xuzhihao-248/roboticArm/doc/tasks.md

# Dummy 机械臂任务拆分

> 基于 `proposal.md` 需求文档拆分 | 更新日期：2026/05/23

---

## 使用说明

- 每个任务标记状态：⬜ 待开始 / 🔄 进行中 / ✅ 完成 / ❌ 阻塞
- 带 `[前置]` 的任务需等待前面任务完成

---

## 一期：复刻原版 Dummy（第 1-12 周）

### T1.1 前置准备

| ID | 任务 | 预估时间 | 状态 |
|----|---|---|---|
| T1.1.1 | 搭建 Git 仓库，配置协作环境 | 0.5 天 | ✅ |
| T1.1.2 | 补习第零阶段知识（STM32/C++/机器人学/电子） | 2 周 | ⬜ |
| T1.1.3 | 安装 STM32CubeIDE、CubeMX、ST-LINK Utility | 0.5 天 | ⬜ |
| T1.1.4 | [前置] 购买 ST-Link V2 调试器、USB-CAN 调试器 | 下单即完成 | ⬜ |

### T1.2 PCB 打样与焊接

| ID | 任务 | 预估时间 | 状态 |
|----|---|---|---|
| T1.2.1 | 上传 MotorDriver-42 Gerber 到嘉立创下单（6 块） | 0.5 天 | ⬜ |
| T1.2.2 | [前置] 导出 Controller/MotorDriver-20/HandModule/LEDRing 的 Gerber | 1 天 | ⬜ |
| T1.2.3 | [前置] 上述 4 块板子下单打样 | 0.5 天 | ⬜ |
| T1.2.4 | [前置] 导出全部板子的 BOM 物料清单 | 1 天 | ⬜ |
| T1.2.5 | [前置] 采购电子元器件（电阻/电容/芯片/接插件） | 下单等待 | ⬜ |
| T1.2.6 | 焊接练习板练手（0603 + SOP-8 + LQFP-48） | 3 天 | ⬜ |
| T1.2.7 | 焊接 6 块 MotorDriver-42 驱动板 | 4 天 | ⬜ |
| T1.2.8 | 焊接 Controller 核心板 | 2 天 | ⬜ |
| T1.2.9 | 焊接 MotorDriver-20 / HandModule / LED Ring | 2 天 | ⬜ |

### T1.3 机械与装配

| ID | 任务 | 预估时间 | 状态 |
|----|---|---|---|
| T1.3.1 | 打开 STEP 模型测量各关节减速器安装空间 | 1 天 | ⬜ |
| T1.3.2 | 先买 1 个 CSF-17-30 谐波减速器样品确认接口 | 下单等待 | ⬜ |
| T1.3.3 | [前置] 样品确认后买齐 6 个减速器（J1-J6 不同型号） | 下单等待 | ⬜ |
| T1.3.4 | 采购 42 步进电机 ×6 + 20 步进电机 ×1 | 下单等待 | ⬜ |
| T1.3.5 | 采购 24V 开关电源 | 下单等待 | ⬜ |
| T1.3.6 | CNC 加工厂报价比价 | 2 天 | ⬜ |
| T1.3.7 | [前置] 确认图纸 → 下单 CNC 加工 | 等待加工 | ⬜ |
| T1.3.8 | [前置] CNC 件回来后检查公差、试组装 | 2 天 | ⬜ |
| T1.3.9 | 总装：结构件 + 减速器 + 电机 + 走线 | 3 天 | ⬜ |

### T1.4 固件烧录与调试

| ID | 任务 | 预估时间 | 状态 |
|----|---|---|---|
| T1.4.1 | 烧录电机驱动固件到 6 块 MotorDriver-42 | 0.5 天 | ⬜ |
| T1.4.2 | 逐块上电校准编码器，确认按键功能正常 | 1 天 | ⬜ |
| T1.4.3 | 烧录核心固件到 Controller | 0.5 天 | ⬜ |
| T1.4.4 | 配置各电机 CAN ID（6 个不同 ID） | 0.5 天 | ⬜ |
| T1.4.5 | CAN 总线调试：终端电阻、波特率、广播同步 | 2 天 | ⬜ |
| T1.4.6 | 零点归位校准测试 | 1 天 | ⬜ |

### T1.5 联调与验收

| ID | 任务 | 预估时间 | 状态 |
|----|---|---|---|
| T1.5.1 | CLI 工具环境搭建（Python + pyserial + python-can） | 0.5 天 | ⬜ |
| T1.5.2 | CLI 连接机械臂，发送单关节指令 | 1 天 | ⬜ |
| T1.5.3 | MoveJ 多关节同步运动测试 | 1 天 | ⬜ |
| T1.5.4 | 正逆运动学验证（给角度→末端到位姿，给位姿→角度） | 1 天 | ⬜ |
| T1.5.5 | 三种指令模式测试（SEQ/INT/TRJ） | 1 天 | ⬜ |
| T1.5.6 | DummyStudio 连接与图形化控制 | 1 天 | ⬜ |
| T1.5.7 | 整机验收：F1.1-F1.7 全部验收标准通过 | 1 天 | ⬜ |

---

## 二期：核心原理掌握（第 13-18 周）

| ID | 任务 | 产出 | 状态 |
|----|---|---|---|
| T2.1 | 阅读 `Robot/kinematics.cpp`，DH 参数推导验证 | DH 参数验证笔记 | ⬜ |
| T2.2 | 用 Python 实现正运动学（与固件结果对比） | `selfModel/kinematics/forward.py` | ⬜ |
| T2.3 | 用 Python 实现逆运动学（Pieper 准则求 8 组解） | `selfModel/kinematics/inverse.py` | ⬜ |
| T2.4 | 阅读 `Robot/trajectory.cpp`，理解梯形加减速 | 轨迹规划笔记 | ⬜ |
| T2.5 | Python 实现梯形加减速插值，可视化验证 | `selfModel/trajectory/planner.py` | ⬜ |
| T2.6 | 阅读 `Ctrl/` 电机控制代码（FOC/PID/编码器） | 控制算法笔记 | ⬜ |
| T2.7 | 修改 PID 参数对比效果 | PID 调参记录 | ⬜ |
| T2.8 | 阅读 `UserApp/interface_can.cpp`，理解 CAN 协议 | 协议文档 | ⬜ |
| T2.9 | 在固件中新增一个自定义 CAN 指令并验证 | 自定义指令测试通过 | ⬜ |
| T2.10 | 阅读 FreeRTOS 任务架构，新增一个测试 Task | 测试 Task 运行正常 | ⬜ |

---

## 三期：视觉抓取系统（第 19-28 周）

| ID | 任务 | 产出 | 状态 |
|----|---|---|---|
| T3.1 | 采购 RGB-D 相机，设计打印相机支架 | 相机 + 支架安装到位 | ⬜ |
| T3.2 | Eye-to-hand 手眼标定 | 标定矩阵，误差 < 2mm | ⬜ |
| T3.3 | 采集 3 种目标物体的 RGB-D 数据 | 数据集 | ⬜ |
| T3.4 | YOLOv8 训练物体检测模型 | 检测准确率 > 90% | ⬜ |
| T3.5 | 点云分割 + 3D 位姿估计 | 位姿误差 < 5mm | ⬜ |
| T3.6 | 实现抓取规划（几何分析 + 碰撞检测） | `selfModel/grasp/planner.py` | ⬜ |
| T3.7 | 封装抓取控制 API（检测→计算→抓取） | `selfModel/grasp/controller.py` | ⬜ |
| T3.8 | 单物体抓取集成测试 | 成功率 > 80% | ⬜ |
| T3.9 | 多物体场景抓取 | 能按指令选择目标 | ⬜ |

---

## 四期：移动底盘 + SLAM（第 29-38 周）

| ID | 任务 | 产出 | 状态 |
|----|---|---|---|
| T4.1 | 采购工控机（Jetson Nano）、激光雷达、底盘 | 硬件到位 | ⬜ |
| T4.2 | 工控机部署 ROS 2 Humble + 依赖包 | ROS 2 环境运行 | ⬜ |
| T4.3 | 底盘电机驱动调试（差速控制） | 底盘可控 | ⬜ |
| T4.4 | 激光雷达 ROS 驱动 + 数据可视化 | 点云正常显示 | ⬜ |
| T4.5 | SLAM 建图（Cartographer） | 室内地图生成 | ⬜ |
| T4.6 | Nav2 导航栈配置与测试 | 自主导航成功 | ⬜ |
| T4.7 | 机械臂-底盘集成（物理安装 + 通信） | 工控机 ↔ STM32 通信正常 | ⬜ |
| T4.8 | 定点停靠 + 操作任务集成测试 | 移动到目标→抓取→返回 | ⬜ |

---

## 五期：VLA 自然语言操控（第 39-50 周）

| ID | 任务 | 产出 | 状态 |
|----|---|---|---|
| T5.1 | 封装机械臂 Python 控制 API（关节/位姿/夹爪） | `selfModel/api/robot_api.py` | ⬜ |
| T5.2 | 部署 Whisper 语音识别 | 语音→文字可用 | ⬜ |
| T5.3 | 部署本地 LLM（Qwen2.5-VL）或接入 API | LLM 可调用 | ⬜ |
| T5.4 | 设计任务 Prompt，让 LLM 输出 API 调用序列 | Prompt 模板 | ⬜ |
| T5.5 | 实现单步指令（"抓起红色方块"） | 单步执行成功 | ⬜ |
| T5.6 | 实现多步指令（"把桌上的红色方块放到蓝色盒子里"） | 多步执行成功 | ⬜ |
| T5.7 | 加入视觉反馈闭环（执行→拍照确认→重试/继续） | 闭环纠错正常 | ⬜ |
| T5.8 | 端到端集成测试 | 自然语言操控机械臂完整演示 | ⬜ |

---

## 状态总览

| 阶段 | 任务数 | 完成 | 进度 |
|---|---|---|---|
| 一期 | 27 | 1 | 4% |
| 二期 | 10 | 0 | 0% |
| 三期 | 9 | 0 | 0% |
| 四期 | 8 | 0 | 0% |
| 五期 | 8 | 0 | 0% |
| **合计** | **62** | **1** | **2%** |

---

## 当前阻塞项

（暂无）
