xuzhihao-248/roboticArm/doc/源项目解读/电路板解析.md

# Dummy Robot 电路板解析

> 硬件来源：`my/HardWarePCB/MotorDriver-42/`
> 固件来源：`raw/dummy/zhihui原版/Dummy-Robot-main/Firmware/`
> 工具：Altium Designer（.SchDoc / .PcbDoc）
> 更新：2026/06/07

---

## 一、总览

驱动板（MotorDriver-42）是一块**完整的步进电机闭环驱动器**，每块板独立控制一个电机，6 个电机通过 CAN 总线菊花链串联。

| 组件 | 型号 | 作用 |
|---|---|---|
| MCU | **STM32F103CBT6** | Cortex-M3，电机控制算法 + CAN 通信 |
| 电机驱动 | **TB67H450**（东芝） | 双 H 桥，驱动两相步进电机 |
| 编码器 | **MT6816**（MagnTek） | 14-bit 磁编码器，SPI 接口，位置反馈 |
| CAN 收发器 | **SN65HVD232DR** | CAN 2.0 差分信号收发 |
| 电源 | **ME3116** DC-DC + **LP2992** 3.3V LDO | 降压到 5V 后经 LDO 出 3.3V（供 MCU） |
| 电压基准 | **TL431IDBZT** | 精密电压基准 |
| 升压 | **TPS61040DBV** | 升压转换器 |
| 状态灯 | 2× **WS2812B** RGB LED | 可编程指示灯（通信/错误状态） |
| 晶振 | 12MHz HSE | 外部高速时钟 |

---

## 二、原理图详解

PDF 文件：`my/HardWarePCB/MotorDriver-42/Motor-42.pdf`（Altium Designer 导出，共 4 页）

### 2.1 MCU Sheet — 主控与通信

```
                    ┌─────────────────┐
    CAN_H/CAN_L ───┤  SN65HVD232DR   │
                    │  CAN 收发器      │
                    └────────┬────────┘
                             │ TX/RX
                    ┌────────┴────────┐
    SWDIO/SWCLK ───┤  STM32F103CBT6  │
                    │  主控 MCU        │
                    └──┬────┬────┬───┘
                       │    │    │
              J3(编码器) J2(接口) WS2812B×2
              SPI       GPIO    状态灯
```

**关键器件：**

| 器件 | 型号 | 引脚/接口 |
|---|---|---|
| U3 | **STM32F103CBT6** | SWDIO(PA13)、SWCLK(PA14)、CAN_TX(PA12)、CAN_RX(PA11) |
| U4 | **SN65HVD232DR** | CANH → J2.2、CANL → J2.1 |
| U6 | ME3116 | DC-DC 降压，VIN → 5V |
| U7 | LP2992-3.3 | 3.3V LDO，供 MCU |
| U4 | TL431IDBZT | 精密电压基准 |
| U11 | TPS61040DBV | 升压转换器 |
| U1 | 12MHz 晶振 | OSC_IN(PD0)、OSC_OUT(PD1) |
| LED1、LED2 | **WS2812B** | 数据线串联，可编程 RGB |
| SW1、SW2 | 按键 | 配置/复位 |
| J1 | 电源接口 | VIN(+) / GND(-) |
| J2 | CAN + 按钮 + GPIO | 见下方引脚表 |
| J3 | 编码器接口 | SPI 信号（CLK/IO1/IO2） |
| J4 | SWD 调试接口 | SWDIO / SWCLK / 3V3 / GND |
| J5 | 预留 GPIO | PA1 / PA2 |

**J2 接口引脚表：**

| 引脚 | 信号 | 说明 |
|---|---|---|
| J2.1 | CAN_L | CAN 总线低 |
| J2.2 | CAN_H | CAN 总线高 |
| J2.3 | BUT | 按钮输入 |
| J2.4 | STNBY | TB67H450 待机控制（低电平待机） |
| J2.5 | PA3 | GPIO |
| J2.6 | PB4 | GPIO |

### 2.2 Drive Sheet — 电机驱动

```
        STM32F103
            │
    ┌───────┴───────┐
    │   TB67H450    │
    │  双 H 桥驱动   │
    ├───┬───┬───┬───┤
   Ap  Am  Bp  Bm   │  ← 两相步进电机线圈
    └───┴───┴───┴───┘
        │
    J7 (电机连接器)
```

**关键器件：**

| 器件 | 型号 | 作用 |
|---|---|---|
| U1 | **TB67H450** | 东芝双 H 桥步进电机驱动，支持 PWM 电流控制 |
| C7/C9/C12/C14 | 滤波电容 | 电荷泵和电源滤波 |
| J7 | 电机接口 | Ap / Am / Bp / Bm（两相四线） |

**TB67H450 引脚连接：**

| 引脚 | 连接 | 说明 |
|---|---|---|
| Ap、Am | J7 | A 相线圈正/负 |
| Bp、Bm | J7 | B 相线圈正/负 |
| VCC | 5V | 逻辑电源 |
| VM | VIN | 电机电源 |
| STNBY | J2.4 (PB5) | 待机控制，低电平进入待机 |
| AIN1/AIN2 | STM32 GPIO | A 相桥臂控制 |
| BIN1/BIN2 | STM32 GPIO | B 相桥臂控制 |
| PWMA/PWMB | STM32 TIM | PWM 电流调节 |

### 2.3 编码器接口 — J3

| 引脚 | 信号 | 说明 |
|---|---|---|
| CLK | SPI_SCK | MT6816 时钟 |
| IO1 | SPI_MOSI | MT6816 数据输出 |
| IO2 | SPI_MISO | MT6816 数据输入 |
| 3V3 | 供电 | 3.3V |
| GND | 地 | — |

---

## 三、固件与硬件对应关系

固件路径：`raw/dummy/zhihui原版/Dummy-Robot-main/Firmware/Ctrl-Step-Driver-STM32F1-fw/`

### 3.1 MCU — STM32F103CBT6

| 验证项 | 固件文件 | 说明 |
|---|---|---|
| HAL 库 | `Core/Inc/stm32f1xx_hal_conf.h` :21 | `#ifndef __STM32F1xx_HAL_CONF_H` |
| 中断处理 | `Core/Src/stm32f1xx_it.c` | STM32F1 中断向量表 |
| HAL 驱动 | `Drivers/STM32F1xx_HAL_Driver/` | STM32F1 系列 HAL 库 |
| 启动文件 | `startup/` | STM32F103 启动汇编 |

### 3.2 电机驱动 — TB67H450

| 验证项 | 固件文件 | 行号 | 内容 |
|---|---|---|---|
| 驱动类定义 | `Ctrl/Driver/tb67h450_base.h` | :6 | `class TB67H450Base : public DriverBase` |
| FOC 电流控制 | `Ctrl/Driver/tb67h450_base.h` | :14 | `SetFocCurrentVector()` |
| 双线圈驱动 | `Ctrl/Driver/tb67h450_base.h` | :22 | `SetTwoCoilsCurrent()` — 对应 TB67H450 的 A/B 两相 |
| GPIO 初始化 | `Ctrl/Driver/tb67h450_base.h` | :27 | `InitGpio()` |
| PWM 初始化 | `Ctrl/Driver/tb67h450_base.h` | :29 | `InitPwm()` |

### 3.3 编码器 — MT6816

| 验证项 | 固件文件 | 说明 |
|---|---|---|
| 编码器驱动 | `Ctrl/Sensor/Encoder/mt6816_base.h` | MT6816 磁编码器 SPI 读取 |
| 编码器基类 | `Ctrl/Sensor/Encoder/encoder_base.h` | 编码器抽象接口 |
| 校准器 | `Ctrl/Sensor/Encoder/encoder_calibrator_base.h` | 编码器零位校准 |

### 3.4 CAN 通信 — TJA1051T/3

| 验证项 | 固件文件 | 说明 |
|---|---|---|
| CAN 初始化 | `Core/Inc/can.h` | CAN 外设配置 |
| CAN 收发 | `Core/Src/can.c` | CAN 报文收发实现 |

### 3.5 电机参数（固件默认值）

| 参数 | 值 | 来源 |
|---|-----|---|
| 步距角 | 1.8°（200 步/圈） | `Ctrl/Motor/motor.h` :45 |
| 细分数 | 256 | `Ctrl/Motor/motor.h` :46 |
| 每圈微步数 | 51200 | `motor.h` :47（200×256） |
| 额定电流 | 1000 mA | `motor.h` :17 |
| 校准电流 | 2000 mA | `motor.h` :16 |
| 额定转速 | 30 r/s | `motor.h` :19 |
| 控制频率 | 20 kHz | `motor.h` :192（`Tick20kHz()`） |
| 控制算法 | PID + DCE | `motor.h` :23~35 |

### 3.6 系统时钟配置（HSE_VALUE）

> **背景**：从 BOM 核实到硬件晶振为 12MHz，需验证固件时钟配置是否匹配。

**结论：硬件 12MHz = 固件 12MHz，完全匹配。**

配置生效逻辑：

```
工程编译时 include 顺序：
  1. Core/Inc/stm32f1xx_hal_conf.h :86  →  #define HSE_VALUE  12000000U  ← 先定义
  2. Core/Src/system_stm32f1xx.c  :77  →  #if !defined(HSE_VALUE)         ← 发现已定义，跳过默认值
                                          #define HSE_VALUE  8000000U     ← 此行不生效！
```

| 文件 | 行号 | 内容 | 生效? |
|---|---|---|---|
| `Core/Inc/stm32f1xx_hal_conf.h` | :86 | `#define HSE_VALUE  12000000U` | ✅ 实际生效 |
| `Core/Src/system_stm32f1xx.c` | :78 | `#define HSE_VALUE  8000000U` | ❌ 被 `#if !defined` 跳过 |

> 之前文档误写为 8MHz 是因为只查看了 `system_stm32f1xx.c` 的默认值，未注意到 `hal_conf.h` 中已用 `#if !defined` 宏保护做了覆盖。

**关联影响**：HSE_VALUE 直接影响 STM32 的 PLL 倍频计算、CAN 波特率分频、定时器时钟源。如果晶振频率和固件配置不一致，CAN 总线将无法通信。

---

## 四、CAN 总线拓扑

```
PC ←USB→ Controller（STM32F4 主控）
                │
            CAN 总线（菊花链）
                │
    ┌──┬──┬──┬──┬──┬──┐
   MD1 MD2 MD3 MD4 MD5 MD6   ← 每块 MotorDriver-42 板
   ID=1 ID=2 ID=3 ID=4 ID=5 ID=6
```

- 物理层：CAN 2.0，SN65HVD232DR 收发器
- 每块驱动板有唯一 CAN ID（1~6）
- Controller 转发 PC 指令 → 各驱动板本地闭环控制
- 也可跳过 Controller，PC 通过 USB-CAN 适配器直接发 CAN 指令

---

## 五、使用方式

### 5.1 打样 PCB

1. 将 `my/HardWarePCB/MotorDriver-42/Gerber/` 目录打包为 zip
2. 上传到嘉立创（jlc.com）→ 下单 PCB 打样
3. 5 片约 ¥5~20，5~7 天到货

### 5.2 焊接

1. 打开 `my/HardWarePCB/MotorDriver-42/Motor-42.pdf` 查看原理图
2. 按原理图中的器件型号采购 BOM
3. 焊接顺序建议：电源（AMS1117）→ MCU（STM32F103）→ CAN（TJA1051T）→ 驱动（TB67H450）→ 连接器

### 5.3 烧录固件

**方式一：直接烧 HEX（最快）**

`raw/dummy/.../Firmware/_Released HEX/Ctrl-Step-Driver-STM32F1-fw.hex`
用 ST-Link 连接 J4（SWD 接口），通过 STM32CubeProgrammer 烧录。

**方式二：自行编译**

用 CLion / STM32CubeIDE 打开 `Firmware/Ctrl-Step-Driver-STM32F1-fw/` 工程，编译后烧录。

### 5.4 上位机调试

- **CLI-Tool**：Python 命令行，通过 USB（Fibre 协议）与 Controller 通信
- **DummyStudio**：Unity 桌面应用，图形化控制界面

---

## 六、与本项目的关系

```
MoveIt2 规划 → USB-CAN → Controller 主控板 → CAN 总线 → 6× MotorDriver-42 → 6 个步进电机
```

- Controller 板接收上位机指令，通过 CAN 分发给各驱动板
- 每块驱动板运行 FOC 闭环控制，本地完成位置/速度/电流控制
- 跳过 Controller：PC 通过 USB-CAN 适配器直接发 CAN 指令给驱动板
