xuzhihao-248/roboticArm/doc/源项目解读/固件解析.md

# Dummy Robot 固件解析

> 来源：`raw/dummy/zhihui原版/Dummy-Robot-main/Firmware/`
> 更新：2026/06/07

---

## 一、总览

Firmware 目录下有**两个独立固件工程**，分别对应两块电路板：

| 固件 | 目标芯片 | 对应电路板 | 作用 |
|---|---|---|---|
| **Ctrl-Step-Driver-STM32F1-fw** | STM32F103CBT6 | MotorDriver-42 | 单电机闭环驱动（每块板一个） |
| **Core-STM32F4-fw** | STM32F405RGTx | Controller 主控板 | 6 轴运动协调 + USB/UART/CAN 通信 |

预编译 HEX：`_Released HEX/Ctrl-Step-Driver-STM32F1-fw.hex`（驱动板固件，可直接烧录）

---

## 二、Ctrl-Step-Driver-STM32F1-fw（驱动板固件）

路径：`Firmware/Ctrl-Step-Driver-STM32F1-fw/`

### 2.1 架构

```
UserApp/main.cpp（入口）
    ├── Motor（电机控制核心）
    │   ├── TB67H450（驱动芯片）
    │   ├── MT6816（编码器）
    │   ├── MotionPlanner（轨迹规划）
    │   └── Controller（PID/DCE 闭环）
    ├── CAN 协议（接收 Controller 指令）
    ├── Button × 2（按键交互）
    ├── LED（状态指示）
    └── EEPROM（参数持久化）
```

### 2.2 目录结构

```
Ctrl-Step-Driver-STM32F1-fw/
├── Core/                           ← STM32 HAL 库自动生成
│   ├── Inc/                        ← 头文件（can.h, spi.h, tim.h, gpio.h...）
│   └── Src/                        ← 源文件（can.c, spi.c, tim.c, gpio.c...）
├── Drivers/                        ← STM32 HAL 驱动库
├── Ctrl/                           ← 电机控制算法（核心代码）
│   ├── Driver/
│   │   ├── driver_base.h           ← 驱动芯片抽象基类
│   │   ├── tb67h450_base.h/.cpp    ← TB67H450 驱动实现
│   │   └── sin_map.h               ← FOC 正弦表
│   ├── Motor/
│   │   ├── motor.h/.cpp            ← 电机控制核心类
│   │   └── motion_planner.h/.cpp   ← 轨迹规划器
│   └── Signal/
│       ├── button_base.h/.cpp      ← 按键处理
│       └── led_base.h/.cpp         ← LED 控制
├── Port/                           ← 硬件适配层（STM32 平台相关）
│   ├── tb67h450_stm32.h/.cpp      ← TB67H450 的 STM32 GPIO/PWM 实现
│   ├── mt6816_stm32.h/.cpp         ← MT6816 的 SPI 实现
│   ├── encoder_calibrator_stm32.h/.cpp  ← 编码器校准
│   ├── button_stm32.h/.cpp         ← 按键 GPIO 实现
│   ├── led_stm32.h/.cpp            ← LED GPIO 实现
│   └── Platform/
│       ├── retarget.c              ← printf 重定向
│       └── Memory/                 ← EEPROM 模拟
├── UserApp/                        ← 用户应用层
│   ├── main.cpp                    ← 主入口
│   ├── configurations.h            ← 板级配置结构体
│   ├── common_inc.h                ← 公共头文件
│   └── protocols/
│       ├── interface_can.cpp       ← CAN 协议解析（核心）
│       └── interface_uart.cpp      ← UART 协议
├── startup/                        ← 启动文件
│   └── startup_stm32f103xb.s
├── STM32F103CBTx_FLASH.ld          ← 链接脚本
└── stlink.cfg                      ← ST-Link 调试配置
```

### 2.3 主入口（main.cpp）

启动流程：

```
Main()
  ├── 根据 STM32 序列号分配默认 CAN Node ID（1~6）
  ├── 从 EEPROM 读取配置（首次使用写入默认值）
  ├── 初始化电机：motor.AttachDriver(&tb67H450)
  │               motor.AttachEncoder(&mt6816)
  ├── 初始化按键和 LED
  ├── 启动定时器：
  │   ├── TIM1 → 100Hz（按键扫描 + LED 更新）
  │   └── TIM4 → 20kHz（电机闭环控制）
  └── 主循环：编码器校准 + EEPROM 写入
```

**CAN Node ID 分配（按序列号）：**

| 序列号 | Node ID | 接口 |
|---|---|---|
| 431466563640 | 1 | J1 |
| 384624576568 | 2 | J2 |
| 384290670648 | 3 | J3 |
| 431531051064 | 4 | J4 |
| 431466760248 | 5 | J5 |
| 431484848184 | 6 | J6 |

> **关键代码位置：** `UserApp/main.cpp` :22-47

### 2.4 电机控制核心（Motor 类）

文件：`Ctrl/Motor/motor.h` + `motor.cpp`

**默认参数：**

| 参数 | 值 | 代码位置 |
|---|-----|---|
| 每圈硬步数 | 200（1.8°步距角） | `motor.h` :45 |
| 细分数 | 256 | `motor.h` :46 |
| 每圈微步数 | 51200 | `motor.h` :47 |
| 额定电流 | 1000 mA | `motor.h` :17 |
| 校准电流 | 2000 mA | `motor.h` :16 |
| 额定转速 | 30 r/s | `motor.h` :19 |
| PID 参数 | Kp=5, Ki=30, Kd=0 | `motor.h` :23-25 |
| DCE 参数 | Kp=200, Kv=80, Ki=300, Kd=250 | `motor.h` :29-33 |

**控制模式：**

| 模式 | 枚举值 | 说明 |
|---|---|---|
| MODE_STOP | 0 | 停止 |
| MODE_COMMAND_POSITION | 1 | 位置指令 |
| MODE_COMMAND_VELOCITY | 2 | 速度指令 |
| MODE_COMMAND_CURRENT | 3 | 电流/力矩指令 |
| MODE_COMMAND_Trajectory | 4 | 轨迹规划（MoveIt 用） |
| MODE_PWM_POSITION | 5 | PWM 位置 |
| MODE_PWM_VELOCITY | 6 | PWM 速度 |
| MODE_PWM_CURRENT | 7 | PWM 电流 |
| MODE_STEP_DIR | 8 | 脉冲+方向（传统步进） |

> **关键代码位置：** `motor.h` :49-60

**控制频率：** 20kHz（TIM4 中断调用 `motor.Tick20kHz()`）

> **关键代码位置：** `UserApp/main.cpp` :139-147（`Tim4Callback20kHz()`）

### 2.5 TB67H450 驱动

文件：`Ctrl/Driver/tb67h450_base.h` + `Port/tb67h450_stm32.cpp`

| 方法 | 作用 |
|---|---|
| `Init()` | 初始化 GPIO 和 PWM |
| `SetFocCurrentVector(direction, current_mA)` | FOC 电流矢量控制 |
| `SetTwoCoilsCurrent(A, B)` | 设置 A/B 两相电流 |
| `Sleep()` | 进入待机模式 |
| `Brake()` | 刹车 |

### 2.6 MT6816 编码器

文件：`Ctrl/Sensor/Encoder/mt6816_base.h` + `Port/mt6816_stm32.cpp`

- 14-bit 磁编码器（16384 分辨率）
- SPI 接口读取角度
- 支持零位校准（`EncoderCalibrator`）

### 2.7 板级配置（EEPROM 持久化）

文件：`UserApp/configurations.h`

```c
typedef struct Config_t {
    configStatus_t configStatus;     // 配置状态
    uint32_t canNodeId;              // CAN 节点 ID（1~6）
    int32_t encoderHomeOffset;       // 编码器零位偏移
    uint32_t defaultMode;            // 默认控制模式
    int32_t currentLimit;            // 电流限制（mA）
    int32_t velocityLimit;           // 速度限制（微步/秒）
    int32_t velocityAcc;             // 加速度（微步/秒²）
    int32_t calibrationCurrent;      // 校准电流（mA）
    int32_t dce_kp, dce_kv, dce_ki, dce_kd;  // DCE 控制参数
    bool enableMotorOnBoot;          // 上电自动使能
    bool enableStallProtect;         // 堵转保护
} BoardConfig_t;
```

> **关键代码位置：** `UserApp/configurations.h` :19-35

---

## 三、Core-STM32F4-fw（主控板固件）

路径：`Firmware/Core-STM32F4-fw/`

### 3.1 架构

```
UserApp/main.cpp（入口，FreeRTOS 多线程）
    ├── DummyRobot（机器人实例）
    │   ├── CtrlStepMotor × 6（6 个关节电机代理）
    │   ├── DummyHand（末端手爪）
    │   ├── DOF6Kinematic（6 自由度运动学求解器）
    │   └── CommandHandler（命令队列解析）
    ├── Communication（USB + UART + CAN）
    ├── MPU6050（IMU 姿态传感器）
    ├── SSD1306 OLED（显示屏）
    └── PWM（LED/蜂鸣器）
```

### 3.2 目录结构

```
Core-STM32F4-fw/
├── Core/                           ← STM32 HAL 自动生成
├── Drivers/                        ← STM32F4 HAL 驱动库
├── Middlewares/                     ← FreeRTOS
├── Bsp/                            ← 板级支持包
│   ├── communication/
│   │   ├── communication.cpp/hpp   ← 通信初始化
│   │   ├── interface_usb.cpp/hpp   ← USB CDC/VCP
│   │   ├── interface_uart.cpp/hpp  ← UART
│   │   ├── interface_can.cpp/hpp   ← CAN
│   │   └── ascii_processor.cpp/hpp ← ASCII 协议处理
│   ├── gpio/
│   │   ├── analog.cpp/hpp          ← ADC
│   │   ├── encoder.cpp/hpp         ← 编码器接口
│   │   └── pwm.cpp/hpp             ← PWM 输出
│   ├── imu/
│   │   ├── MPU6050.cpp/hpp         ← MPU6050 驱动
│   │   └── i2c_dev.cpp/hpp         ← I2C 设备
│   ├── memory/
│   │   └── emulated_eeprom.cpp/h   ← Flash 模拟 EEPROM
│   └── utils/
│       ├── timer.cpp/hpp           ← 定时器封装
│       └── time_utils.c/h          ← 时间工具
├── Robot/                          ← 机器人逻辑（核心）
│   ├── instances/
│   │   ├── dummy_robot.h/cpp       ← DummyRobot 类（6 轴控制）
│   │   └── dummy_robot.h           ← 6 关节参数定义
│   ├── actuators/
│   │   ├── ctrl_step/
│   │   │   ├── ctrl_step.hpp/cpp   ← CtrlStepMotor 类（CAN 代理）
│   │   └── mintasca/               ← 备用执行器（未使用）
│   └── algorithms/
│       └── kinematic/
│           └── 6dof_kinematic.h/cpp ← 6 自由度正/逆运动学
├── UserApp/                        ← 用户应用层
│   ├── main.cpp                    ← FreeRTOS 线程定义
│   ├── common_inc.h
│   └── protocols/
│       ├── can_protocol.cpp        ← CAN 消息回调
│       ├── ascii_protocol.cpp      ← ASCII 命令协议
│       └── cmd_protocol.cpp        ← 命令协议
├── USB_DEVICE/                     ← USB 设备驱动
├── REF-STM32F4-fw.ioc              ← STM32CubeMX 工程文件
├── STM32F405RGTx_FLASH.ld          ← 链接脚本
└── stlink.cfg
```

### 3.3 FreeRTOS 线程

文件：`UserApp/main.cpp`

| 线程 | 优先级 | 频率 | 作用 |
|---|---|---|---|
| **ControlLoopFixUpdate** | Realtime | 200Hz（Timer7） | 发送控制指令 + 更新关节状态 |
| **ControlLoopUpdate** | Normal | 阻塞等待 | 解析命令队列 |
| **OledTask** | Normal | 持续运行 | 更新 OLED 显示（IMU、关节角度、位姿） |

**控制循环流程（200Hz）：**

```
Timer7 中断 → 唤醒 ControlLoopFixUpdate 线程
    ├── 如果已使能：
    │   ├── SEQUENTIAL / INTERRUPTABLE / TRAJECTORY 模式：
    │   │   ├── MoveJoints(targetJoints) → 通过 CAN 发送目标角度给各驱动板
    │   │   └── UpdateJointPose6D() → 正运动学计算当前位姿
    │   └── MOTOR_TUNING 模式：
    │       └── tuningHelper.Tick() → 调试用正弦波运动
    └── 如果未使能：
        ├── UpdateJointAngles() → 读取各关节当前角度
        └── UpdateJointPose6D() → 正运动学
```

> **关键代码位置：** `UserApp/main.cpp` :17-48

### 3.4 DummyRobot 类

文件：`Robot/instances/dummy_robot.h` + `dummy_robot.cpp`

**默认姿态和参数：**

| 参数 | 值 | 代码位置 |
|---|-----|---|
| 上电姿态 REST_POSE | {0, -73, 180, 0, 0, 0} | `dummy_robot.h` :107 |
| 默认关节速度 | 30 °/s | `dummy_robot.h` :108 |
| 默认加速度基值 | {150, 100, 200, 200, 200, 200} | `dummy_robot.h` :109 |
| 默认命令模式 | COMMAND_TARGET_POINT_INTERRUPTABLE | `dummy_robot.h` :112 |

**命令模式：**

| 模式 | 说明 |
|---|---|
| COMMAND_TARGET_POINT_SEQUENTIAL | 顺序到达目标点（等一个到了再下一个） |
| COMMAND_TARGET_POINT_INTERRUPTABLE | 可打断的目标点（新指令覆盖旧的） |
| COMMAND_CONTINUES_TRAJECTORY | 连续轨迹模式 |
| COMMAND_MOTOR_TUNING | 电机调试模式 |

**6 关节 DCE 参数：**

| 关节 | current_limit | acceleration | dce_kp | dce_kv | dce_ki | dce_kd |
|---|---|---|---|---|---|---|
| Joint1 | 2A | 30 | 1000 | 80 | 200 | 250 |
| Joint2 | 2A | 30 | 1000 | 80 | 200 | 200 |
| Joint3 | 2A | 30 | 1500 | 80 | 200 | 250 |
| Joint4 | 2A | 30 | 1000 | 80 | 200 | 250 |
| Joint5 | 2A | 30 | 1000 | 80 | 200 | 250 |
| Joint6 | 2A | 30 | 1000 | 80 | 200 | 250 |

> **关键代码位置：** `Robot/instances/dummy_robot.h` :10-18

**Fibre 协议暴露的接口（PC 可调用）：**

| 接口 | 类型 | 说明 |
|---|---|---|
| `calibrate_home_offset` | function | 校准零位 |
| `homing` | function | 回零 |
| `resting` | function | 回休息姿态 |
| `move_j(j1~j6)` | function | 关节空间运动 |
| `move_l(x,y,z,a,b,c)` | function | 笛卡尔空间运动 |
| `set_joint_speed(speed)` | function | 设置关节速度 |
| `set_joint_acc(acc)` | function | 设置加速度 |
| `set_command_mode(mode)` | function | 设置命令模式 |
| `set_enable(enable)` | function | 使能/失能 |
| `reboot` | function | 重启 |
| `joint_1` ~ `joint_6` | object | 各关节子对象 |
| `joint_all` | object | 全部关节（广播） |
| `hand` | object | 末端手爪 |
| `tuning` | object | 调试工具 |

> **关键代码位置：** `Robot/instances/dummy_robot.h` :145-167

### 3.5 CtrlStepMotor（CAN 代理类）

文件：`Robot/actuators/ctrl_step/ctrl_step.hpp` + `ctrl_step.cpp`

这是主控板上**代表一个驱动板的代理对象**，通过 CAN 发送指令给对应的 MotorDriver。

| 方法 | CAN 命令 | 说明 |
|---|---|---|
| `SetEnable(true)` | 0x01 | 使能电机 |
| `DoCalibration()` | 0x02 | 触发编码器校准 |
| `SetCurrentSetPoint(val)` | 0x03 | 设置电流目标 |
| `SetVelocitySetPoint(val)` | 0x04 | 设置速度目标 |
| `SetPositionSetPoint(val)` | 0x05 | 设置位置目标 |
| `SetPositionWithVelocityLimit(pos, vel)` | 0x07 | 位置+速度限制 |
| `SetNodeID(id)` | 0x11 | 设置 CAN ID（写入 EEPROM） |
| `SetCurrentLimit(val)` | 0x12 | 设置电流限制 |
| `SetVelocityLimit(val)` | 0x13 | 设置速度限制 |
| `SetAcceleration(val)` | 0x14 | 设置加速度 |
| `ApplyPositionAsHome()` | 0x15 | 当前位置设为零位 |
| `SetEnableOnBoot(val)` | 0x16 | 上电自动使能 |
| `SetDceKp/Kv/Ki/Kd(val)` | 0x17-0x1A | 设置 DCE 参数 |
| `SetEnableStallProtect(val)` | 0x1B | 堵转保护 |
| `Reboot()` | 0x7F | 重启驱动板 |
| `EraseConfigs()` | 0x7E | 擦除配置 |

> **关键代码位置：** `Robot/actuators/ctrl_step/ctrl_step.hpp` :31-51

### 3.6 6 自由度运动学

文件：`Robot/algorithms/kinematic/6dof_kinematic.h` + `6dof_kinematic.cpp`

- 正运动学：关节角度 → 末端位姿（XYZ + ABC 欧拉角）
- 逆运动学：末端位姿 → 关节角度
- 使用 DH 参数法

---

## 四、CAN 协议详解

### 4.1 帧格式

CAN ID 编码：`StdId = (NodeID << 7) | Command`

| 字段 | 位 | 说明 |
|---|-----|---|
| NodeID | [10:7] | 驱动板 ID（1~6），0 表示广播 |
| Command | [6:0] | 命令码（0x00~0x7F） |

### 4.2 命令表

**控制命令（0x00~0x0F）— 不写入 EEPROM：**

| 命令 | 数据 | 说明 |
|---|---|---|
| 0x01 | uint32: 1=enable, 0=disable | 使能/失能电机 |
| 0x02 | — | 触发编码器校准 |
| 0x03 | float: current(A) | 设置电流目标 |
| 0x04 | float: velocity(r/s) | 设置速度目标 |
| 0x05 | float: position(r) + uint8: needAck | 设置位置目标 |
| 0x06 | float: position(r) + float: time(s) | 位置+时间 |
| 0x07 | float: position(r) + float: vel_limit(r/s) | 位置+速度限制 |

**配置命令（0x10~0x1F）— 写入 EEPROM：**

| 命令 | 数据 | 说明 |
|---|---|---|
| 0x11 | uint32: nodeID | 设置 CAN ID |
| 0x12 | float: current(A) | 设置电流限制 |
| 0x13 | float: velocity(r/s) | 设置速度限制 |
| 0x14 | float: acceleration(r/s²) | 设置加速度 |
| 0x15 | — | 当前位置设为零位 |
| 0x16 | uint32: 1=enable | 上电自动使能 |
| 0x17 | int32: kp | DCE Kp |
| 0x18 | int32: kv | DCE Kv |
| 0x19 | int32: ki | DCE Ki |
| 0x1A | int32: kd | DCE Kd |
| 0x1B | uint32: 1=enable | 堵转保护 |

**查询命令（0x20~0x2F）— 驱动板返回数据：**

| 命令 | 返回数据 | 说明 |
|---|---|---|
| 0x21 | float: current(A) + uint8: state | 读取电流 |
| 0x22 | float: velocity(r/s) + uint8: state | 读取速度 |
| 0x23 | float: position(r) + uint8: state | 读取位置 |
| 0x24 | int32: offset | 读取零位偏移 |

**系统命令：**

| 命令 | 说明 |
|---|---|
| 0x7E | 擦除 EEPROM 配置 |
| 0x7F | 重启驱动板 |

> **关键代码位置：** `UserApp/protocols/interface_can.cpp` :20-238

### 4.3 CAN 回调（主控板侧）

主控板收到驱动板的 0x23 应答后：

```cpp
// can_protocol.cpp :28-29
case 0x23:
    dummy.motorJ[id]->UpdateAngleCallback(*(float*)(data), data[4]);
    break;
```

更新对应关节的角度，并触发 `UpdateJointAnglesCallback()` 刷新所有关节状态。

> **关键代码位置：** `UserApp/protocols/can_protocol.cpp` :17-42

---

## 五、完整通信链路

```
PC（CLI-Tool / DummyStudio）
    │ USB（Fibre 协议，Endpoint RPC）
    ↓
Controller（STM32F4，FreeRTOS）
    │ DummyRobot::MoveJoints() → CtrlStepMotor::SetPositionSetPoint()
    ↓
CAN 总线（StdId = NodeID<<7 | 0x05）
    ↓
MotorDriver × 6（STM32F1）
    │ OnCanCmd(0x05) → motor.controller->SetPositionSetPoint()
    ↓
TB67H450 → 步进电机
    ↑
MT6816 编码器反馈 → motor.Tick20kHz() 闭环控制
```

---

## 六、烧录与调试

### 6.1 驱动板烧录

**方式一：直接烧 HEX**

```bash
# 使用 ST-Link + STM32CubeProgrammer
STM32_Programmer_CLI -c port=SWD -w "_Released HEX/Ctrl-Step-Driver-STM32F1-fw.hex" -v -rst
```

**方式二：编译后烧录**

用 CLion / STM32CubeIDE 打开 `Ctrl-Step-Driver-STM32F1-fw/` 工程，编译后通过 ST-Link 烧录。

### 6.2 主控板烧录

用 CLion / STM32CubeIDE 打开 `Core-STM32F4-fw/` 工程（STM32CubeMX 工程文件：`REF-STM32F4-fw.ioc`）。

### 6.3 调试接口

| 接口 | 配置文件 |
|---|---|
| SWD | `stlink.cfg`（两个工程都有） |
| UART | 驱动板：`interface_uart.cpp`；主控板：`interface_uart.hpp` |
| USB | 主控板：`interface_usb.cpp`（CDC/VCP） |

---

## 七、关键源码索引

### 驱动板（Ctrl-Step-Driver-STM32F1-fw）

| 功能 | 文件 | 关键行号 |
|---|---|---|
| 主入口 + 初始化 | `UserApp/main.cpp` | :20-125 |
| 定时器回调（100Hz/20kHz） | `UserApp/main.cpp` | :129-147 |
| 板级配置结构体 | `UserApp/configurations.h` | :19-35 |
| CAN 协议解析 | `UserApp/protocols/interface_can.cpp` | :20-238 |
| 电机控制核心 | `Ctrl/Motor/motor.h` | :1-204 |
| 控制模式枚举 | `Ctrl/Motor/motor.h` | :49-60 |
| 电机参数默认值 | `Ctrl/Motor/motor.h` | :15-35 |
| TB67H450 驱动 | `Ctrl/Driver/tb67h450_base.h` | :1-37 |
| MT6816 编码器 | `Port/mt6816_stm32.cpp` | 全文 |
| 编码器校准 | `Port/encoder_calibrator_stm32.cpp` | 全文 |
| 轨迹规划器 | `Ctrl/Motor/motion_planner.h` | 全文 |

### 主控板（Core-STM32F4-fw）

| 功能 | 文件 | 关键行号 |
|---|---|---|
| FreeRTOS 线程定义 | `UserApp/main.cpp` | :17-117 |
| 控制循环（200Hz） | `UserApp/main.cpp` | :17-48 |
| OLED 显示任务 | `UserApp/main.cpp` | :61-117 |
| DummyRobot 类定义 | `Robot/instances/dummy_robot.h` | :56-205 |
| 6 关节参数表 | `Robot/instances/dummy_robot.h` | :10-18 |
| 上电默认姿态 | `Robot/instances/dummy_robot.h` | :107 |
| Fibre 协议接口 | `Robot/instances/dummy_robot.h` | :145-167 |
| CtrlStepMotor CAN 代理 | `Robot/actuators/ctrl_step/ctrl_step.hpp` | :7-95 |
| CAN 命令映射 | `Robot/actuators/ctrl_step/ctrl_step.hpp` | :59-85 |
| 6DOF 运动学 | `Robot/algorithms/kinematic/6dof_kinematic.h` | 全文 |
| CAN 回调 | `UserApp/protocols/can_protocol.cpp` | :17-42 |
