xuzhihao-248/roboticArm/my/selfHardWarePCB/MotorDriver/采购元件/images/0fd495e29b8a87a78a302904a6a648ad.jpg

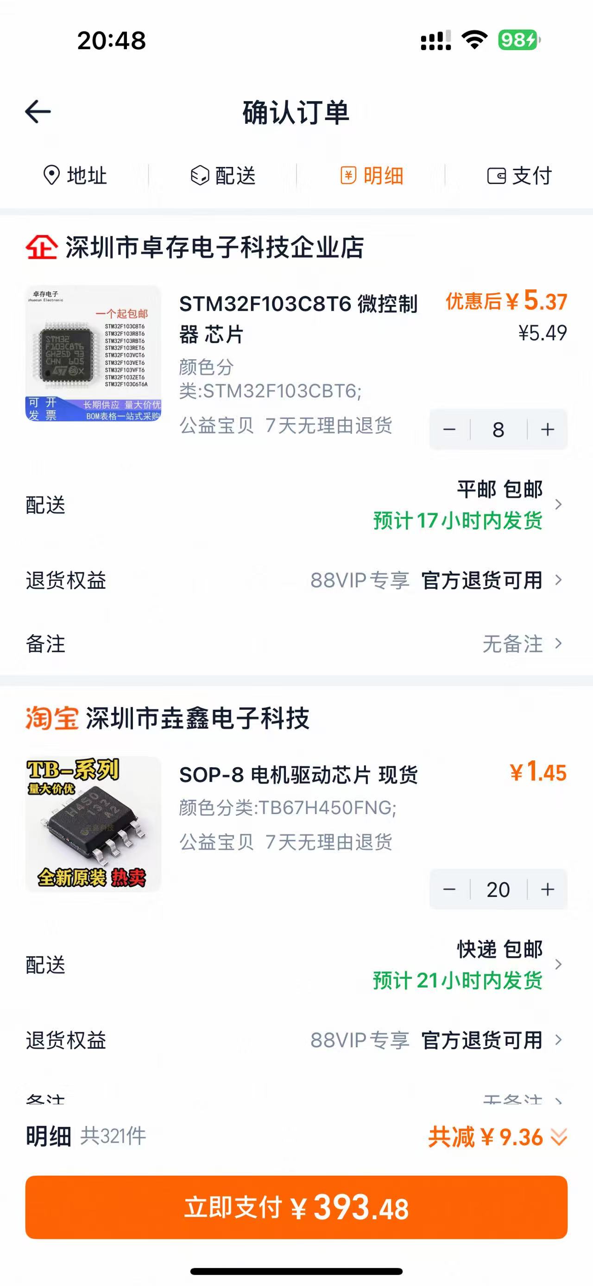
my/selfHardWarePCB/MotorDriver/采购元件/images/0fd495e29b8a87a78a302904a6a648ad.jpg
