xuzhihao-248/roboticArm/my/selfHardWarePCB/MotorDriver/采购元件/images/3cd6cb58a045ba54f0d6ba3ffff416e2.jpg

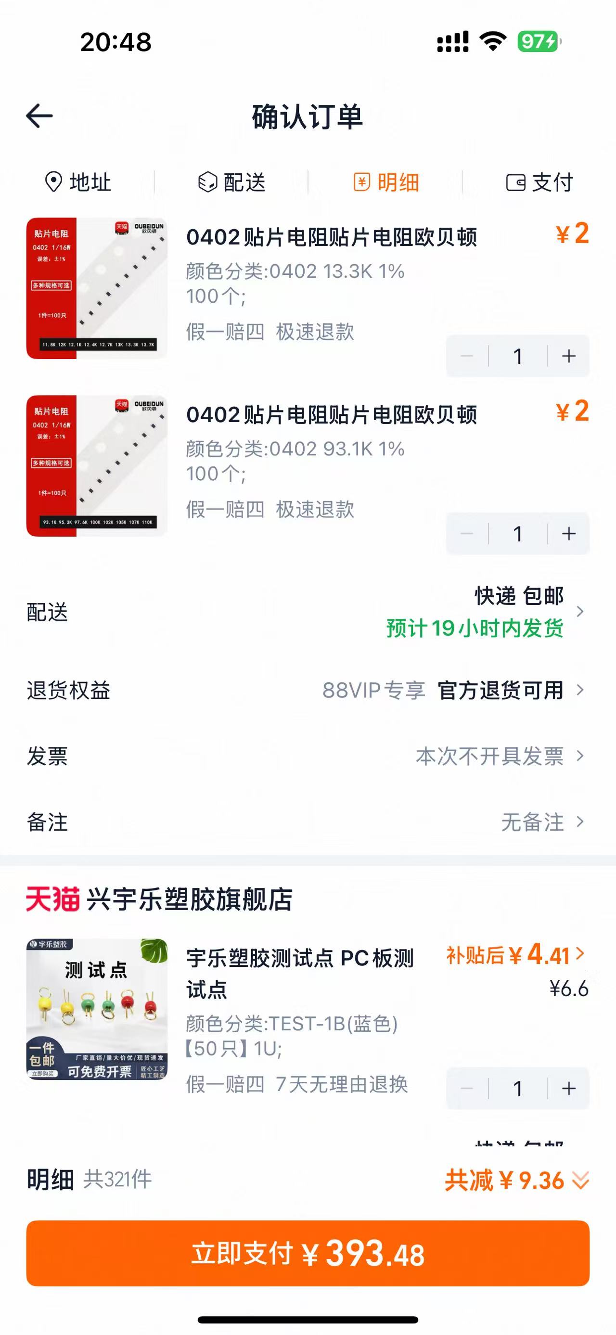
my/selfHardWarePCB/MotorDriver/采购元件/images/3cd6cb58a045ba54f0d6ba3ffff416e2.jpg
