xuzhihao-248/roboticArm/my/selfHardWarePCB/MotorDriver/采购元件/images/3f561f9d1827a30dc987ec84d15918e8.jpg

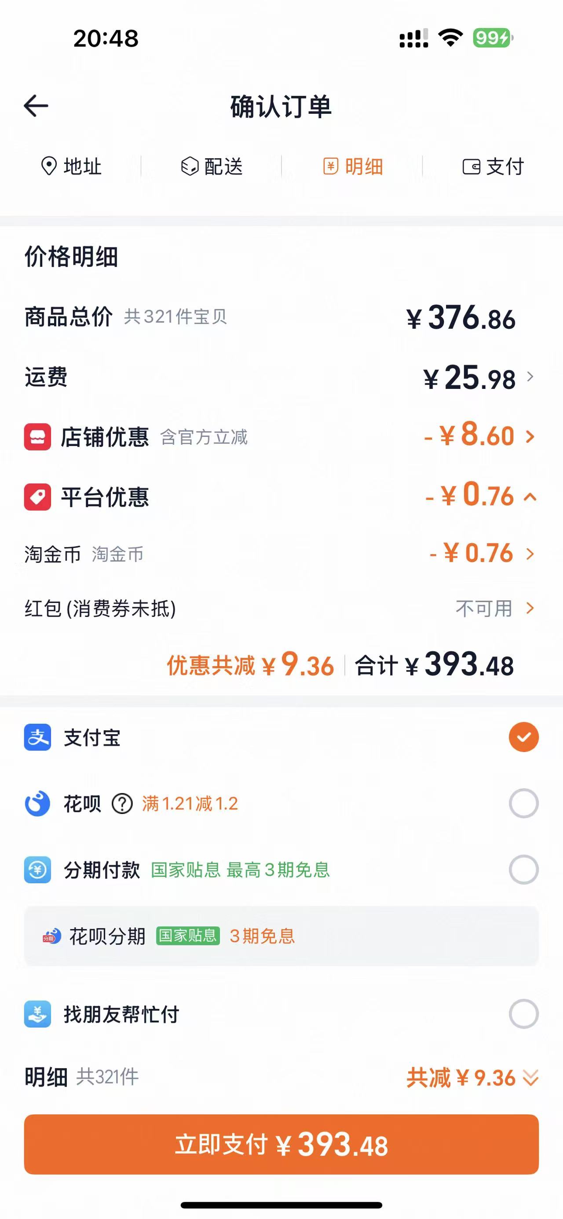
my/selfHardWarePCB/MotorDriver/采购元件/images/3f561f9d1827a30dc987ec84d15918e8.jpg
