xuzhihao-248/roboticArm/my/selfHardWarePCB/MotorDriver/采购元件/images/8d1a8ad41a7f0e51d25546f4def8d4b3.jpg

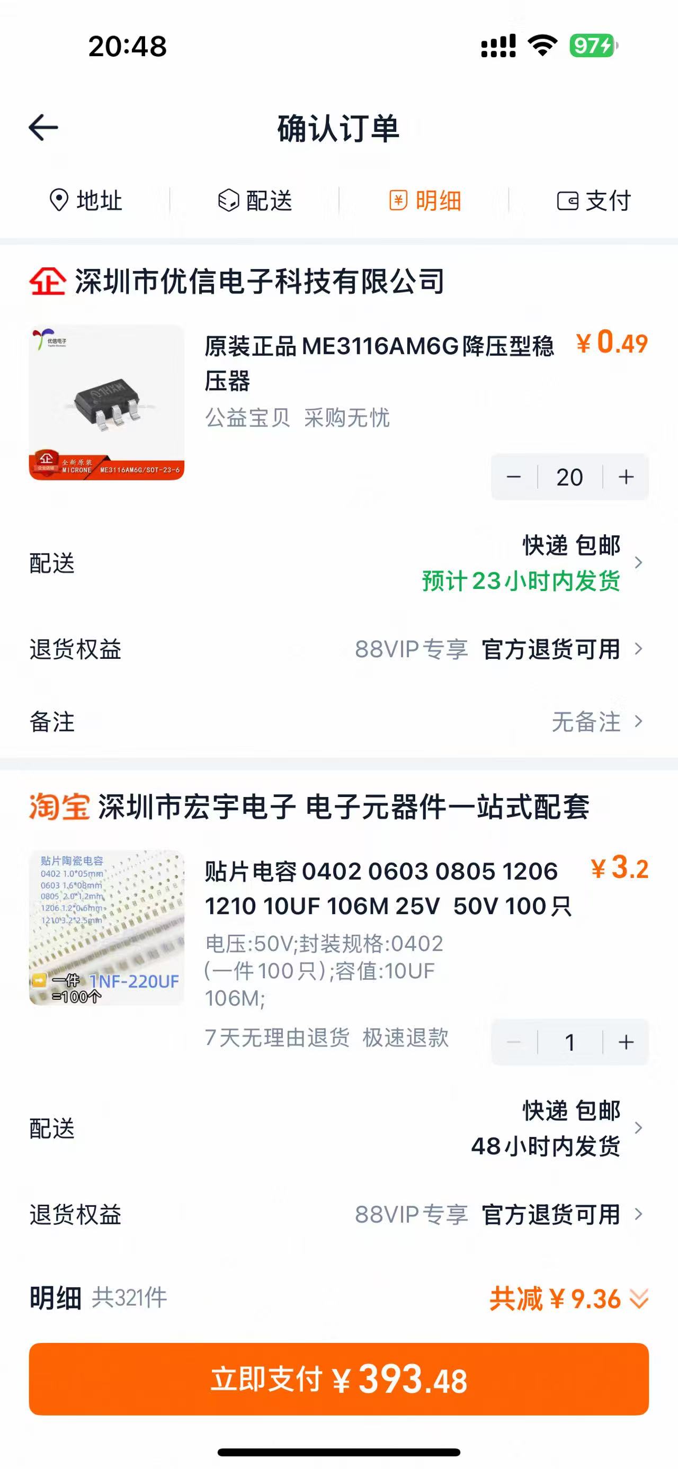
my/selfHardWarePCB/MotorDriver/采购元件/images/8d1a8ad41a7f0e51d25546f4def8d4b3.jpg
