xuzhihao-248/roboticArm/my/selfHardWarePCB/MotorDriver/采购元件/images/8d256c7feccad0e4e5ee9a4ac506525d.jpg

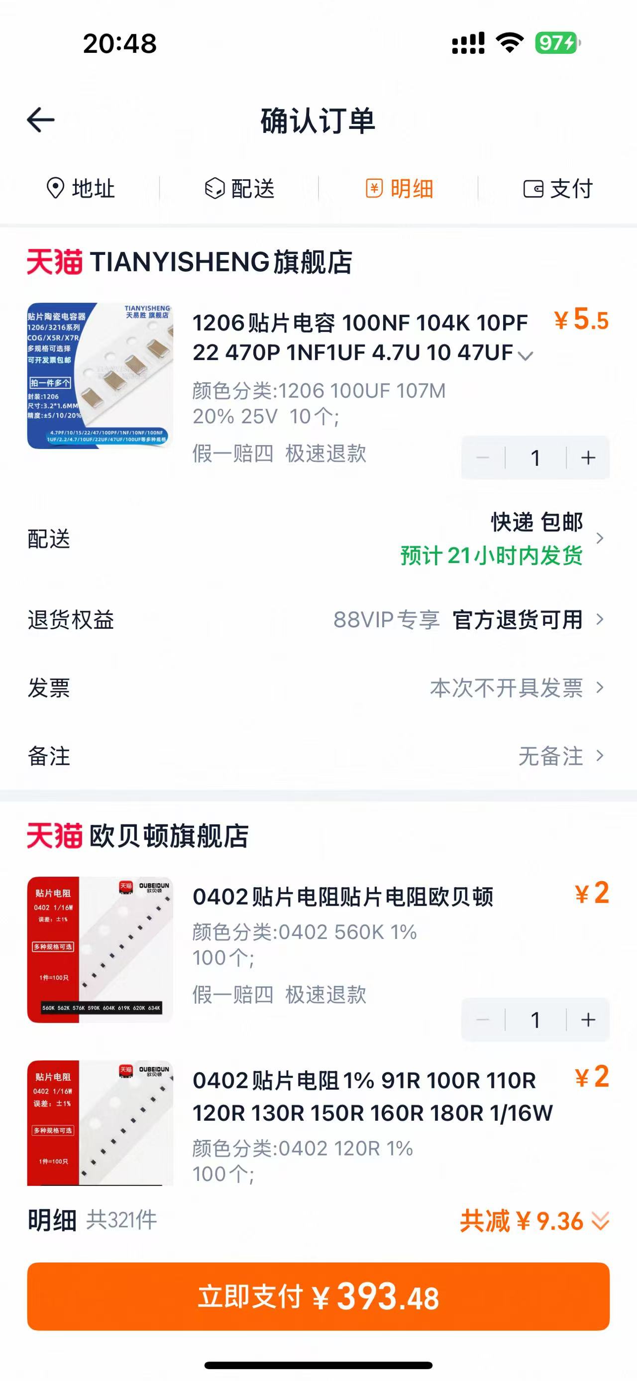
my/selfHardWarePCB/MotorDriver/采购元件/images/8d256c7feccad0e4e5ee9a4ac506525d.jpg
