xuzhihao-248/roboticArm/my/selfHardWarePCB/MotorDriver/采购元件/images/76db92886a9db46bebc26d4bf4b436ef.jpg

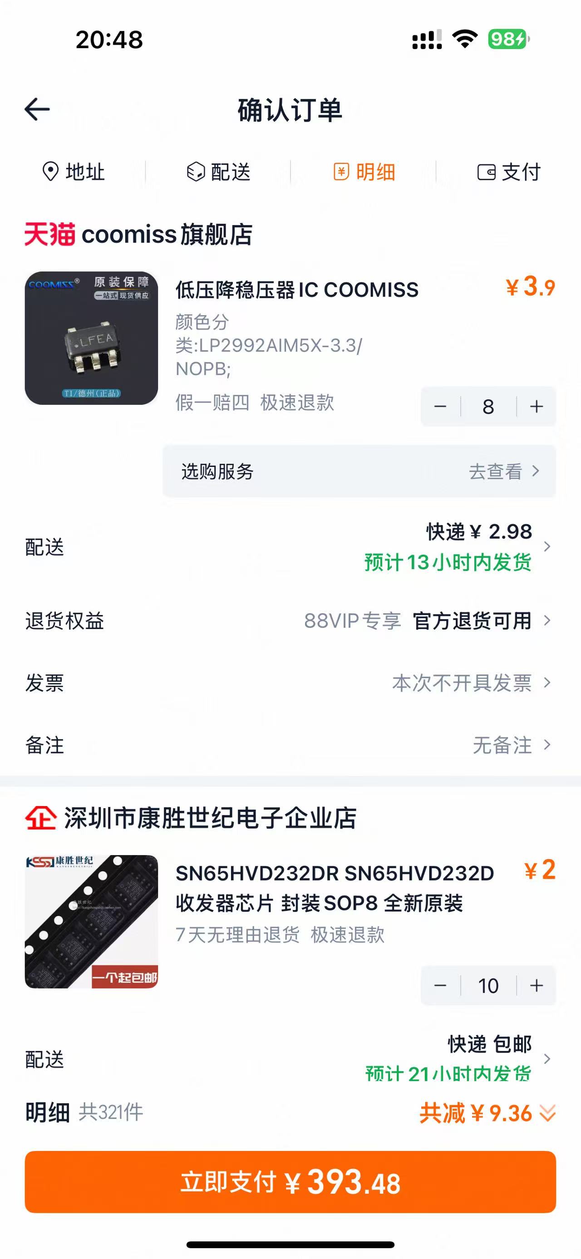
my/selfHardWarePCB/MotorDriver/采购元件/images/76db92886a9db46bebc26d4bf4b436ef.jpg
