xuzhihao-248/roboticArm/my/selfHardWarePCB/MotorDriver/采购元件/images/76ef465ced9d4cca61288412abcc4a80.jpg

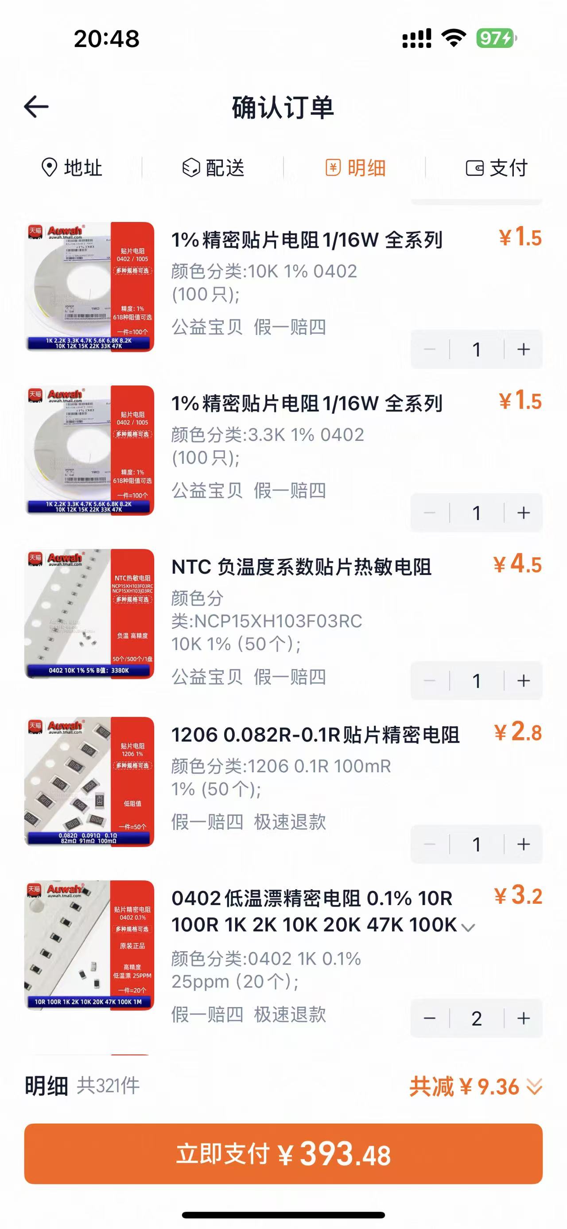
my/selfHardWarePCB/MotorDriver/采购元件/images/76ef465ced9d4cca61288412abcc4a80.jpg
