xuzhihao-248/roboticArm/my/selfHardWarePCB/MotorDriver/采购元件/images/079c01a206154898c4f46fef02a399c6.jpg

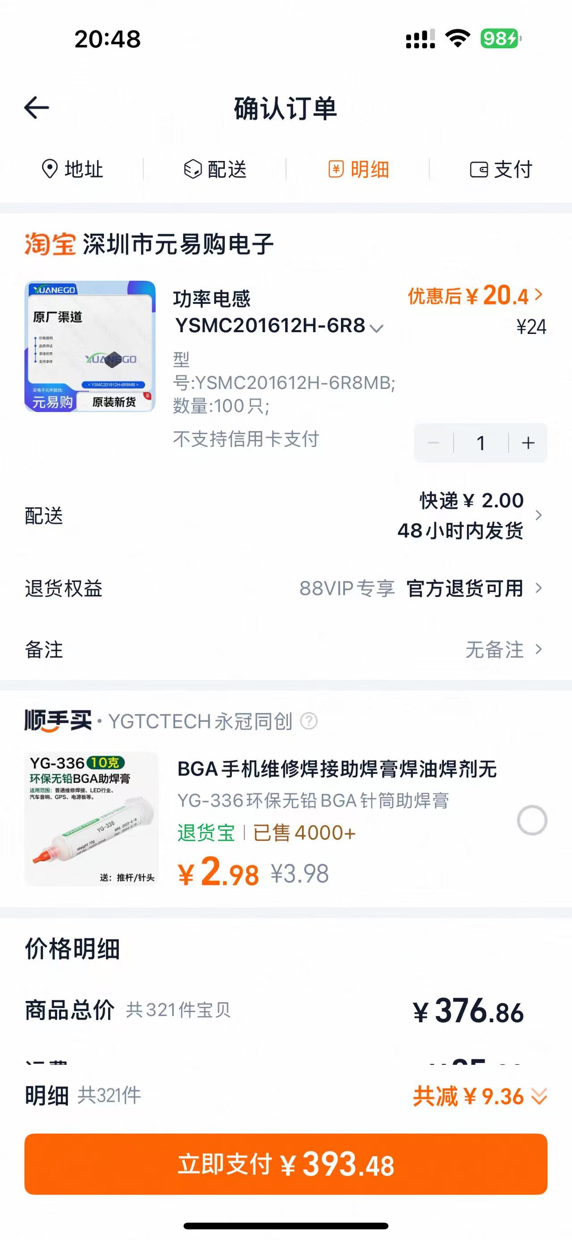
my/selfHardWarePCB/MotorDriver/采购元件/images/079c01a206154898c4f46fef02a399c6.jpg
