xuzhihao-248/roboticArm/my/selfHardWarePCB/MotorDriver/采购元件/images/0525aa453f44bfbe8b7c6caa3eb06f99.jpg

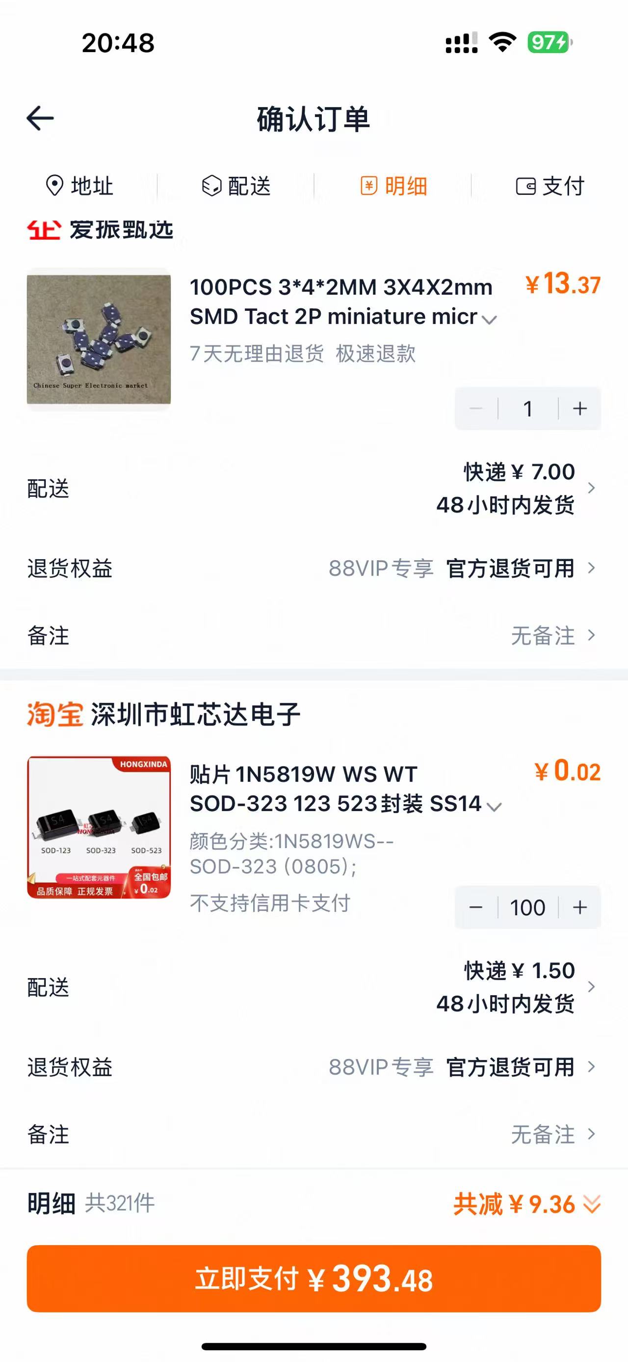
my/selfHardWarePCB/MotorDriver/采购元件/images/0525aa453f44bfbe8b7c6caa3eb06f99.jpg
