xuzhihao-248/roboticArm/my/selfHardWarePCB/MotorDriver/采购元件/images/6165c3b3a5b9543795f7ad9d304c2aec.jpg

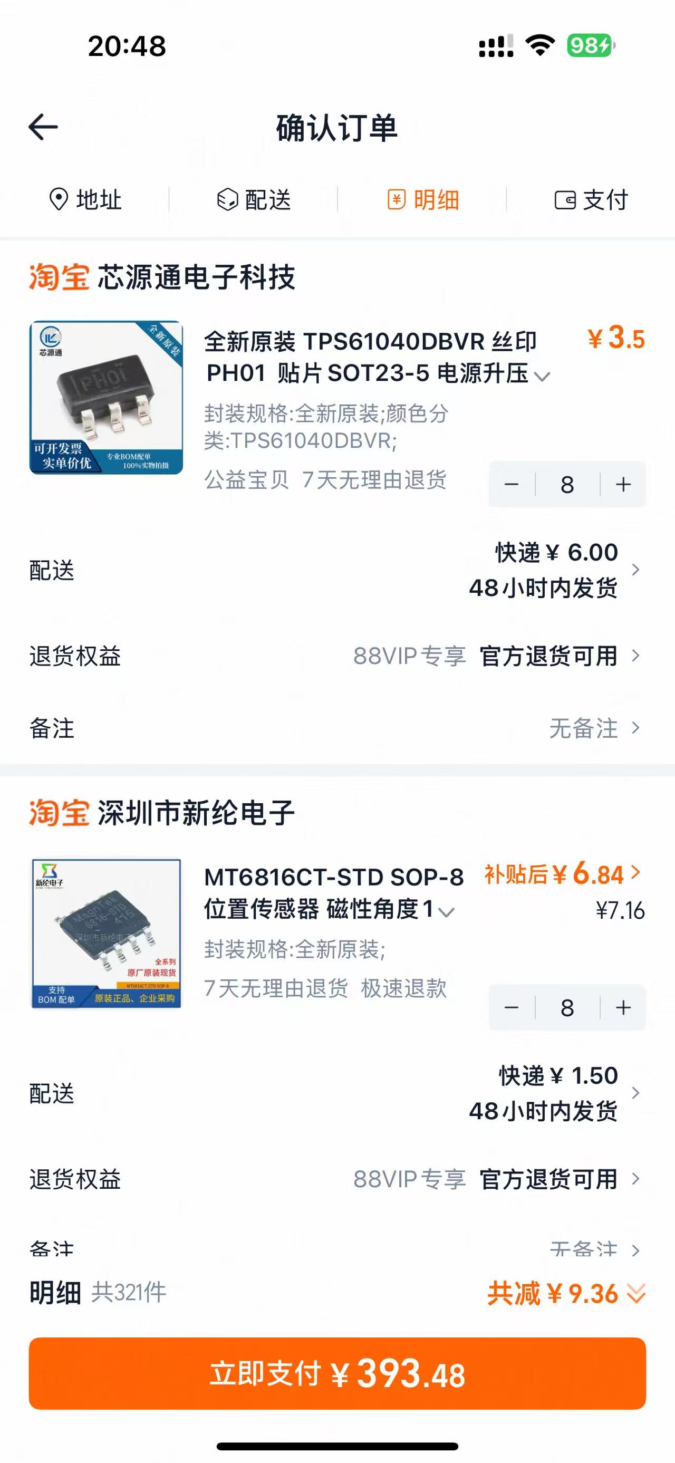
my/selfHardWarePCB/MotorDriver/采购元件/images/6165c3b3a5b9543795f7ad9d304c2aec.jpg
