xuzhihao-248/roboticArm/my/selfHardWarePCB/MotorDriver/采购元件/images/32301fbb971dfae52f536d8e7fb1a62a.jpg

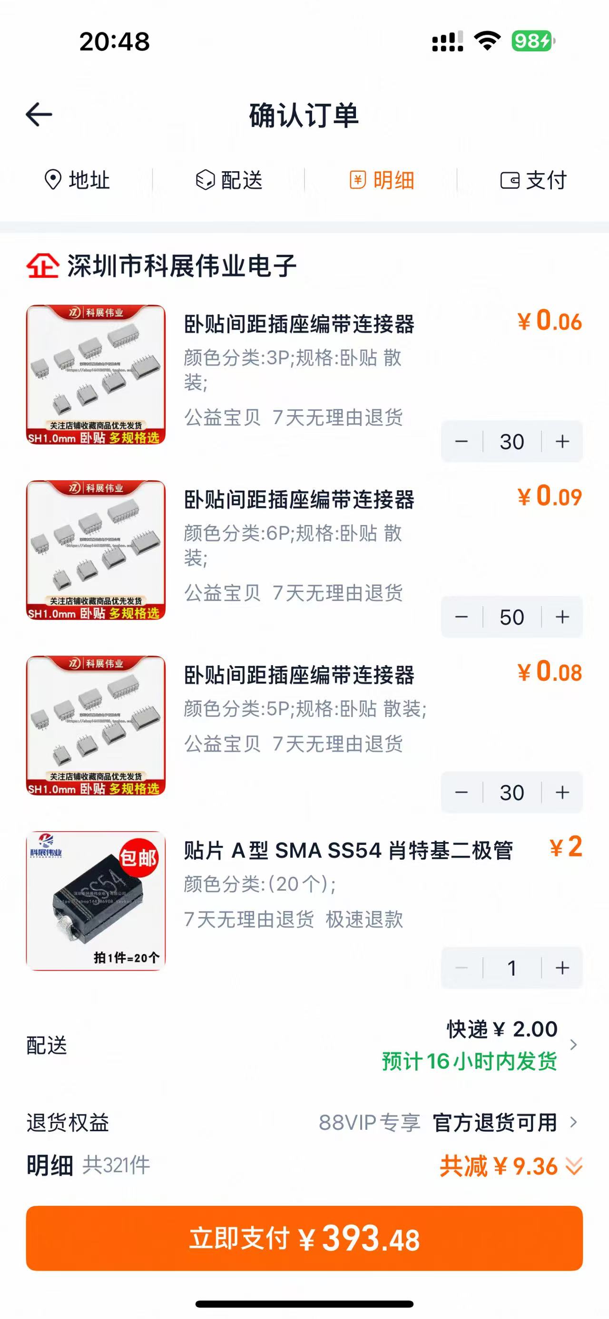
my/selfHardWarePCB/MotorDriver/采购元件/images/32301fbb971dfae52f536d8e7fb1a62a.jpg
