xuzhihao-248/roboticArm/my/selfHardWarePCB/MotorDriver/采购元件/images/95261cab66c497943f676b45d6b40c18.jpg

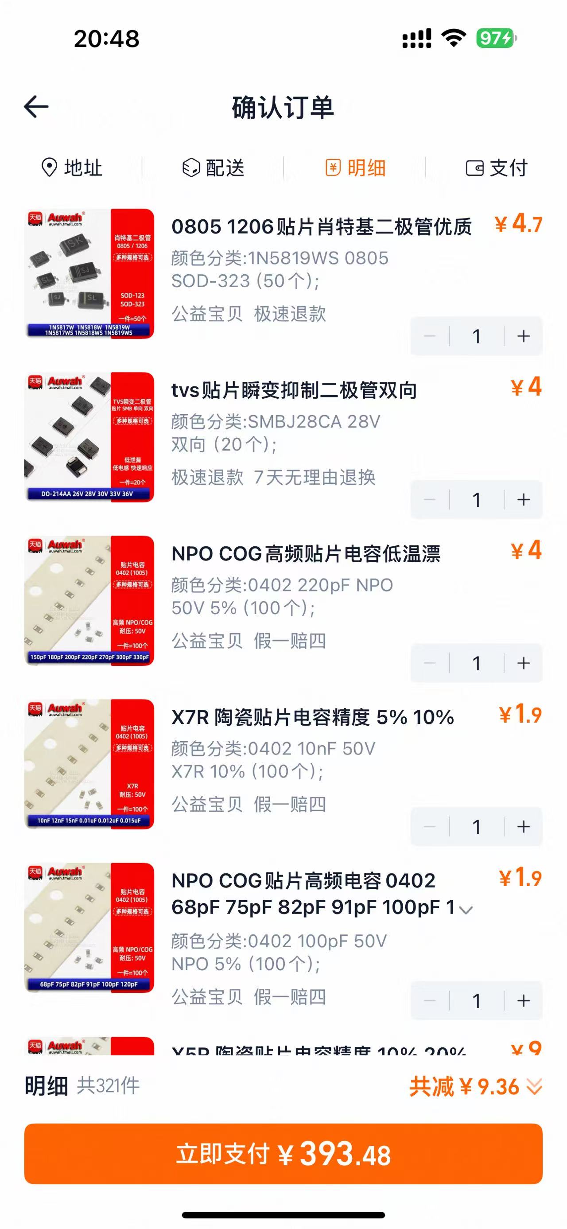
my/selfHardWarePCB/MotorDriver/采购元件/images/95261cab66c497943f676b45d6b40c18.jpg
