xuzhihao-248/roboticArm/my/selfHardWarePCB/MotorDriver/采购元件/images/a9a2914a308e9b5bd56dd6a8db968bea.jpg

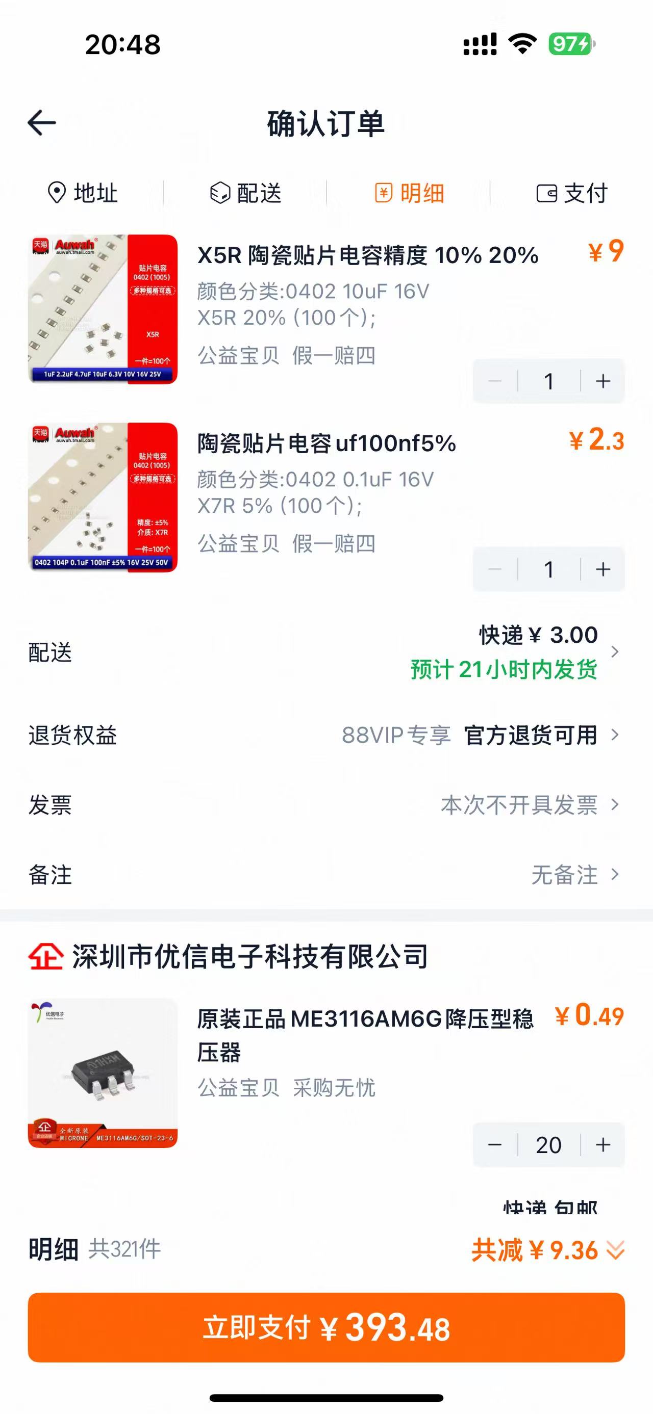
my/selfHardWarePCB/MotorDriver/采购元件/images/a9a2914a308e9b5bd56dd6a8db968bea.jpg
