xuzhihao-248/roboticArm/my/selfHardWarePCB/MotorDriver/采购元件/images/e1e6c97cdc68fb7388acdd1d7295e088.jpg

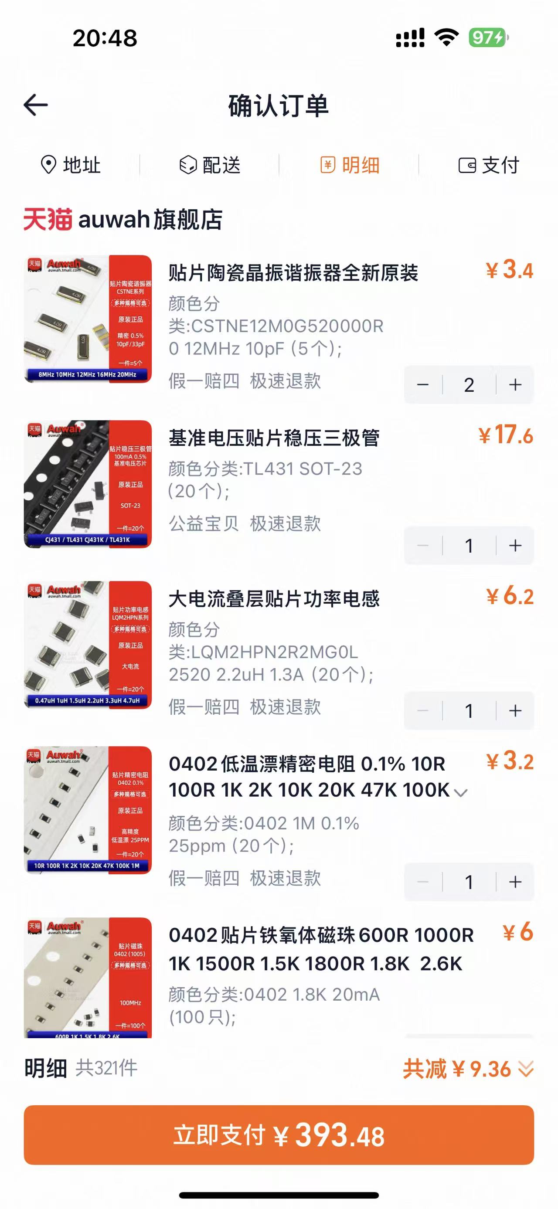
my/selfHardWarePCB/MotorDriver/采购元件/images/e1e6c97cdc68fb7388acdd1d7295e088.jpg
