xuzhihao-248/roboticArm/raw/USB转CAN/固件和源码（参考）/2-固件和源码/candleLight/官方固件及烧写/candleLight_fw.png

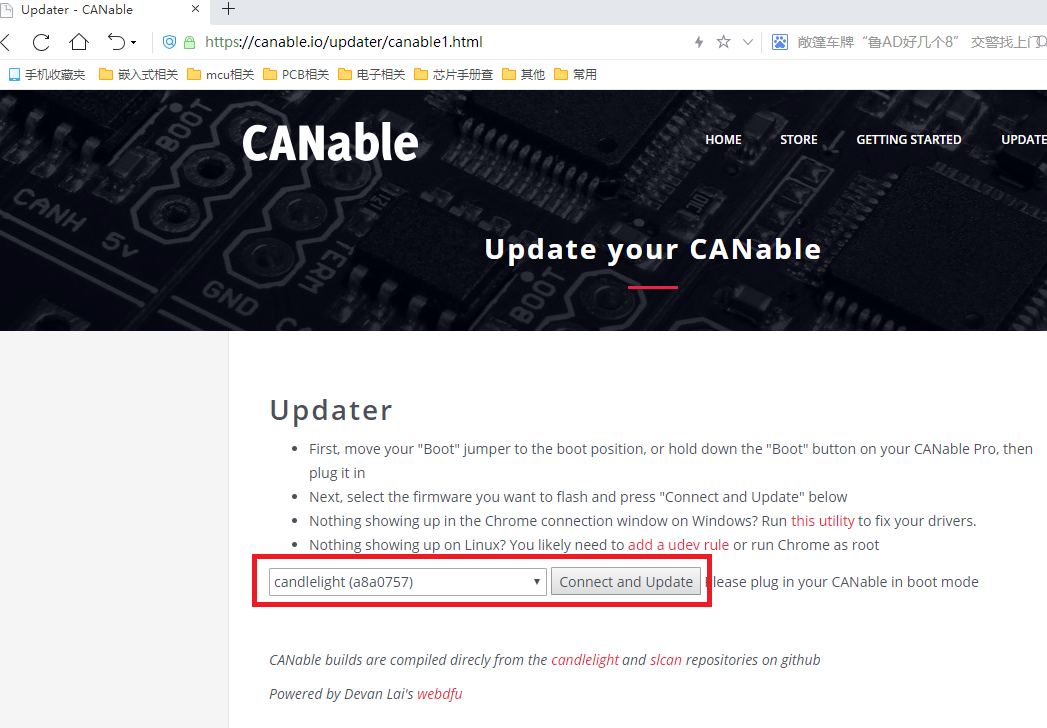
raw/USB转CAN/固件和源码（参考）/2-固件和源码/candleLight/官方固件及烧写/candleLight_fw.png
