xuzhihao-248/roboticArm/raw/dummy/AI项目解读/03-物料采购清单.md

# 物料采购清单 & 打样流程

> 一站式购物指南，按项目阶段分批采购，避免一次性买错买多

---

## 第一阶段采购：PCB 打样（先做这个，周期约1-2周）

### 需要打样的板子清单

| 序号 | 板子名称 | 文件位置 | 数量 | 推荐板厚 | 推荐颜色 | 说明 |
|---|---|---|---|---|---|---|
| 1 | MotorDriver-42 | `1.Hardware/MotorDriver-42/Gerber/` | 6块 | 1.6mm | 绿色 | **已有Gerber，直接上传下单** |
| 2 | MotorDriver-20 | `1.Hardware/MotorDriver-20/` | 1块 | 1.6mm | 绿色 | 需要自己导出Gerber |
| 3 | Controller | `1.Hardware/Controller/` | 1块 | 1.6mm | 绿色 | 核心主板，建议做SMT |
| 4 | HandModule | `1.Hardware/HandModule/` | 1块 | 1.2mm | 绿色 | 夹爪板 |
| 5 | LED Ring | `1.Hardware/LedRing/` | 1块 | 1.0mm | 绿色 | LED灯环 |
| 6 | Dangle | `1.Hardware/Dangle/` | 1块 | 1.6mm | 绿色 | 无线定位控制器（可选） |

### MotorDriver-42 Gerber 文件确认（已验证，可直接下单）

Gerber 文件位于 `1.Hardware/MotorDriver-42/Gerber/`，包含完整的 29 个文件：

| 文件层 | 文件名 | 说明 |
|---|---|---|
| 顶层铜 | Motor-42.GTL | Top Layer |
| 内层1 | Motor-42.G1 | Inner Layer 1 |
| 内层2 | Motor-42.G2 | Inner Layer 2 |
| 底层铜 | Motor-42.GBL | Bottom Layer |
| 顶层阻焊 | Motor-42.GTS | Top Solder Mask |
| 底层阻焊 | Motor-42.GBS | Bottom Solder Mask |
| 顶层丝印 | Motor-42.GTO | Top Silkscreen |
| 底层丝印 | Motor-42.GBO | Bottom Silkscreen |
| 顶层锡膏 | Motor-42.GTP | Top Paste（钢网用） |
| 底层锡膏 | Motor-42.GBP | Bottom Paste（钢网用） |
| 板框/禁止布线 | Motor-42.GKO | Keep-Out / Board Outline |
| 钻孔文件 | Motor-42.TXT | Drill Tool List |
| 钻孔报告 | Motor-42.DRR | Drill Report |
| 孔径图 | Motor-42.GD1 / .GG1 | Drill Drawing / Guide |
| 机械层 | Motor-42.GM1/10/12/13/14/15 | Mechanical Layers |
| 其他 | .APR_LIB / .apr / .EXTREP / .REP / .RUL / .LDP | 辅助文件 |

**⚙️ 打样参数确认：**

| 参数 | 推荐选择 | 说明 |
|---|---|---|
| 板层 | **4层板** | 已确认（顶层+内层1+内层2+底层） |
| 板厚 | **1.6mm** | 标准厚度 |
| 阻焊颜色 | **绿色** | 最便宜，交期最快 |
| 字符颜色 | **白色** | 绿底白字最清晰 |
| 表面处理 | **有铅喷锡 HASL** | 最便宜好焊，无铅选"无铅喷锡" |
| 铜厚 | **1oz（35μm）** | 默认 |
| 数量 | **6片** | 做5送1或直接做6片，多备一块容错 |

### JLC 嘉立创下单步骤

```
步骤1：注册 jlc.com 账号

步骤2：上传 MotorDriver-42 的 Gerber
  → 将 Gerber/ 目录下所有文件压缩成一个 .zip
  → 在嘉立创选"PCB在线下单"
  → 上传 zip，系统会自动识别为 4层板，尺寸约等待解析
  → 按上表确认参数
  → 数量选6
  → 提交订单并付款（预计 4层板 6片约 50-80元）

步骤3（其他板子需要导出 Gerber）：
  → 其他板子（Controller / MotorDriver-20 / HandModule / LED Ring / Dangle）
    需要从 .PcbDoc 导出 Gerber
  → 导出方法见下方"附录A：从 .SchDoc 导出 BOM"的同类操作
  → 如果没有 Altium Designer，去淘宝搜"Altium Designer PcbDoc转Gerber"约20-30元/文件
```

### 是否做 SMT 贴片？

- **Controller 核心板** → 建议做 SMT（只有1块，容错成本高，BGA/QFN元件多）
- **MotorDriver-42 ×6** → 做裸板自己焊（练习焊接+省钱，LQFP-48 熟练后不难）
- **其他板子** → 做裸板自己焊
- SMT 需要额外提供 **BOM 文件** 和 **CPL（坐标）文件**，导出方法见下方

---

## 附录A：从 .SchDoc / .PcbDoc 导出 BOM 和 Gerber（图文步骤）

> 你需要安装 Altium Designer（以下简称AD）。如果电脑没装、也不想装，可以跳过本节直接去淘宝找人代导出。

### A.1 安装 Altium Designer（如需自行导出）

AD 是收费软件，但可以下载试用版完成导出。搜索 "Altium Designer 下载" 即可。
版本建议：AD20 或更新。文件是本项目用 AD 创建的，新版本都能打开。

### A.2 导出 BOM（物料清单）—— 从原理图 .SchDoc

```
1. 打开 AD，File → Open → 选择 .SchDoc 文件（如 MotorDriver-42 的 Main.SchDoc）
   注意：如果原理图是多页的（MotorDriver-42 有5个 .SchDoc：
       Drive.SchDoc / Interface.SchDoc / MCU.SchDoc / Port.SchDoc / Power.SchDoc）
       需要在 AD 的项目面板中把所有 SchDoc 加入同一个工程后再导出 BOM

2. Reports → Bill of Materials

3. 在弹出的 BOM 窗口中：
   - 可以看到所有元件的列表（Designator / Comment / Footprint / Quantity 等列）
   - 检查"Comment"列是否显示了元件型号（这是你要买的东西）
   - 如果 Comment 是空的或显示不完整，说明原理图缺少元件信息，需要手动补充

4. 导出：
   - 点击左下角 "Export..."
   - 文件格式选 "CSV (*.csv)"
   - 保存到本地

5. CSV 文件可以用 Excel 打开，整理成购物清单：
   - 关键列：Designator（位号）、Comment（型号/值）、Footprint（封装）、Quantity（数量）
   - 相同 Comment 的合并计算总数量
   - 加上 10% 备损量 = 最终购买数量
```

### A.3 导出 CPL（贴片坐标文件）—— 从 PCB .PcbDoc

```
CPL（Component Placement List）告诉贴片机每个元件在板上的位置和角度。

1. 打开 AD，打开 .PcbDoc 文件

2. File → Assembly Outputs → Generates pick and place files

3. 在弹出的窗口中：
   - 格式选 "CSV"
   - 单位选 "Metric"（mm）
   - 点 OK

4. AD 会生成一个 .csv 文件，包含：
   - Designator（位号）
   - Mid X / Mid Y（元件中心坐标）
   - Layer（Top / Bottom）
   - Rotation（旋转角度）

5. 这个 CSV 文件和 BOM 一起上传给嘉立创做 SMT 贴片
```

### A.4 导出 Gerber（制造文件）—— 从 PCB .PcbDoc

```
对于没有现成 Gerber 的板子（Controller / MotorDriver-20 / HandModule 等）：

1. 打开 .PcbDoc 文件

2. File → Fabrication Outputs → Gerber Files
   - General 标签页：单位选 Millimeters，格式选 4:4
   - Layers 标签页：勾选所有使用的层（Plot Layers 全选）
   - 勾选 "Include unconnected mid-layer pads"
   - 点 OK

3. File → Fabrication Outputs → NC Drill Files
   - 单位选 Millimeters，格式选 4:4
   - 点 OK

4. 把生成的 Gerber Output 文件夹内所有文件打包成 zip
   → 这就是可以上传嘉立创的文件
```

### A.5 没有 Altium Designer 的替代方案

| 方案 | 操作 | 费用 | 时效 |
|---|---|---|---|
| 淘宝找人导出 | 搜索"Altium Designer 导出 Gerber BOM" | 20-30元/个文件 | 1-2天 |
| 闲鱼找学生/工程师 | 很多在校生有 AD，价格更低 | 10-20元/个文件 | 当天 |
| 安装 AD 试用版 | 官网下载30天试用，足够导出所有文件 | 免费 | 几小时 |

> 你需要导出的板子共5个：Controller、MotorDriver-20、HandModule、LED Ring、Dangle
> 如果淘宝代劳，全部费用约 100-150 元

---

## 第二阶段采购：电子元器件（PCB打样期间下单）

### 2.1 MotorDriver-42 主要元件（×6块）

| 元件 | 封装/型号 | 每块用量 | 总用量（含备损） | 淘宝关键词 |
|---|---|---|---|---|
| STM32F103CBT6 | LQFP-48 | 1 | 7个（备1） | "STM32F103CBT6 全新原装" |
| 电机驱动芯片 | 查看原理图确认 | 1 | 7个（备1） | 查原理图后搜索 |
| CAN收发器 | SOP-8（如TJA1050/SN65HVD230） | 1 | 7个 | "TJA1050 CAN收发器" |
| 3.3V LDO稳压器 | SOT-223（如AMS1117-3.3） | 1 | 7个 | "AMS1117-3.3 SOT-223" |
| 磁编码器芯片 | 查看原理图确认 | 1 | 7个 | 查原理图后搜索 |
| 贴片电阻 0603 | 各种阻值 | ~30 | 各200个 | "0603电阻包" |
| 贴片电容 0603/0805 | 各种容值 | ~20 | 各150个 | "0603电容包" |
| 贴片LED | 0603 | 2 | 20个 | "0603贴片LED指示灯" |
| 按键 | 侧按/顶按 SMD | 2 | 15个 | "贴片轻触开关 3×6" |
| 电解电容 | 查看原理图确认 | 2-3 | 18个 | 查看容值和耐压 |
| 排针/排母 | 2.54mm间距 | 若干 | 适量 | "2.54排针排母" |
| 接线端子 | 2p/4p 3.5mm间距 | 3-4 | 30个 | "3.5间距接线端子" |

### 2.2 Controller 核心板主要元件（×1块）

| 元件 | 封装/型号 | 用量 | 淘宝关键词 |
|---|---|---|---|
| STM32F405RGT6 | LQFP-64 | 1 | "STM32F405RGT6" |
| MPU6050/ICM-20948（IMU） | QFN | 1 | "MPU6050 模块" |
| OLED显示屏 | 0.96寸 SSD1306 I2C | 1 | "0.96寸OLED SSD1306" |
| CAN收发器 | SOP-8 | 2 | "TJA1050" |
| EEPROM | SOP-8（如AT24C02） | 1 | "AT24C02 SOP-8" |
| 蜂鸣器 | SMD 无源蜂鸣器 | 1 | "贴片无源蜂鸣器" |
| USB口 | Micro-USB 或 Type-C 母座 | 1 | 查看PCB确认 |
| 其他电阻电容 | 0603 各阻值/容值 | 各约40-50 | 买整包即可 |

> **重要提示：** 以上元件列表是根据项目常见配置推测的。你需要打开各板子的原理图（.SchDoc 文件）逐一确认 BOM。如果看不懂原理图，请找人帮忙导出 BOM 清单。

### 2.3 线材和接插件

| 物品 | 规格 | 用途 | 数量建议 |
|---|---|---|---|
| CAN总线线缆 | 双绞屏蔽线 或 4芯线（2电源+2CAN） | 关节间串联 | 20米 |
| 电源线 | 18AWG/16AWG 硅胶线 | 主电源输入 | 5米 |
| JST 连接器 | XH2.54 或 PH2.0 系列 | 板间连接 | 20套 |
| 电源母座 | DC 5.5×2.1mm 母座 | 主电源接口 | 2个 |
| 热缩管 | 各种直径 | 接线绝缘 | 1套 |

---

## 第三阶段采购：机械与总装

### 3.1 减速器

| 关节 | 推荐型号 | 数量 | 预估单价 | 备注 |
|---|---|---|---|---|
| J1 底座回转 | CSF-17-30 | 1 | 300-400元 | 扭矩需求最大 |
| J2 肩部 | CSF-17-30 | 1 | 300-400元 | 扭矩需求次大 |
| J3 肘部 | CSF-14-30 或 CSF-17-30 | 1 | 250-350元 | 看安装空间 |
| J4 腕部 | CSF-14-30 | 1 | 250-350元 | 扭矩需求较小 |
| J5 腕部 | CSF-11-30 或 CSF-14-30 | 1 | 200-300元 | 最小型号可能就够 |
| J6 腕部末端 | CSF-11-30 | 1 | 200-300元 | 最小型号 |

> **先买1个样品确认尺寸匹配，确认没问题再买齐6个！**

### 3.2 电机

| 规格 | 用途 | 数量 | 参考价格 | 说明 |
|---|---|---|---|---|
| 42步进电机（0.9°/步或1.8°/步） | J1-J6 主力电机 | 6 | 50-80元/个 | 需要双轴端（一端接编码器磁铁） |
| 20步进电机 | 夹爪驱动 | 1 | 30-50元/个 | 小规格电机 |

**选购关键词：** "42步进电机 0.9度 双轴" 或 "NEMA17 步进电机"

### 3.3 其他

| 物品 | 规格 | 数量 | 参考价格 | 用途 |
|---|---|---|---|---|
| 24V开关电源 | 24V 10A-15A | 1 | 100-150元 | 主供电 |
| ST-Link V2 | 调试下载器 | 1 | 20-35元 | 烧录固件 |
| USB-CAN调试器 | CANable 或 周立功 | 1 | 50-80元 | CAN总线调试 |
| 杜邦线 | 公母头 各规格 | 若干 | 10元 | 临时接线调试 |
| 万用表 | 优利德UT33C+ | 1 | 50-80元 | 必备工具 |
| 螺丝/螺母 | M2/M3 不锈钢内六角 | 若干 | 50元 | 机械组装 |

---

## 总预算核对

| 类别 | 项目 | 预估费用 |
|---|---|---|
| PCB 打样 | 全部板子（约14片裸板） | 150-250元 |
| PCB SMT | 仅Controller板贴片 | 80-150元 |
| 电子元器件 | 全部板子的焊接用料 | 400-700元 |
| 减速器 ×6 | 国产谐波 CSF-14/17-30 | 1500-2100元 |
| 步进电机 ×6 | 42步进 双轴 | 300-500元 |
| 电源+工具+线材 | 24V电源/ST-Link/CAN调试器等 | 350-500元 |
| CNC加工 | 铝CNC+电镀（不在本预算） | 需另外询价 |
| **合计（不含CNC）** | | **2780-4200元** ✅ 5000以内 |

---

## 采购避坑建议

1. **分阶段买，不要一次性下单全部。** 先做PCB打样→确认板子没问题→再买元件→焊好一块驱动板测试通过→再焊全部
2. **STM32芯片谨防假货/翻新货。** 在靠谱的店铺购买，价格过于便宜的要警惕。正品 STM32F103CBT6 约 15-25 元/片
3. **减速器先买1个样品。** 确认机械接口匹配后再买齐，国产谐波有些批次公差较大
4. **电阻电容多买一些。** 0603元件便宜但容易弄丢，多备10-20%不会错
5. **CNC加工前务必确认图纸。** 把STEP模型发给加工商后，让他们出加工图纸给你确认，确保公差标注清楚
