xuzhihao-248/roboticArm/my/selfHardWarePCB/MotorDriver/采购元件/核对‌清单.pdf

序 号 | Reference Qty Value DN Exclude from Board Footprint Datas Exclude 采购 数量 单价 总价 列1 列2 状态 P from BOM heet
1 | 9,C15,C17,C18,C21,C25, 120 C1,C2,C4,C5,C6,C7,C8,C 0.1uF CAP_040 100 0.023 2.3 0402 0.1uF 16V X7R 5% auwah旗舰 2 店
2 | C3,C10,C19,C22,C24,C2 8,C30 56 10uF CAP_040 100 0.05 5 040 100uF 16V X5R 220% auwah旗舰 2 店
3 | C11,C12,C13,C14 32 100uF 1206-CAP 40 0.55 22 12206 100uF 107M 20% 25V TIANYISHEN G旗舰店
4 | C16 8 100pF CAP_040 100 0.019 1.9 0402 100pF 50V NPO 5% auwah旗舰 2 店
5 | C20 8 10uF/50V CAP_040 100 0.032 3.2 10uF 106M 0402 50V 深圳市宏宇 2 电子
6 | C23 8 10nF CAP_040 100 0.019 1.9 0402 10nF 50V X7R 10% auwah旗舰 2 店
7 | C33 8 220pF CAP_040 100 0.04 4 0402 220pF NPO 50V auwah旗舰 2 店
8 | D1 8 SS54 214AC DO-20 0.1 2 深圳市科展 伟业电子
9 | D2 8 SMBJ28CA CA_MFG SMBJ-20 0.2 4 SMBJ28CA 28V 双向 auwah旗舰 店
10 | D3,D4 16 二极管-5819W SOD-323 50 0.08 4 1N5819WS 0805 SOD-323 auwah旗舰 店
11 | D6 8 5B5819WS 二极管-SOD-323 100 0.02 2 1N5819WS-SOD-323(0805) 深圳市虹芯 达电子
12 | J1 8 跳线 0402-0R 16 0 0
13 | K1,K2 16 TACT 2P CT_3x4x2 ButtonTA 100 0.134 13.4 100PCS 3*4*2MM 3X4X2mm SMD Tact 2P miniature micro switch / 爱振甄选
14 | L1 8 6.8uH 201612 IND-10 0.204 2.04 YSMC201612H-6R8M8 深圳市元易 购买电子
15 | L2 8 2.2uH 2520-L 20 0.4 8 LQM2HPN2R2MG0L 2520 2.2uH 1.3A auwah旗舰 店
16 | P1 8 SH1.0-5P SH1.0-5P 30 0.06 1.8 卧贴 深圳市科展 伟业电子
17 | P2,P3,P4 24 SH1.0-6P SH1.0-6P 30 0.07 2.1 卧贴 深圳市科展 伟业电子
18 | P5 8 SH1.0-3P SH1.0-3P 30 0.04 1.2 卧贴 深圳市科展 伟业电子
19 | R1,R2,R6,R7,R17 40 1K RES_0402 40 0.16 6.4 0402 1K 0.1% 25ppm auwah旗舰 店
20 | R3,R8 16 0.1R 1206-RES 50 0.056 2.8 1206 0.1R 100mR 1% auwah旗舰 店
21 | R4 8 NCP15XH1 03F03RC RES_0402 50 0.09 4.5 NCP15XH103F03RC 10K 1% auwah旗舰 店
22 | R5 8 3.3K RES_0402 100 0.015 1.5 3.3K 1% 0402 auwah旗舰 店
23 | R9,R10,R13,R16 32 10K RES_0402 100 0.015 1.5 10K 1% 0402 (100只) auwah旗舰 店
24 | R11,R12 16 120R RES_0402 100 0.02 2 0402 120R 1% 100个 欧贝顿旗舰 店
25 | R14 8 1.8K RES_0402 100 0.06 6 0402 1.8K 20mA auwah旗舰 店
26 | R15 8 1M RES_0402 20 0.16 3.2 0402 1M 0.1% 25ppm auwah旗舰 店
27 | R23 8 560K RES_0402 16 0.25 4 0402贴片电阻1% 560K 562K 576K 590K 欧贝顿旗舰 604K 619K 620K 634K 1/16W 店
28 | R26 8 93.1K RES_0402 100 0.02 2 0402 93.1K 1% 欧贝顿旗舰 店
29 | R27 8 13.3K RES_0402 100 0.02 2 0402 13.3K 1% 欧贝顿旗舰 店
30 | T1,T2 16 测试点 TEST_PT 50 0.088 4.4 测试点 PC板测试点 镀金陶瓷测试环 电 兴宇乐塑胶 路板测试针厚金3U TEST-1R TEST-1B 蓝 旗舰店
31 | U1,U2 16 TB67H450F SO-8-PAD 20 1.45 29 TB67H450FNG 深圳市圭鑫 NG 电子科技
32 | U3 8 STM32F10 3CBT6 LQFP-48 8 4.45 35.6 STM32F103CBT6 深圳市卓存 电子科技企
33 | U4 8 TL431IDBZ SOT23-3 20 0.88 17.6 TL431 SOT-23？？ auwah旗舰 T 店
34 | U5 8 SN65HVD2 32D SO-8 10 2 20 SN65HVD232DR SN65HVD232D 收发器 深圳市康胜 芯片 封装SOP8 全新原装 世纪电子企
35 | U6 8 ME3116 SOT23-6 20 0.49 9.8 ME3116AM6G SOT-23-6输入40V 带载 深圳市优信 可达1A的DC-DC降压型稳压器 电子科技有
36 | U7 8 LP2992 3V3 SOT23-5 8 3.9 31.2 原装 LP2992AIM5X-3.3/NOPB 贴片SOT-coomiss旗 23-5 低压降稳压器250mA 16V 舰店
37 | U8 8 MT6816 SO-8 8 3.76 30.1 MT6816CT-STD SOP-8位置传感器 磁性 深圳市新纶 角度14位高精角度编码器芯片 电子
38 | U11 8 TPS61040D BV SOT23-5 8 3.5 28 全新原装 TPS61040DBVR 丝印PH01 贴 片SOT23-5 电源升压芯片IC
39 | Y1 8 12MHz 晶振-3P 10 0.68 6.8 CSTNE12M0G520000R0 12MHz 10pF auwah旗舰 店
40 | SH1.0-2P 20 0.02 0.4
41 Motor-42 | 电路板 10 5.5 55 嘉立创
42 Motor-20 | 电路板 5 5.5 27.5 嘉立创
合计 | 412.09
