xuzhihao-248/roboticArm/my/Hardware/42_step_motor/Motor-42(bom).xlsx

Line # | Name | Description | Designator | Quantity | Manufacturer 1 | Manufacturer Part Number 1 | Manufacturer Lifecycle 1 | Supplier 1 | Supplier Part Number 1 | Supplier Unit Price 1 | Supplier Subtotal 1
 | 0.1uF | Capacitor | C1, C2, C4, C5, C6, C7, C8, C9, C15, C17, C18, C21, C25, C26 | 14
 | 10uF | Capacitor | C3, C10, C19, C22, C24 | 5
 | 100uF | Capacitor | C11, C12, C13, C14 | 4
 | 100pF | Capacitor | C16 | 1
 | 10uF/50V | Capacitor | C20 | 1
 | 10nF | Capacitor | C23 | 1
 | SS54 | Diode | D1 | 1
 | SMBJ28CA |  | D2 | 1
 | 二极管-5819W | 40V | D3, D4 | 2
 | 跳线 | Resistor | J1 | 1
 | TACT 2P | Button | K1, K2 | 2
 | 6.8uH |  | L1 | 1
 | SH1.0-5P |  | P1 | 1
 | SH1.0-6P |  | P2, P3, P4 | 3
 | SH1.0-3P | Header | P5 | 1
 | 1K | Resistor | R1, R2, R6, R7, R17 | 5
 | 0.1R | Resistor | R3, R8 | 2
 | NCP15XH103F03RC | THERMISTOR 10K OHM NTC 0402 SMD | R4 | 1
 | 3.3K | Resistor | R5 | 1
 | 10K | Resistor | R9, R10, R13, R16 | 4
 | 120R | Resistor | R11, R12 | 2
 | 1.8K | Resistor | R14 | 1
 | 1M | Resistor | R15 | 1
 | 测试点 |  | T1, T2 | 2
 | TB67H450FNG | PWM Chopper Type DC Brushed Motor Driver | U1, U2 | 2
 | STM32F103CBT6 | ARM Cortex-M3 32-bit MCU, 128 KB Flash, 20 KB Internal RAM, 37 I/Os, 48-pin LQFP, -40 to 85 degC, Tray | U3 | 1 | STMicroelectronics | STM32F103CBT6 | Volume Production | DigiKey | 497-6288-ND | 7.5 | 7.5
 | TL431IDBZT | Adjustable precision shunt regulator 3-SOT-23 -40 to 85 | U4 | 1
 | SN65HVD232D |  | U5 | 1 | Texas Instruments | SN65HVD232DR | Volume Production | DigiKey | 296-26344-1-ND | 2.45 | 2.45
 | ME3116 | DC-DC | U6 | 1
 | LP2992 3V3 | LDO | U7 | 1
 | MT6816 | Magnetic Position Sensor | U8 | 1
 | 12MHz | 村田贴片 | Y1 | 1
