xuzhihao-248/roboticArm/my/selfModel/endSystem.SLDPRT

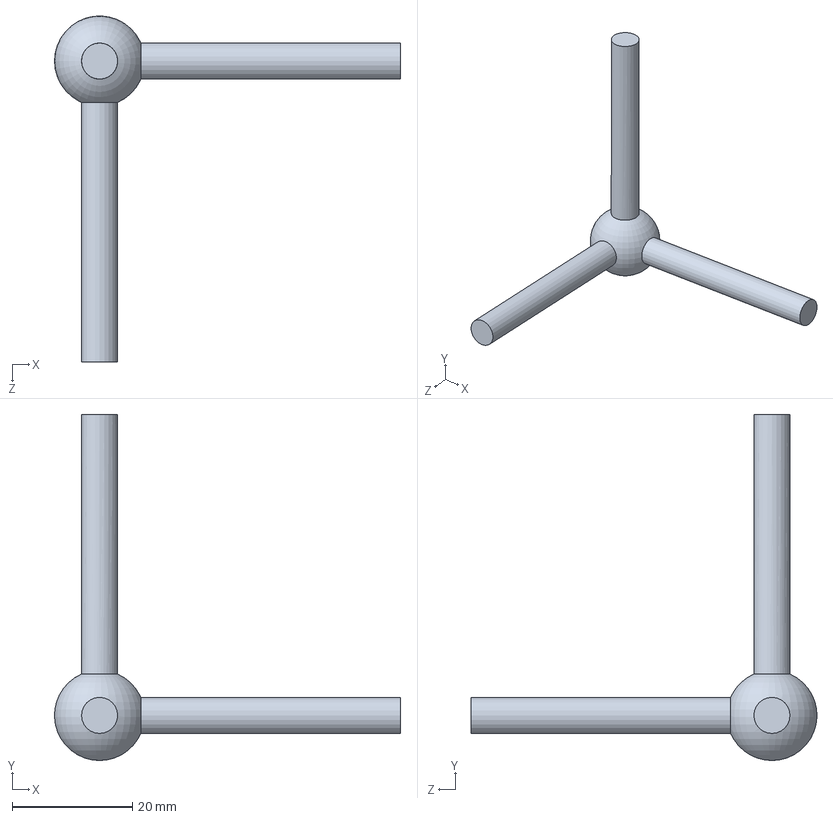
[picture p45: CAD file, 2026-06-15]
my/selfModel/endSystem.SLDPRT
57.5 x 57.5 x 57.5 mm
