xuzhihao-248/roboticArm/my/urdf/selfModel/meshes/link4.STL

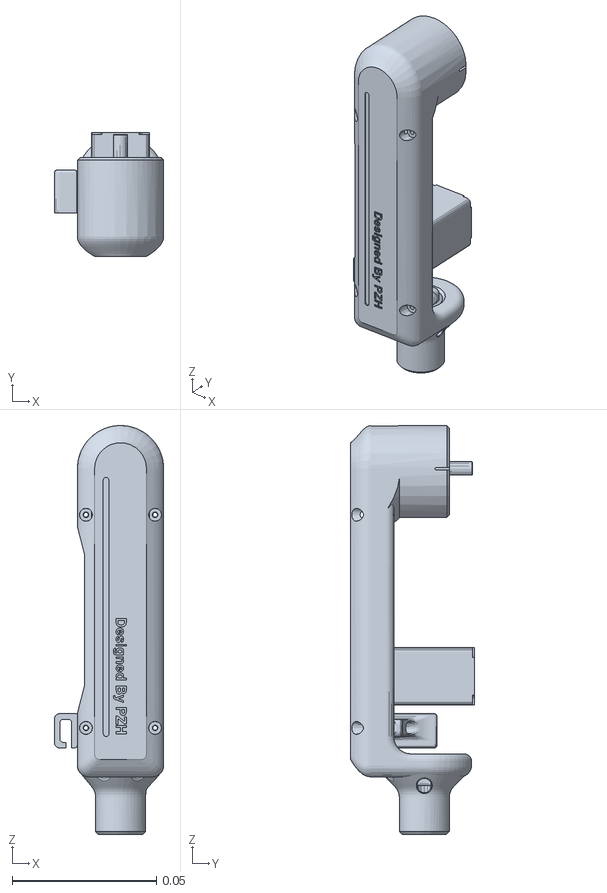
[picture p46: CAD file, 2026-06-15]
my/urdf/selfModel/meshes/link4.STL
0.038 x 0.043 x 0.142
