xuzhihao-248/roboticArm/raw/dummy/zhihui原版/Dummy-Robot-main/Model/Case v17.step

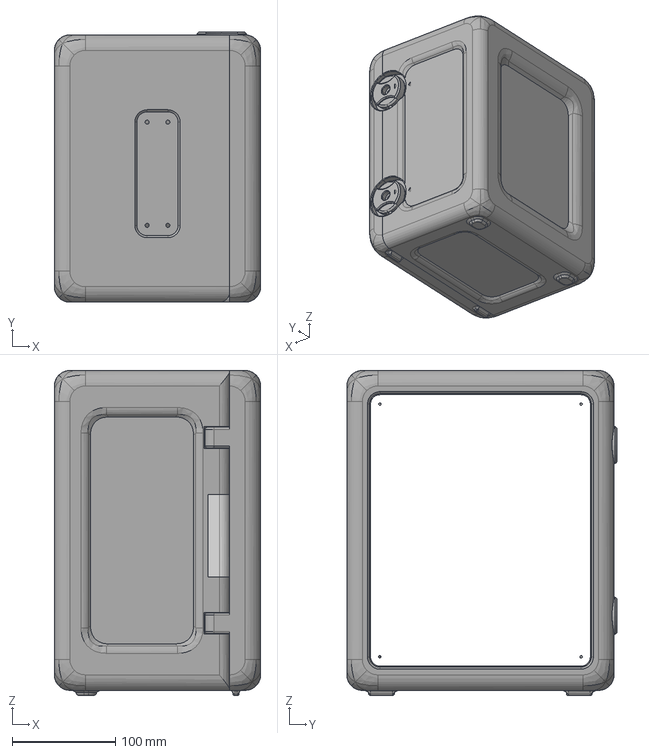
[picture p47: CAD file, 2026-05-23]
raw/dummy/zhihui原版/Dummy-Robot-main/Model/Case v17.step
200.0 x 262.0 x 315.0 mm
