xuzhihao-248/roboticArm/raw/dummy/zhihui原版/Peak-main/4.Model/侧件.step

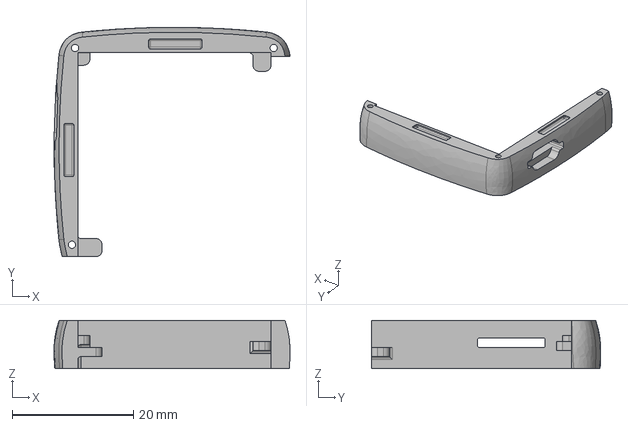
[picture p48: CAD file, 2026-05-23]
raw/dummy/zhihui原版/Peak-main/4.Model/侧件.step
38.9 x 37.8 x 8.00 mm
