xuzhihao-248/roboticArm/my/urdf/selfModel/meshes/base_link.STL

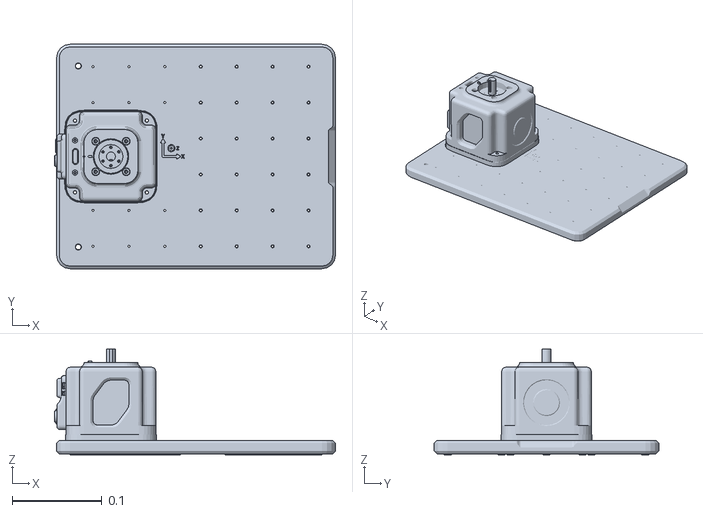
[picture p49: CAD file, 2026-06-15]
my/urdf/selfModel/meshes/base_link.STL
0.313 x 0.25 x 0.118
