xuzhihao-248/roboticArm/raw/dummy/zhihui原版/Dummy-Robot-main/Model/Motor42-上盖.step

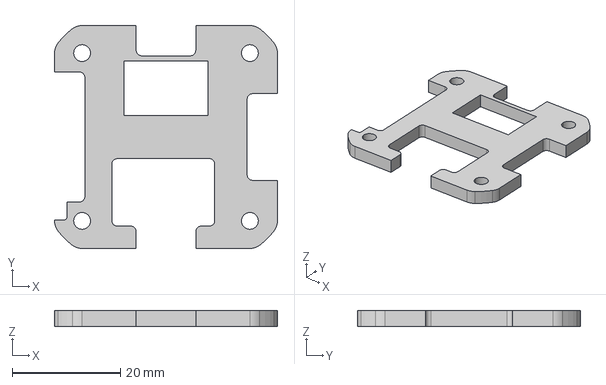
[picture p50: CAD file, 2026-05-23]
raw/dummy/zhihui原版/Dummy-Robot-main/Model/Motor42-上盖.step
41.2 x 41.2 x 3.00 mm
