xuzhihao-248/roboticArm/raw/dummy/zhihui原版/Peak-main/4.Model/主件.step

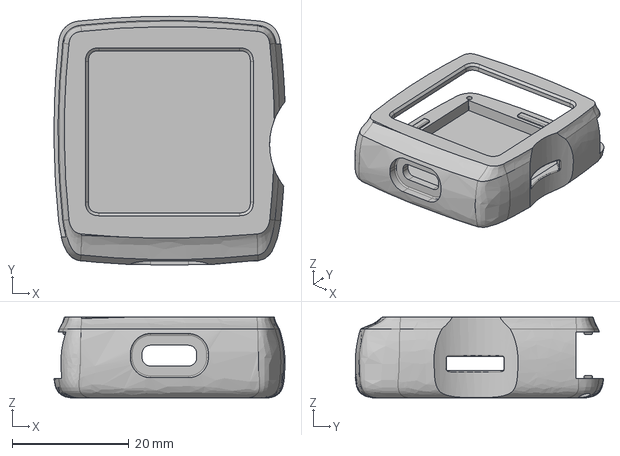
[picture p51: CAD file, 2026-05-23]
raw/dummy/zhihui原版/Peak-main/4.Model/主件.step
39.5 x 42.5 x 13.8 mm
