xuzhihao-248/roboticArm/my/urdf/selfModel/meshes/link1.STL

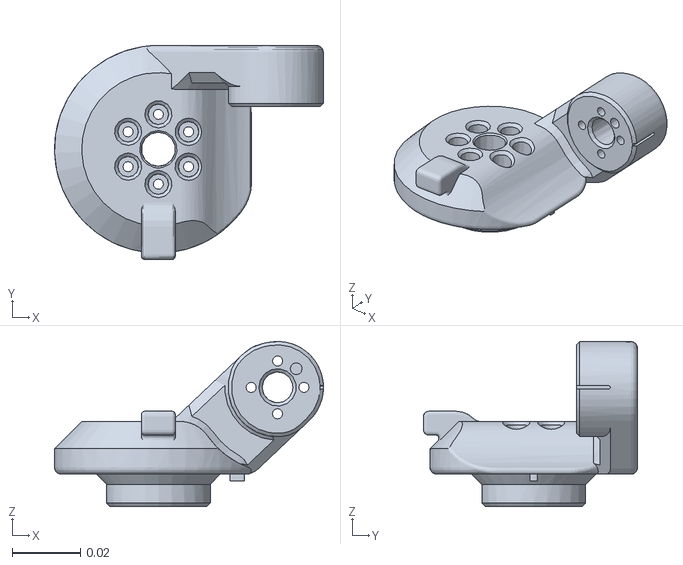
[picture p52: CAD file, 2026-06-15]
my/urdf/selfModel/meshes/link1.STL
0.079 x 0.0629 x 0.0485
