xuzhihao-248/roboticArm/my/urdf/selfModel/meshes/link3.STL

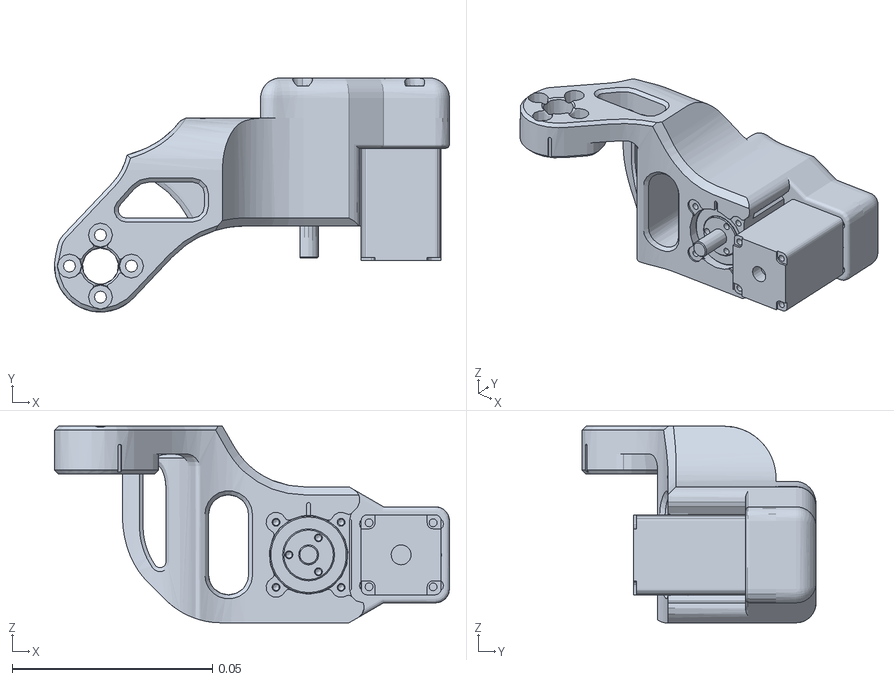
[picture p54: CAD file, 2026-06-15]
my/urdf/selfModel/meshes/link3.STL
0.0987 x 0.0585 x 0.0492
