xuzhihao-248/roboticArm/my/urdf/selfModel/meshes/link5.STL

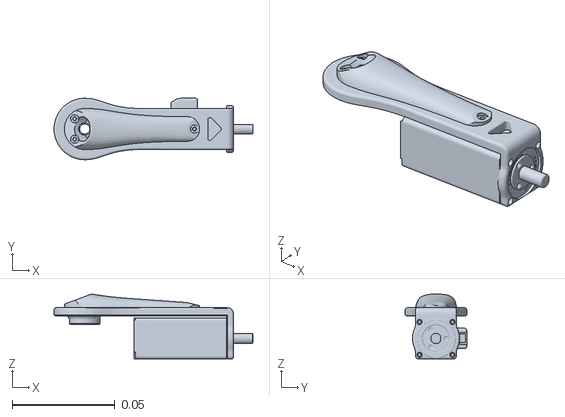
[picture p55: CAD file, 2026-06-15]
my/urdf/selfModel/meshes/link5.STL
0.097 x 0.03 x 0.0316
