xuzhihao-248/roboticArm/my/urdf/selfModel/meshes/link6.STL

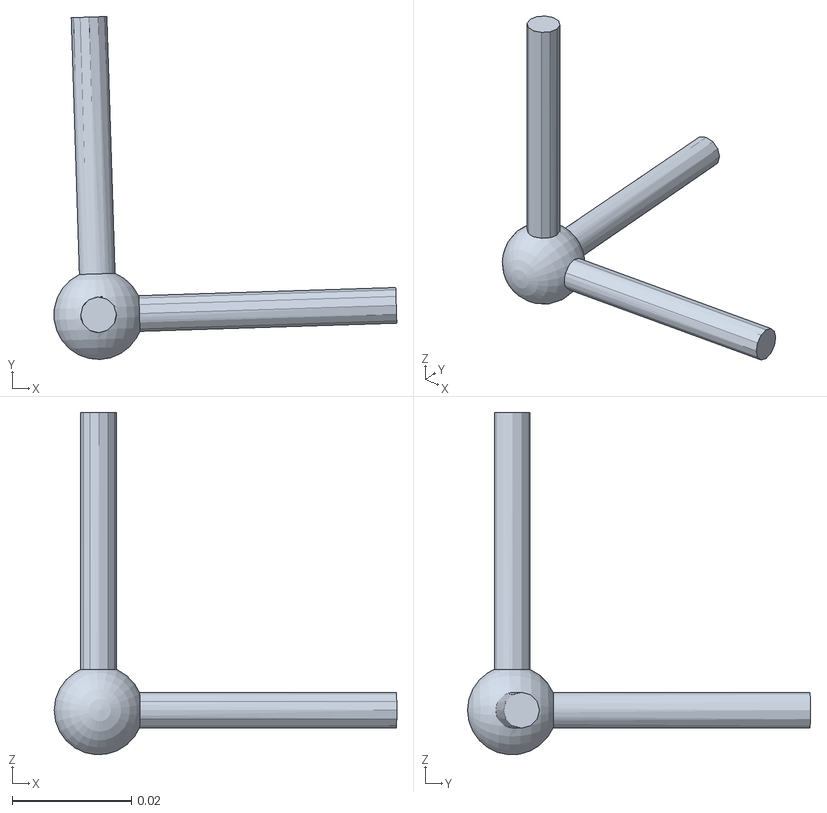
[picture p56: CAD file, 2026-06-15]
my/urdf/selfModel/meshes/link6.STL
0.0575 x 0.0576 x 0.0575
