xuzhihao-248/roboticArm/my/urdf/myModel/meshes/link6.STL

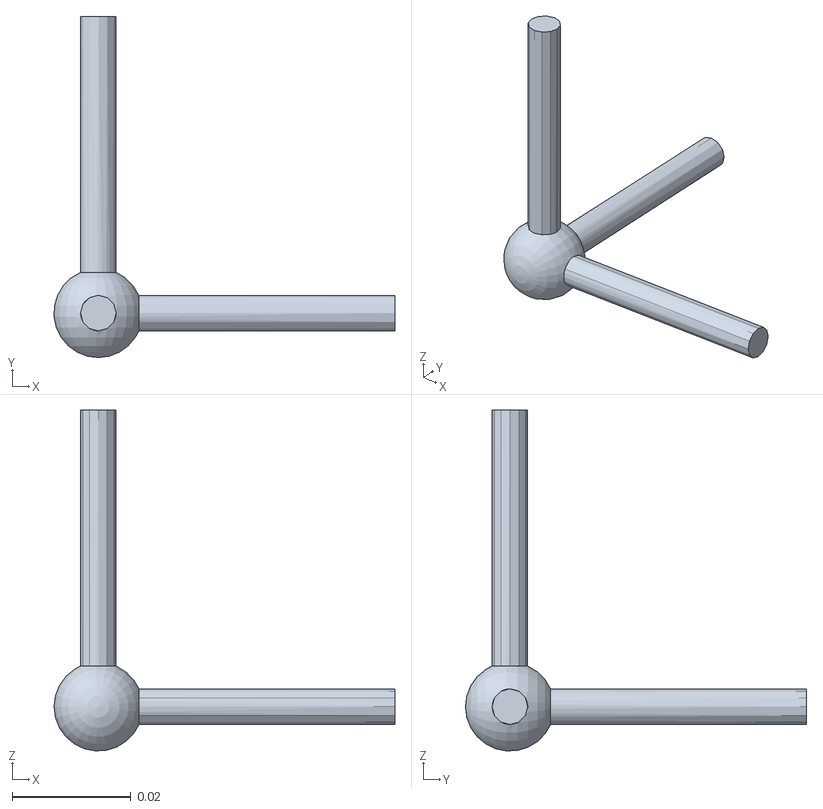
[picture p57: CAD file, 2026-06-15]
my/urdf/myModel/meshes/link6.STL
0.0575 x 0.0575 x 0.0575
