xuzhihao-248/roboticArm/my/urdf/selfModel/meshes/link2.STL

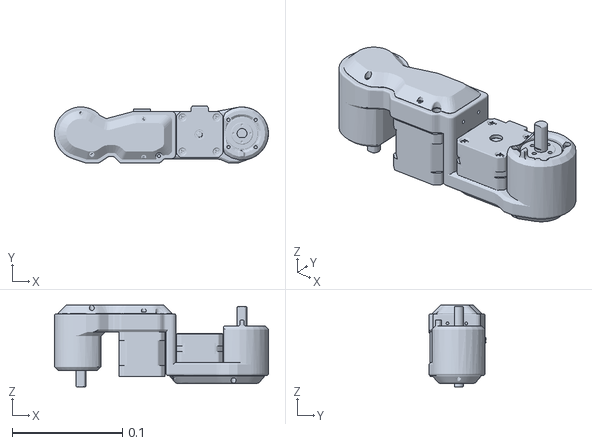
[picture p58: CAD file, 2026-06-15]
my/urdf/selfModel/meshes/link2.STL
0.194 x 0.0521 x 0.074
