xuzhihao-248/roboticArm/my/myRobot.SLDASM

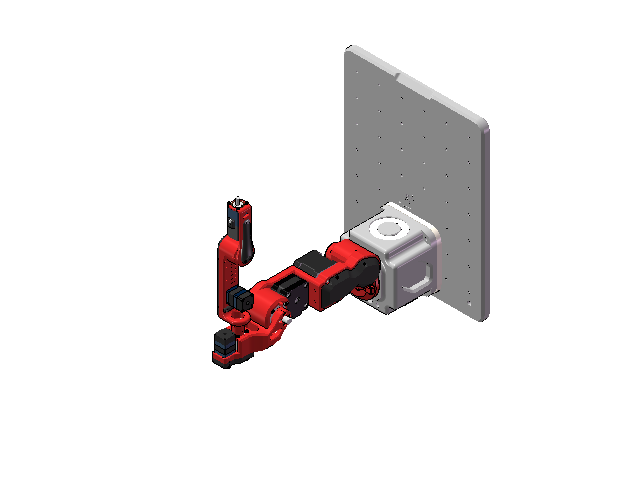
[picture p59: CAD file, 2026-06-06]
my/myRobot.SLDASM
SH03W_KORP (3) (1) (1).step
SHXX_PIN_(1) (3) (1) (1).step
SHXX_PIN_2 (3) (1) (1).step
3D打印盖.step
金属件.step
PK513PA-H50S v1.step
金属件 (6).step
零部件59.step
1375K176_MXL SERIES TIMING BELT PULLEY (2).step
1375K176_MXL SERIES TIMING BELT PULLEY (3).step
3D打印件.step
CSF-5-30-1U v2.step
PK513PA-H50S v2 (1).step x 2
1375K176_MXL SERIES TIMING BELT PULLEY.step
1375K176_MXL SERIES TIMING BELT PULLEY (1).step
3D打印件 (1).step
金属件 (2).step
CSF-5-30-1U v2 (1).step
Nema 17_Slim.step
1375K179_MXL SERIES TIMING BELT PULLEY (1).step
1375K179_MXL SERIES TIMING BELT PULLEY.step
金属件 (3).step
3D打印件 (2).step
3D打印件 (3).step
CSF-8-30-1U v2.step
Nema17 Stepper Motor v1.step
CSF-8-30-1U v2 (1).step
零部件41.step
CRK543AP-H50 v2.step
金属件 (5).step
亚克力.step
M3 x 12.step x 8
M3 x 18.step x 6
M3 x 16.step x 4
M3 x 10.step x 8
M3 x 15.step x 4
M2 x 5.step x 13
M3 x 8.step x 4
M2 x 6.step x 23
M2 x 8.step x 7
M2 x 20.step x 3
M3 x 14.step x 2
零部件69.step
零部件71.step
零部件73.step
零部件70.step
零部件75.step
零部件77.step
零部件74.step
零部件76.step
零部件72.step
垫片.step
底板-0.step
底板-1.step
底板-2.step
底板-3.step
底板-4.step
底板-5.step
底板-6.step
底板-7.step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
