xuzhihao-248/roboticArm/(list of files, cad)

Other CAD files:
my/myModel/eww (3) (1) (1).SLDASM
my/myModel/_X2_96F690E84EF6_X0_5 (3) (1) (1).SLDASM
my/myModel/Joint6.SLDASM
my/myModel/P5 (1) (1) (1) (1).SLDASM
my/myModel/复件 Joint1.SLDASM
my/myModel/P3 (3) (1) (1).SLDASM
my/myModel/2 (3) (1) (1).SLDASM
my/myModel/SHXX_PIN_(1) (3) (1) (1).SLDPRT
my/urdf/myModel/meshes/link1.STL
my/urdf/myModel/meshes/link2.STL
my/urdf/myModel/meshes/link3.STL
my/myModel/endSystem.SLDPRT
my/urdf/myModel/meshes/link5.STL
my/myModel/SHXX_PIN_2 (3) (1) (1).SLDPRT
my/urdf/myModel/meshes/base_link.STL
my/urdf/myModel/meshes/link4.STL
my/myModel/金属件.SLDPRT
my/myModel/SH03W_KORP (3) (1) (1).SLDPRT
my/myModel/PK513PA-H50S v1.SLDPRT
my/myModel/3D打印盖.SLDPRT
my/urdf/my_Robot/meshes/base_link.STL
my/urdf/my_Robot/meshes/link1.STL
my/urdf/my_Robot/meshes/link2.STL
my/urdf/my_Robot/meshes/link3.STL
my/urdf/my_Robot/meshes/link4.STL
my/urdf/my_Robot/meshes/link5.STL
my/urdf/my_robot2/meshes/base_link.STL
my/urdf/my_robot2/meshes/link1.STL
my/urdf/my_robot2/meshes/link2.STL
my/urdf/my_robot2/meshes/link3.STL
my/urdf/my_robot2/meshes/link4.STL
my/urdf/my_robot2/meshes/link5.STL
my/urdf/newrobot/meshes/base_link.STL
my/urdf/newrobot/meshes/link1.STL
my/urdf/newrobot/meshes/link2.STL
my/urdf/newrobot/meshes/link3.STL
my/urdf/newrobot/meshes/link4.STL
my/urdf/newrobot/meshes/link5.STL
