xuzhihao-248/roboticArm/doc/images/moveit_setup/c8639321e4e56a6f9d1b02ccdd918d29.png

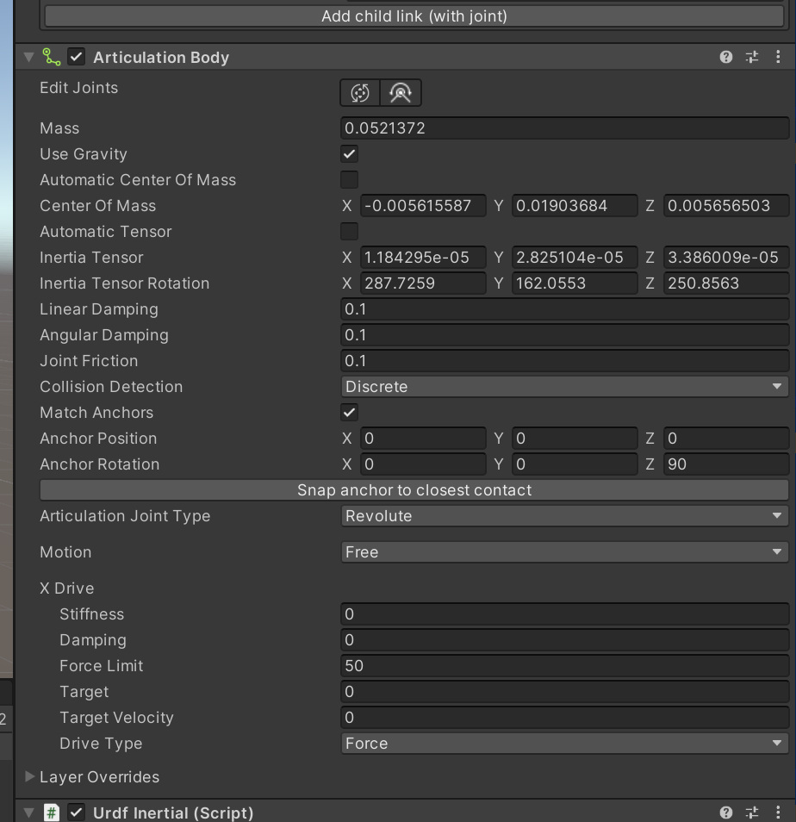
doc/images/moveit_setup/c8639321e4e56a6f9d1b02ccdd918d29.png
