xuzhihao-248/roboticArm/my/urdf/my_Robot/urdf/my_Robot.urdf

<?xml version="1.0" encoding="utf-8"?>
<!-- This URDF was automatically created by SolidWorks to URDF Exporter! Originally created by Stephen Brawner (brawner@gmail.com) 
     Commit Version: 1.6.0-4-g7f85cfe  Build Version: 1.6.7995.38578
     For more information, please see http://wiki.ros.org/sw_urdf_exporter -->
<robot name="my_Robot">
  <link name="base_link">
    <inertial>
      <origin xyz="0.064355 5.0607E-05 0.0033088" rpy="0 0 0" />
      <mass value="1.6946" />
      <inertia ixx="0.0064783" ixy="-4.1906E-07" ixz="-1.5099E-05" iyy="0.0091096" iyz="-4.5666E-07" izz="0.015037" />
    </inertial>
    <visual>
      <origin xyz="0 0 0" rpy="0 0 0" />
      <geometry>
        <mesh filename="package://my_Robot/meshes/base_link.STL" />
      </geometry>
      <material name="">
        <color rgba="0.75294 0.75294 0.75294 1" />
      </material>
    </visual>
    <collision>
      <origin xyz="0 0 0" rpy="0 0 0" />
      <geometry>
        <mesh filename="package://my_Robot/meshes/base_link.STL" />
      </geometry>
    </collision>
  </link>
  <link name="link1">
    <inertial>
      <origin xyz="0.0056565 0.0056156 0.019037" rpy="0 0 0" />
      <mass value="0.052137" />
      <inertia ixx="1.9368E-05" ixy="-7.1474E-06" ixz="-5.1109E-06" iyy="2.2604E-05" iyz="-3.282E-06" izz="3.1983E-05" />
    </inertial>
    <visual>
      <origin xyz="0 0 0" rpy="0 0 0" />
      <geometry>
        <mesh filename="package://my_Robot/meshes/link1.STL" />
      </geometry>
      <material name="">
        <color rgba="0.75294 0.75294 0.75294 1" />
      </material>
    </visual>
    <collision>
      <origin xyz="0 0 0" rpy="0 0 0" />
      <geometry>
        <mesh filename="package://my_Robot/meshes/link1.STL" />
      </geometry>
    </collision>
  </link>
  <joint name="joint1" type="continuous">
    <origin xyz="0 0 0.0735" rpy="0 0 0" />
    <parent link="base_link" />
    <child link="link1" />
    <axis xyz="0 0 -1" />
    <limit effort="50" velocity="3.14" />
    <dynamics damping="0.1" friction="0.1" />
  </joint>
  <link name="link2">
    <inertial>
      <origin xyz="0.0020617 0.071107 -0.015723" rpy="0 0 0" />
      <mass value="0.31887" />
      <inertia ixx="0.00053452" ixy="1.2153E-06" ixz="-1.4253E-06" iyy="0.00010406" iyz="3.8331E-05" izz="0.00053492" />
    </inertial>
    <visual>
      <origin xyz="0 0 0" rpy="0 0 0" />
      <geometry>
        <mesh filename="package://my_Robot/meshes/link2.STL" />
      </geometry>
      <material name="">
        <color rgba="0.75294 0.75294 0.75294 1" />
      </material>
    </visual>
    <collision>
      <origin xyz="0 0 0" rpy="0 0 0" />
      <geometry>
        <mesh filename="package://my_Robot/meshes/link2.STL" />
      </geometry>
    </collision>
  </link>
  <joint name="joint2" type="revolute">
    <origin xyz="0.035 -0.02 0.0355" rpy="1.5708 0 0" />
    <parent link="link1" />
    <child link="link2" />
    <axis xyz="0 0 -1" />
    <limit lower="-1.04" upper="1.04" effort="50" velocity="3.14" />
    <dynamics damping="0.1" friction="0.1" />
  </joint>
  <link name="link3">
    <inertial>
      <origin xyz="0.044755 0.022755 -0.015346" rpy="0 0 0" />
      <mass value="0.065199" />
      <inertia ixx="1.4837E-05" ixy="-3.4323E-06" ixz="5.2064E-06" iyy="2.5913E-05" iyz="2.0349E-06" izz="2.0069E-05" />
    </inertial>
    <visual>
      <origin xyz="0 0 0" rpy="0 0 0" />
      <geometry>
        <mesh filename="package://my_Robot/meshes/link3.STL" />
      </geometry>
      <material name="">
        <color rgba="0.75294 0.75294 0.75294 1" />
      </material>
    </visual>
    <collision>
      <origin xyz="0 0 0" rpy="0 0 0" />
      <geometry>
        <mesh filename="package://my_Robot/meshes/link3.STL" />
      </geometry>
    </collision>
  </link>
  <joint name="joint3" type="revolute">
    <origin xyz="0 0.146 0.00015" rpy="0 0 1.5708" />
    <parent link="link2" />
    <child link="link3" />
    <axis xyz="0 0 -1" />
    <limit lower="-1.04" upper="1.04" effort="50" velocity="3.14" />
    <dynamics damping="0.1" friction="0.1" />
  </joint>
  <link name="link4">
    <inertial>
      <origin xyz="0.00023092 -0.0082886 0.07401" rpy="0 0 0" />
      <mass value="0.063288" />
      <inertia ixx="4.172E-05" ixy="3.35E-08" ixz="2.908E-07" iyy="4.3299E-05" iyz="-2.15E-06" izz="6.1941E-06" />
    </inertial>
    <visual>
      <origin xyz="0 0 0" rpy="0 0 0" />
      <geometry>
        <mesh filename="package://my_Robot/meshes/link4.STL" />
      </geometry>
      <material name="">
        <color rgba="0.75294 0.75294 0.75294 1" />
      </material>
    </visual>
    <collision>
      <origin xyz="0 0 0" rpy="0 0 0" />
      <geometry>
        <mesh filename="package://my_Robot/meshes/link4.STL" />
      </geometry>
    </collision>
  </link>
  <joint name="joint4" type="continuous">
    <origin xyz="0.052 0.012 -0.02015" rpy="1.5708 0 0" />
    <parent link="link3" />
    <child link="link4" />
    <axis xyz="0 0 -1" />
    <limit effort="50" velocity="3.14" />
    <dynamics damping="0.1" friction="0.1" />
  </joint>
  <link name="link5">
    <inertial>
      <origin xyz="0.039975 2.0202E-05 -0.0022875" rpy="0 0 0" />
      <mass value="0.028003" />
      <inertia ixx="1.6849E-06" ixy="1.5201E-09" ixz="1.4814E-07" iyy="6.9077E-06" iyz="-2.4077E-10" izz="7.2285E-06" />
    </inertial>
    <visual>
      <origin xyz="0 0 0" rpy="0 0 0" />
      <geometry>
        <mesh filename="package://my_Robot/meshes/link5.STL" />
      </geometry>
      <material name="">
        <color rgba="0.75294 0.75294 0.75294 1" />
      </material>
    </visual>
    <collision>
      <origin xyz="0 0 0" rpy="0 0 0" />
      <geometry>
        <mesh filename="package://my_Robot/meshes/link5.STL" />
      </geometry>
    </collision>
  </link>
  <joint name="joint5" type="revolute">
    <origin xyz="0 0.0068 0.127" rpy="1.5708 -1.5708 0" />
    <parent link="link4" />
    <child link="link5" />
    <axis xyz="0 0 1" />
    <limit lower="-2.09" upper="2.09" effort="50" velocity="3.14" />
    <dynamics damping="0.1" friction="0.1" />
  </joint>
</robot>
