xuzhihao-248/roboticArm/my/urdf/selfModel/urdf/selfModel.urdf

<?xml version="1.0" encoding="utf-8"?>
<!-- This URDF was automatically created by SolidWorks to URDF Exporter! Originally created by Stephen Brawner (brawner@gmail.com) 
     Commit Version: 1.6.0-4-g7f85cfe  Build Version: 1.6.7995.38578
     For more information, please see http://wiki.ros.org/sw_urdf_exporter -->
<robot name="selfModel">
  <link name="base_link">
    <inertial>
      <origin xyz="0.064355 5.0607E-05 0.0033088" rpy="0 0 0" />
      <mass value="1.6946" />
      <inertia ixx="0.0064783" ixy="-4.1906E-07" ixz="-1.5099E-05" iyy="0.0091096" iyz="-4.5666E-07" izz="0.015037" />
    </inertial>
    <visual>
      <origin xyz="0 0 0" rpy="0 0 0" />
      <geometry>
        <mesh filename="package://selfModel/meshes/base_link.STL" />
      </geometry>
      <material name="">
        <color rgba="0.75294 0.75294 0.75294 1" />
      </material>
    </visual>
    <collision>
      <origin xyz="0 0 0" rpy="0 0 0" />
      <geometry>
        <mesh filename="package://selfModel/meshes/base_link.STL" />
      </geometry>
    </collision>
  </link>
  <link name="link1">
    <inertial>
      <origin xyz="0.0056565 0.0056156 0.018537" rpy="0 0 0" />
      <mass value="0.052137" />
      <inertia ixx="1.9368E-05" ixy="-7.1474E-06" ixz="-5.1109E-06" iyy="2.2604E-05" iyz="-3.282E-06" izz="3.1983E-05" />
    </inertial>
    <visual>
      <origin xyz="0 0 0" rpy="0 0 0" />
      <geometry>
        <mesh filename="package://selfModel/meshes/link1.STL" />
      </geometry>
      <material name="">
        <color rgba="0.81176 0.1451 0.1451 1" />
      </material>
    </visual>
    <collision>
      <origin xyz="0 0 0" rpy="0 0 0" />
      <geometry>
        <mesh filename="package://selfModel/meshes/link1.STL" />
      </geometry>
    </collision>
  </link>
  <joint name="joint1" type="continuous">
    <origin xyz="0 0 0.074" rpy="0 0 0" />
    <parent link="base_link" />
    <child link="link1" />
    <axis xyz="0 0 -1" />
    <limit effort="20" velocity="0.377" />
    <dynamics damping="0.1" friction="0.1" />
  </joint>
  <link name="link2">
    <inertial>
      <origin xyz="0.071107 -0.0020617 -0.015723" rpy="0 0 0" />
      <mass value="0.31887" />
      <inertia ixx="0.00010406" ixy="-1.2153E-06" ixz="3.8331E-05" iyy="0.00053452" iyz="1.4253E-06" izz="0.00053492" />
    </inertial>
    <visual>
      <origin xyz="0 0 0" rpy="0 0 0" />
      <geometry>
        <mesh filename="package://selfModel/meshes/link2.STL" />
      </geometry>
      <material name="">
        <color rgba="0.75294 0.75294 0.75294 1" />
      </material>
    </visual>
    <collision>
      <origin xyz="0 0 0" rpy="0 0 0" />
      <geometry>
        <mesh filename="package://selfModel/meshes/link2.STL" />
      </geometry>
    </collision>
  </link>
  <joint name="joint2" type="revolute">
    <origin xyz="0.035 -0.02 0.035" rpy="1.5708 -1.5708 0" />
    <parent link="link1" />
    <child link="link2" />
    <axis xyz="0 0 1" />
    <limit lower="-1.274" upper="1.274" effort="20" velocity="0.377" />
    <dynamics damping="0.1" friction="0.1" />
  </joint>
  <link name="link3">
    <inertial>
      <origin xyz="0.044755 0.022755 -0.015346" rpy="0 0 0" />
      <mass value="0.065199" />
      <inertia ixx="1.4837E-05" ixy="-3.4323E-06" ixz="5.2064E-06" iyy="2.5913E-05" iyz="2.0349E-06" izz="2.0069E-05" />
    </inertial>
    <visual>
      <origin xyz="0 0 0" rpy="0 0 0" />
      <geometry>
        <mesh filename="package://selfModel/meshes/link3.STL" />
      </geometry>
      <material name="">
        <color rgba="0.75294 0.75294 0.75294 1" />
      </material>
    </visual>
    <collision>
      <origin xyz="0 0 0" rpy="0 0 0" />
      <geometry>
        <mesh filename="package://selfModel/meshes/link3.STL" />
      </geometry>
    </collision>
  </link>
  <joint name="joint3" type="revolute">
    <origin xyz="0.146 0 0.00015" rpy="0 0 0" />
    <parent link="link2" />
    <child link="link3" />
    <axis xyz="0 0 -1" />
    <limit lower="-1.047" upper="1.047" effort="12" velocity="0.628" />
    <dynamics damping="0.1" friction="0.1" />
  </joint>
  <link name="link4">
    <inertial>
      <origin xyz="-5.0854E-05 -0.0082224 0.073171" rpy="0 0 0" />
      <mass value="0.064741" />
      <inertia ixx="4.1762E-05" ixy="6.8663E-08" ixz="2.8681E-07" iyy="4.3462E-05" iyz="-2.1488E-06" izz="6.3712E-06" />
    </inertial>
    <visual>
      <origin xyz="0 0 0" rpy="0 0 0" />
      <geometry>
        <mesh filename="package://selfModel/meshes/link4.STL" />
      </geometry>
      <material name="">
        <color rgba="0.75294 0.75294 0.75294 1" />
      </material>
    </visual>
    <collision>
      <origin xyz="0 0 0" rpy="0 0 0" />
      <geometry>
        <mesh filename="package://selfModel/meshes/link4.STL" />
      </geometry>
    </collision>
  </link>
  <joint name="joint4" type="continuous">
    <origin xyz="0.052 0.012 -0.02015" rpy="1.5708 0 0" />
    <parent link="link3" />
    <child link="link4" />
    <axis xyz="0 0 -1" />
    <limit effort="12" velocity="0.628" />
    <dynamics damping="0.1" friction="0.1" />
  </joint>
  <link name="link5">
    <inertial>
      <origin xyz="0.040089 0.00018784 -0.0023494" rpy="0 0 0" />
      <mass value="0.028392" />
      <inertia ixx="1.6899E-06" ixy="1.7979E-09" ixz="1.4814E-07" iyy="6.917E-06" iyz="-2.4077E-10" izz="7.2342E-06" />
    </inertial>
    <visual>
      <origin xyz="0 0 0" rpy="0 0 0" />
      <geometry>
        <mesh filename="package://selfModel/meshes/link5.STL" />
      </geometry>
      <material name="">
        <color rgba="0.2 0.2 0.2 1" />
      </material>
    </visual>
    <collision>
      <origin xyz="0 0 0" rpy="0 0 0" />
      <geometry>
        <mesh filename="package://selfModel/meshes/link5.STL" />
      </geometry>
    </collision>
  </link>
  <joint name="joint5" type="revolute">
    <origin xyz="0 0.0068 0.127" rpy="1.5708 -1.5708 0" />
    <parent link="link4" />
    <child link="link5" />
    <axis xyz="0 0 -1" />
    <limit lower="-2.094" upper="2.094" effort="12" velocity="0.628" />
    <dynamics damping="0.1" friction="0.1" />
  </joint>
  <link name="link6">
    <inertial>
      <origin xyz="0.0062045 0.0066121 0.016503" rpy="0 0 0" />
      <mass value="0.0053983" />
      <inertia ixx="1.9419E-06" ixy="2.2146E-07" ixz="2.1475E-07" iyy="1.9701E-06" iyz="2.2885E-07" izz="1.956E-06" />
    </inertial>
    <visual>
      <origin xyz="0 0 0" rpy="0 0 0" />
      <geometry>
        <mesh filename="package://selfModel/meshes/link6.STL" />
      </geometry>
      <material name="">
        <color rgba="0.79608 0.82353 0.93725 1" />
      </material>
    </visual>
    <collision>
      <origin xyz="0 0 0" rpy="0 0 0" />
      <geometry>
        <mesh filename="package://selfModel/meshes/link6.STL" />
      </geometry>
    </collision>
  </link>
  <joint name="joint6" type="continuous">
    <origin xyz="0.072 0 -0.0068" rpy="1.5708 0 1.5708" />
    <parent link="link5" />
    <child link="link6" />
    <axis xyz="0 0 -1" />
    <limit effort="20" velocity="0.377" />
    <dynamics damping="0.1" friction="0.1" />
  </joint>
</robot>
