xuzhihao-248/roboticArm/my/selfHardWarePCB/MotorDriver/20motorDriver/20驱动板原理图.pdf

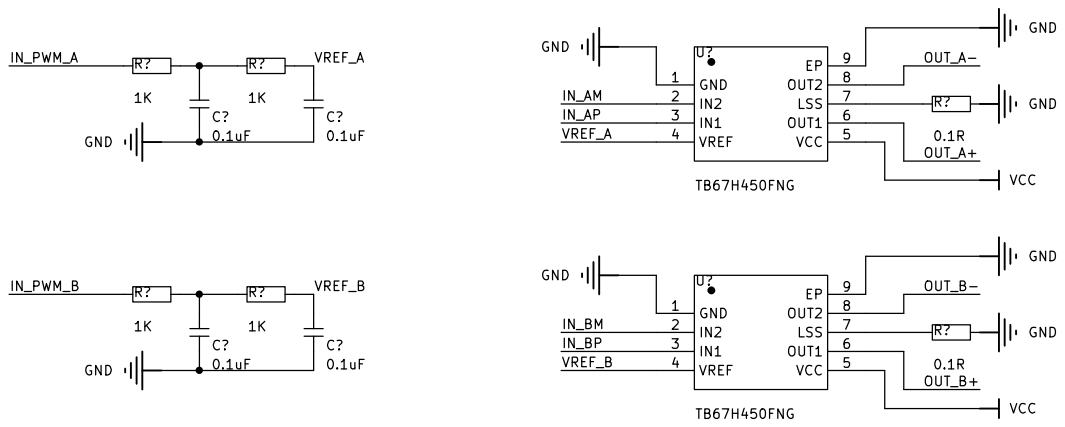
[picture p63: page 1]

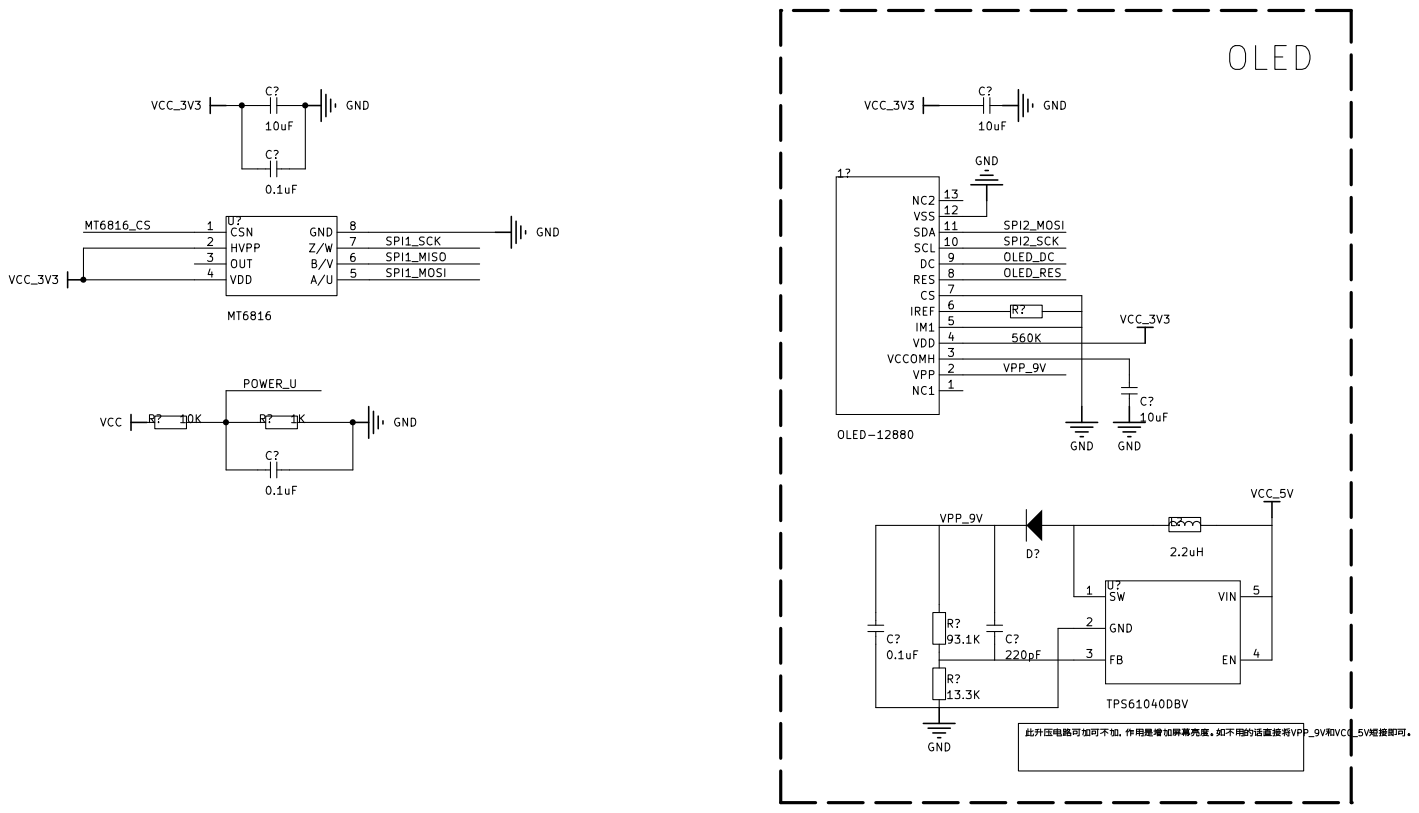
[picture p64: page 2]

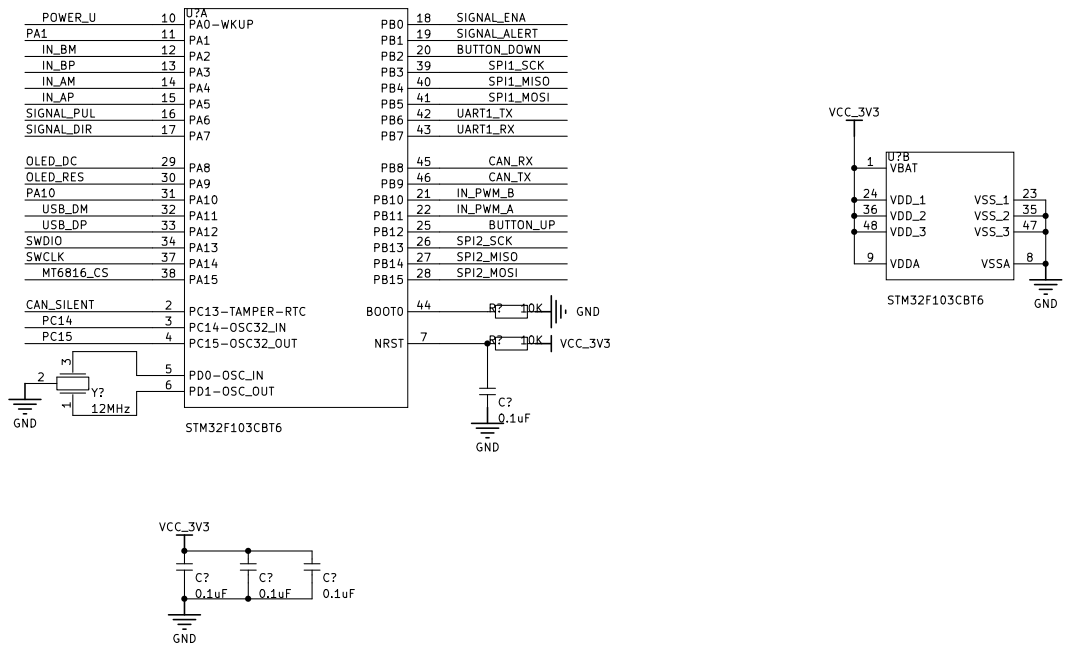
[picture p65: page 3]

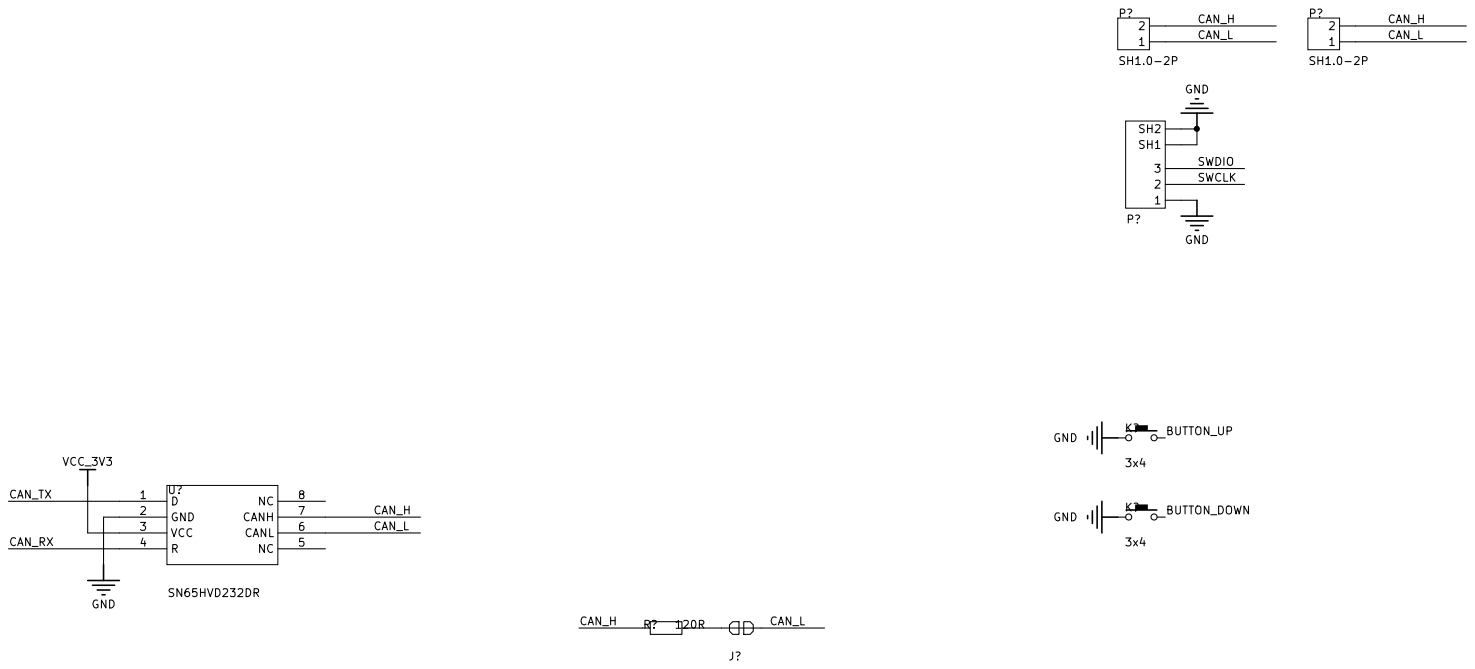
[picture p66: page 4]

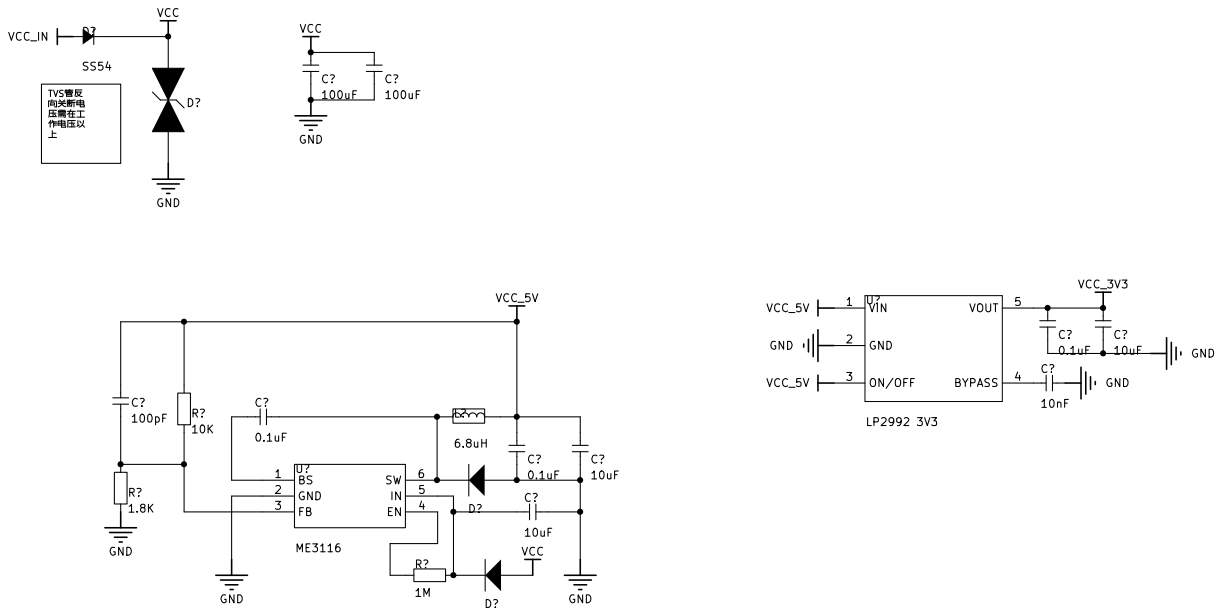
[picture p67: page 5]
