xuzhihao-248/roboticArm/my/selfHardWarePCB/MotorDriver/42motorDriver/42驱动板原理图.pdf

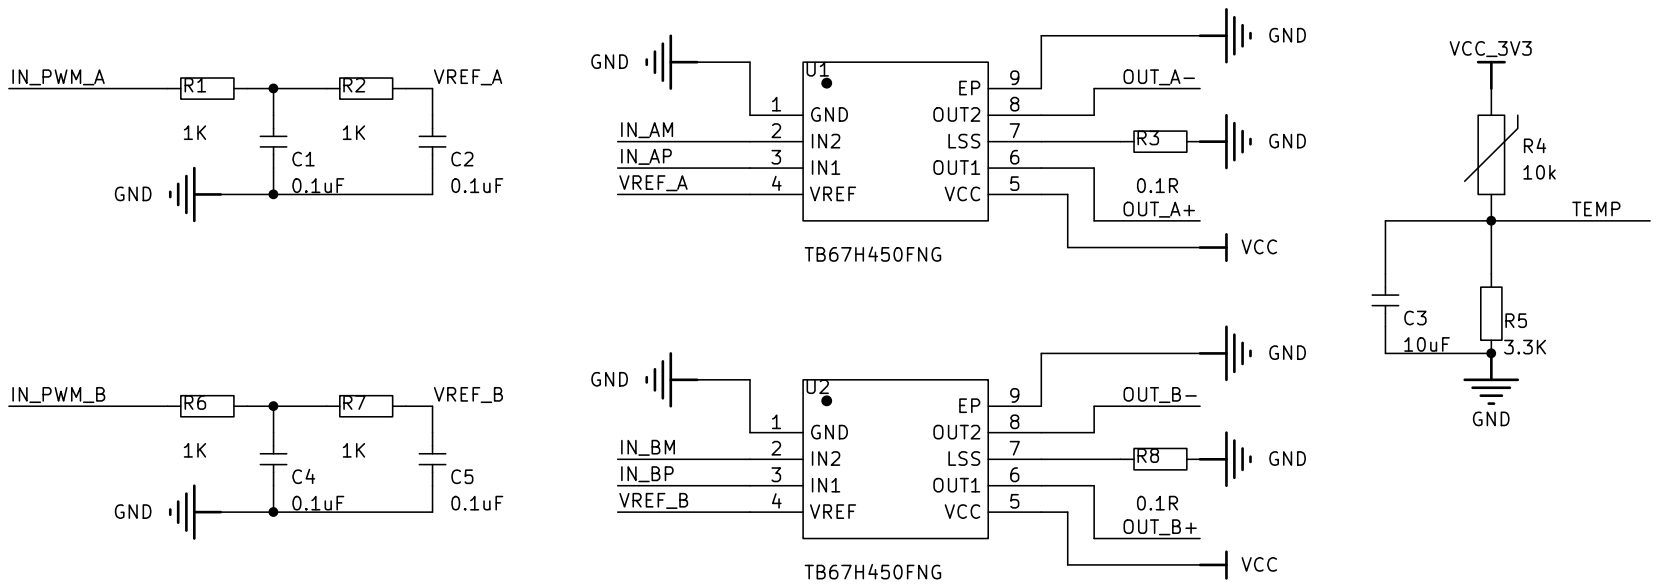
[picture p68: page 1]

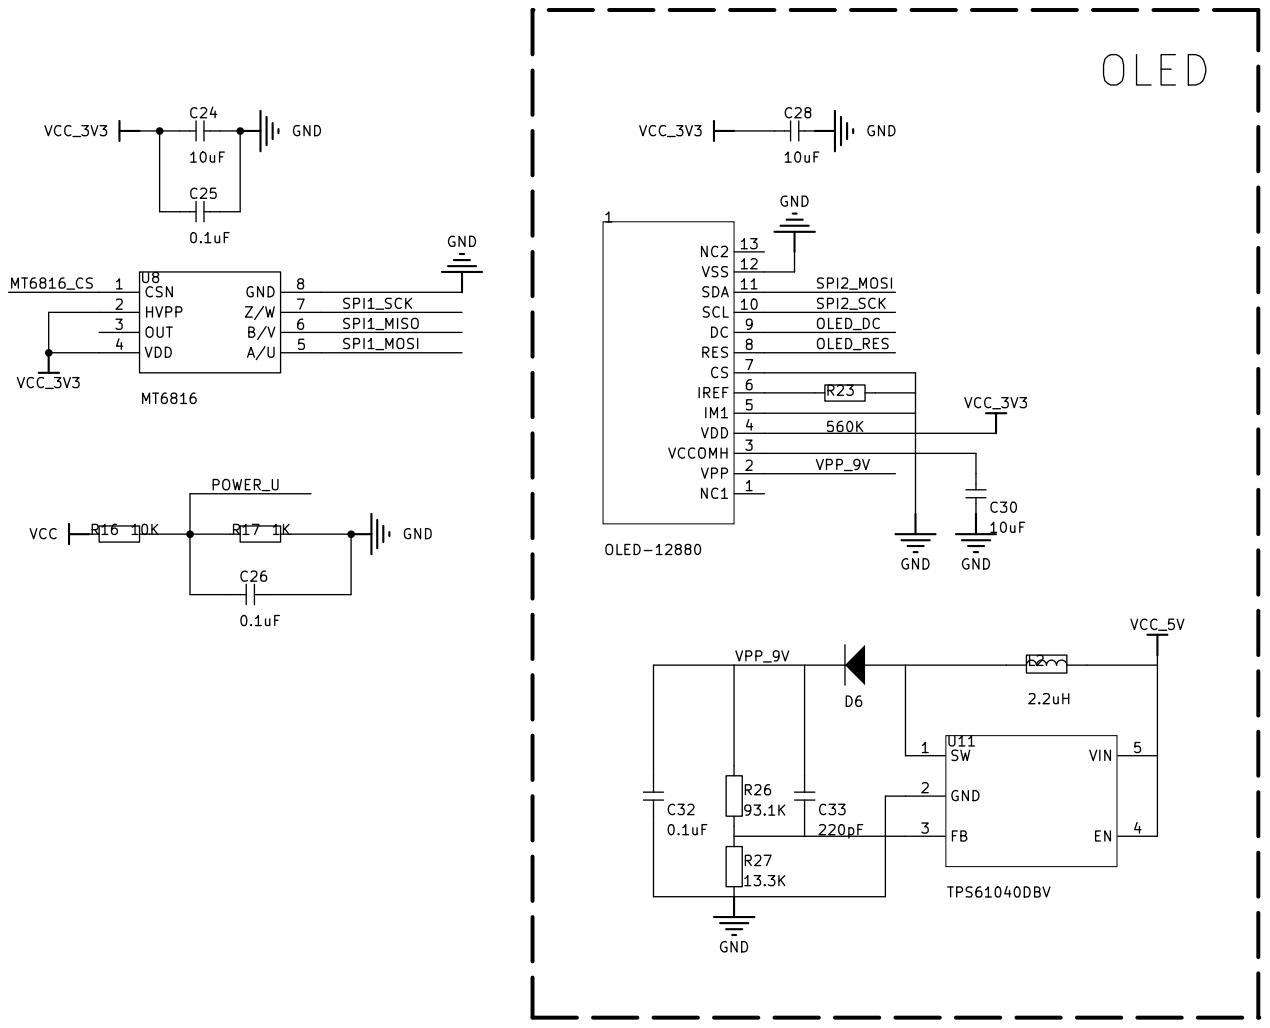
[picture p69: page 2]

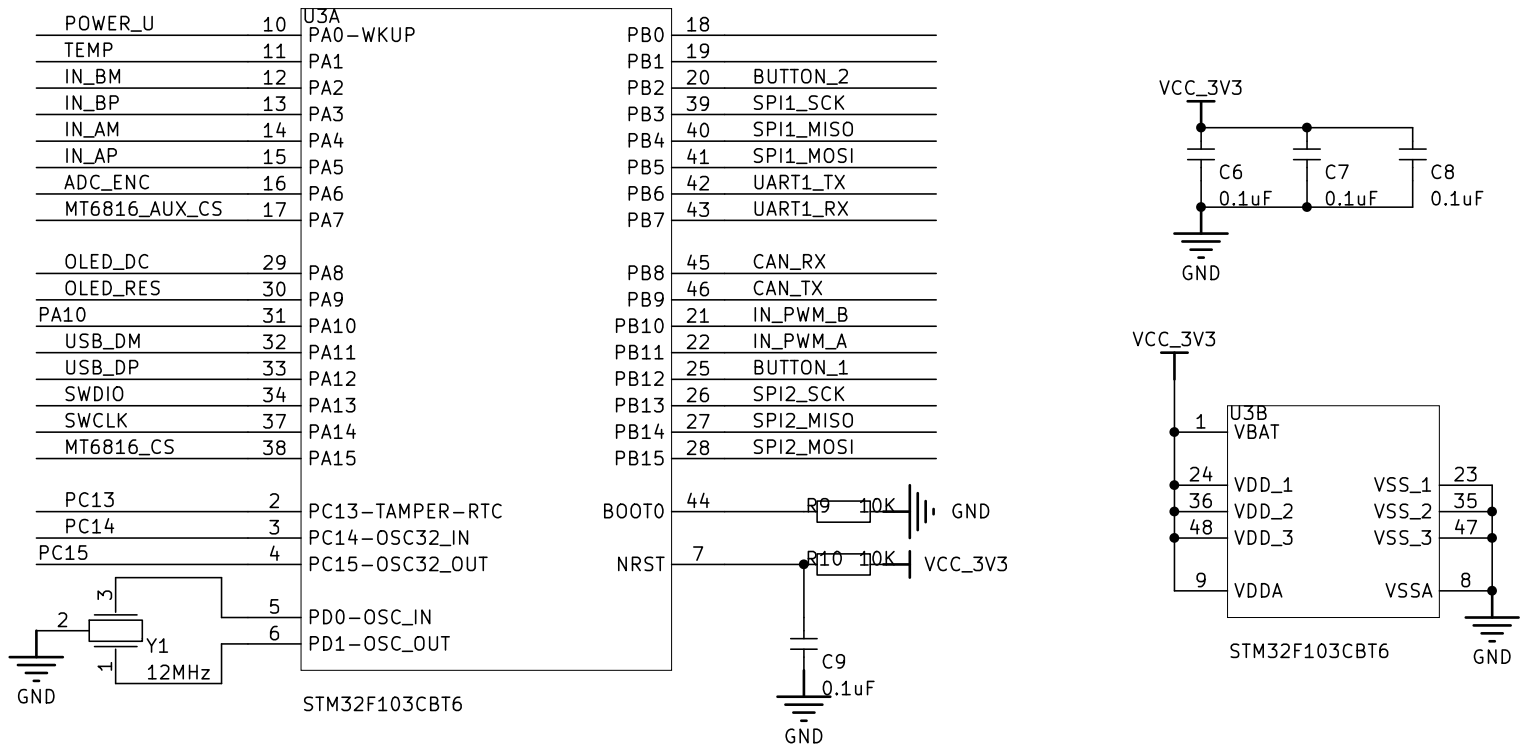
[picture p70: page 3]

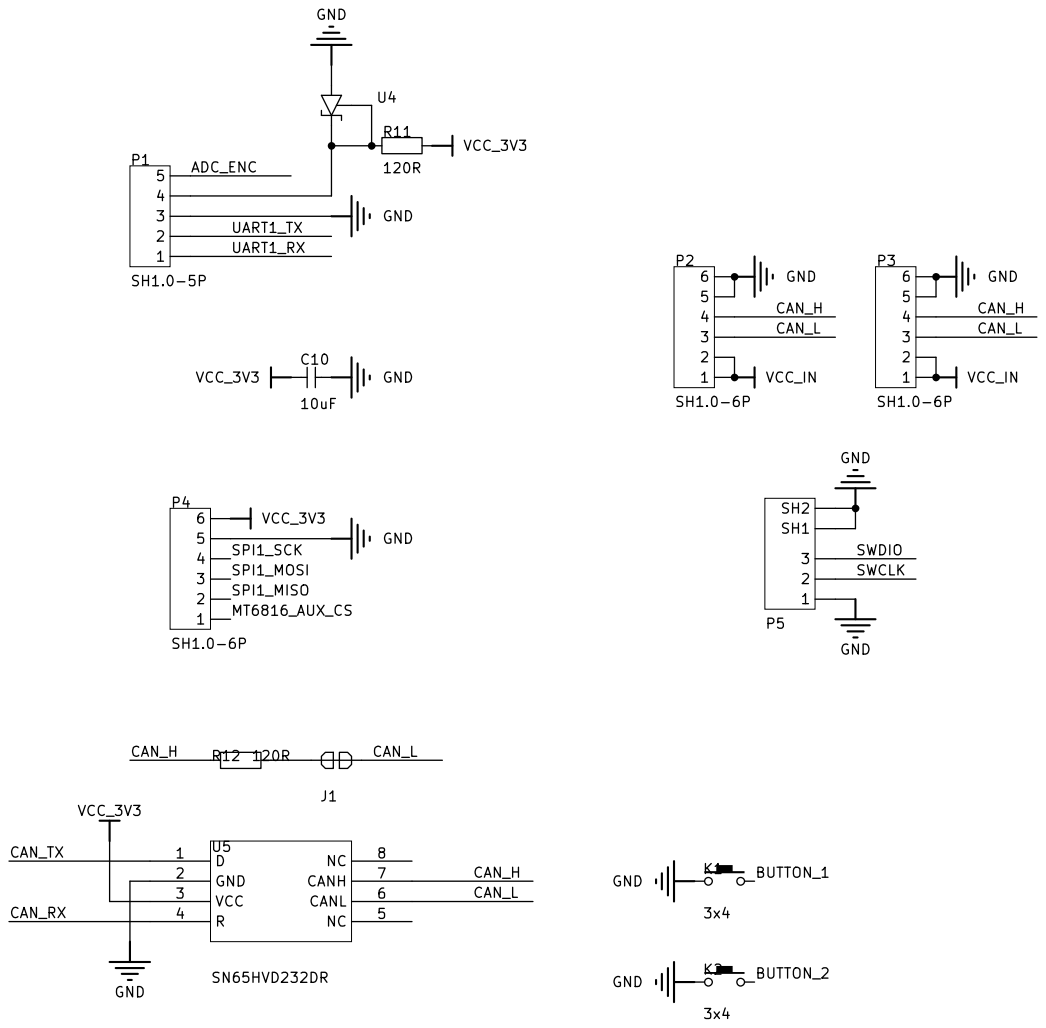
[picture p71: page 4]

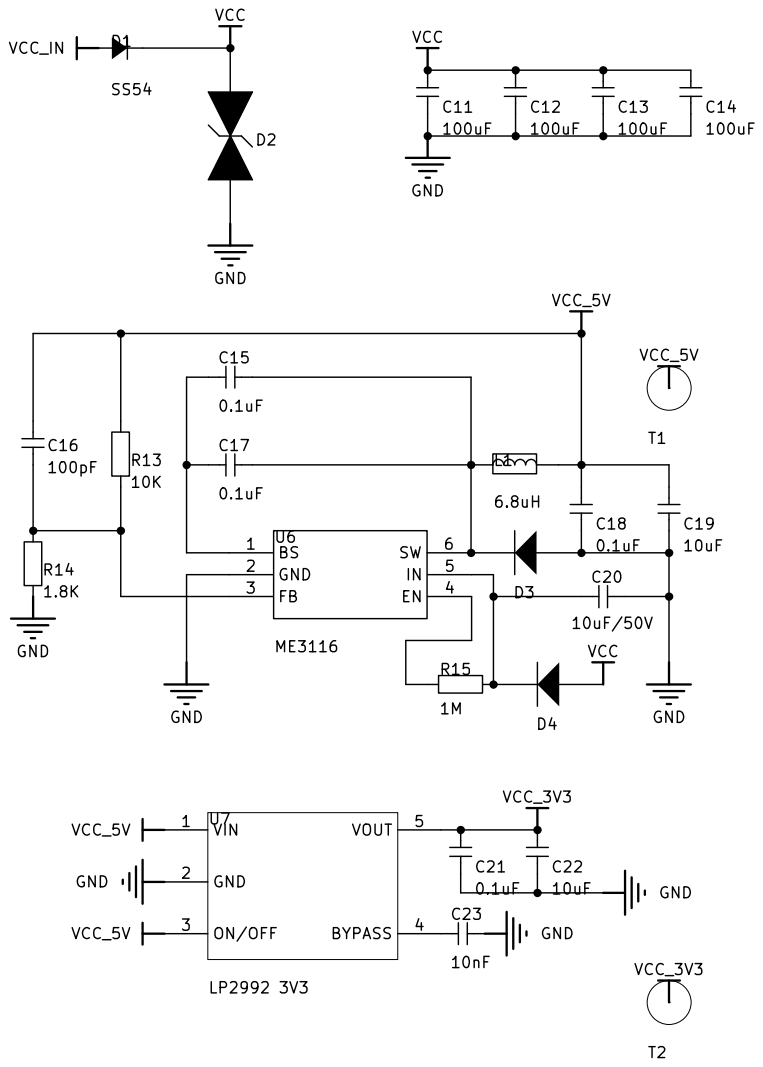
[picture p72: page 5]
