xuzhihao-248/roboticArm/(list of files, drawings)

Other design files:
raw/dummy/zhihui原版/Dummy-Robot-main/Hardware/Controller/Controller.PcbDoc
raw/dummy/zhihui原版/Dummy-Robot-main/Hardware/Controller/Controller.PrjPCB
raw/dummy/zhihui原版/Dummy-Robot-main/Hardware/Controller/Main.SchDoc
raw/dummy/zhihui原版/Dummy-Robot-main/Hardware/Dangle/Dangle.PcbDoc
raw/dummy/zhihui原版/Dummy-Robot-main/Hardware/Dangle/Dangle.PrjPCB
raw/dummy/zhihui原版/Dummy-Robot-main/Hardware/Dangle/Main.SchDoc
raw/dummy/zhihui原版/Dummy-Robot-main/Hardware/HandModule/HandModule.PcbDoc
raw/dummy/zhihui原版/Dummy-Robot-main/Hardware/HandModule/HandModule.PrjPCB
raw/dummy/zhihui原版/Dummy-Robot-main/Hardware/HandModule/Main.SchDoc
raw/dummy/zhihui原版/Dummy-Robot-main/Hardware/LedRing/LedRing.PcbDoc
raw/dummy/zhihui原版/Dummy-Robot-main/Hardware/LedRing/LedRing.PrjPCB
raw/dummy/zhihui原版/Dummy-Robot-main/Hardware/LedRing/Main.SchDoc
raw/dummy/zhihui原版/Dummy-Robot-main/Hardware/MotorDriver-20/Drive.SchDoc
raw/dummy/zhihui原版/Dummy-Robot-main/Hardware/MotorDriver-20/Interface.SchDoc
raw/dummy/zhihui原版/Dummy-Robot-main/Hardware/MotorDriver-20/MCU.SchDoc
raw/dummy/zhihui原版/Dummy-Robot-main/Hardware/MotorDriver-20/Motor-20.PcbDoc
raw/dummy/zhihui原版/Dummy-Robot-main/Hardware/MotorDriver-20/Motor-20.PrjPCB
raw/dummy/zhihui原版/Dummy-Robot-main/Hardware/MotorDriver-20/Port.SchDoc
raw/dummy/zhihui原版/Dummy-Robot-main/Hardware/MotorDriver-20/Power.SchDoc
raw/dummy/zhihui原版/Dummy-Robot-main/Hardware/MotorDriver-42/Motor-42.PcbDoc
raw/dummy/zhihui原版/Dummy-Robot-main/Hardware/MotorDriver-42/Port.SchDoc
raw/dummy/zhihui原版/Dummy-Robot-main/Hardware/MotorDriver-57-unused/Motor-57.PcbDoc
raw/dummy/zhihui原版/Dummy-Robot-main/Hardware/MotorDriver-57-unused/Motor-57.PrjPCB
raw/dummy/zhihui原版/Dummy-Robot-main/Hardware/REF/REF-Base/Main.SchDoc
raw/dummy/zhihui原版/Dummy-Robot-main/Hardware/REF/REF-Base/REF-Base.PcbDoc
raw/dummy/zhihui原版/Dummy-Robot-main/Hardware/REF/REF-Base/REF-Base.PrjPCB
raw/dummy/zhihui原版/Dummy-Robot-main/Hardware/REF/REF-Unit/Main.SchDoc
raw/dummy/zhihui原版/Dummy-Robot-main/Hardware/REF/REF-Unit/REF-Unit.PcbDoc
raw/dummy/zhihui原版/Dummy-Robot-main/Hardware/REF/REF-Unit/REF-Unit.PrjPCB
raw/dummy/zhihui原版/Peak-main/1.Hardware/Peak/Main.SchDoc
raw/dummy/zhihui原版/Peak-main/1.Hardware/Peak/Peak.PcbDoc
raw/dummy/zhihui原版/Peak-main/1.Hardware/Peak/Peak.PrjPCB
