xuzhihao-248/roboticArm/my/selfHardWarePCB/MotorDriver/42motorDriver/Motor-42.kicad_pcb

## KiCad design my/selfHardWarePCB/MotorDriver/42motorDriver/Motor-42.kicad_pcb (2026-07-18)

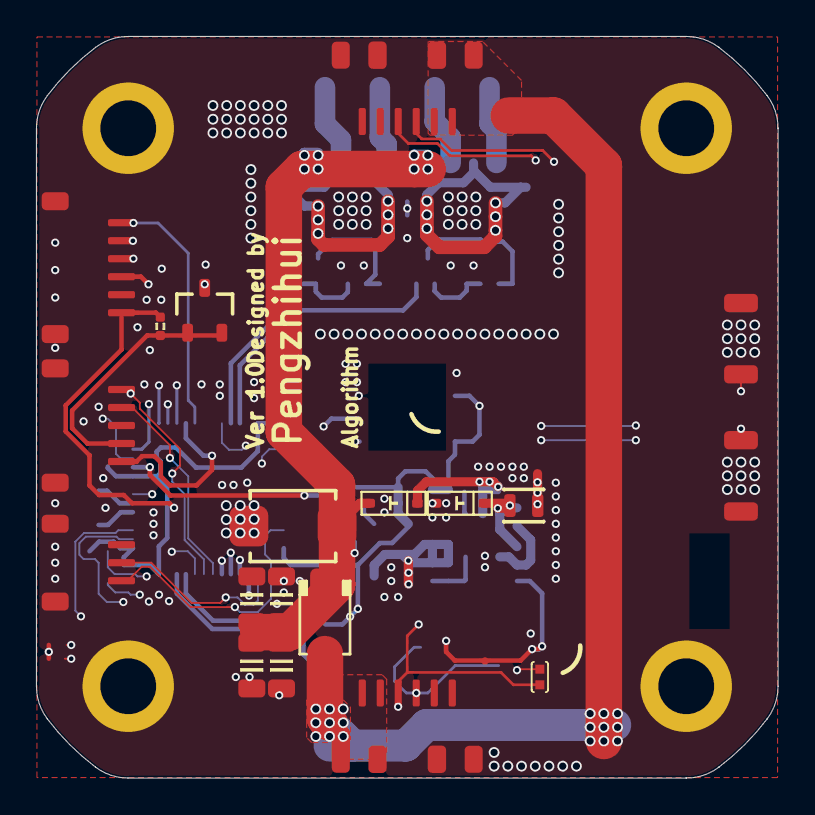
[picture p73: board Motor-42.kicad_pcb from above]

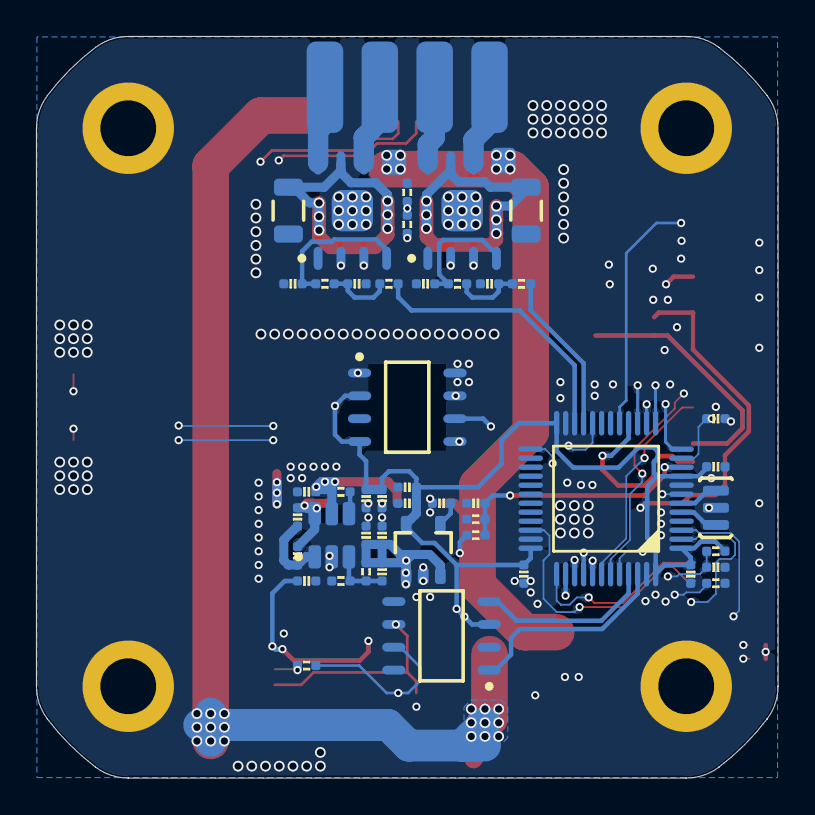
[picture p74: board Motor-42.kicad_pcb from below]

Board: 4 copper layers, 41.2 x 41.2 mm, 67 parts (46 on the bottom side), 47 nets.

Parts:
C1, C2, C4, C5, C6, C7, C8, C9, C15, C17, C18, C21, C25, C26: 0.1uF; CAP_0402
C3, C10, C19, C22, C24: 10uF; CAP_0402
C11, C12, C13, C14: 100uF; 1206-CAP
C16: 100pF; CAP_0402
C20: 10uF/50V; CAP_0402
C23: 10nF; CAP_0402
D1: SS54; DO-214AC
D2: SMBJ28CA; SMBJ-CA_MFG
D3, D4: 二极管-5819W; SOD-323
J1: 跳线; 0402-0R
K1, K2: TACT 2P; ButtonTACT_3x4x2_180
L1: 6.8uH; IND-201612
P1: SH1.0-5P
P2, P3, P4: SH1.0-6P
P5: SH1.0-3P
R1, R2, R6, R7, R17: 1K; RES_0402
R3, R8: 0.1R; 1206-RES
R4: NCP15XH103F03RC; RES_0402
R5: 3.3K; RES_0402
R9, R10, R13, R16: 10K; RES_0402
R11, R12: 120R; RES_0402
R14: 1.8K; RES_0402
R15: 1M; RES_0402
T1, T2: 测试点; TEST_PT
U1, U2: TB67H450FNG; SO-8-PAD
U3: STM32F103CBT6; LQFP-48
U4: TL431IDBZT; SOT23-3
U5: SN65HVD232D; SO-8
U6: ME3116; SOT23-6
U7: LP2992 3V3; SOT23-5
U8: MT6816; SO-8
Y1: 12MHz; 晶振-3P

Connections:
ADC_ENC: P1.5, U3.16
BUTTON_1: K1.2, U3.25
BUTTON_2: K2.2, U3.20
CAN_H: P2.4, P3.4, R12.1, U5.7
CAN_L: J1.2, P2.3, P3.3, U5.6
CAN_RX: U3.45, U5.4
CAN_TX: U3.46, U5.1
GND: C1.1, C2.1, C3.1, C4.1, C5.1, C6.1, C7.1, C8.1, C9.1, C10.1, C11.1, C12.1, C13.1, C14.1, C18.1, C19.1, C20.1, C21.1, C22.1, C23.1, C24.1, C25.1, C26.1, D2.1, D3.1, K1.1, K2.1, P1.3, P1.SH1, P1.SH2, P2.5, P2.6, P2.SH2, P3.5, P3.6, P3.SH2, P4.5, P4.SH1, P4.SH2, P5.1, P5.SH1, P5.SH2, R3.2, R5.1, R8.2, R9.2, R14.1, R17.2, U1.1, U1.9, U2.1, U2.9, U3.8, U3.23, U3.35, U3.47, U4.3, U5.2, U6.2, U7.2, U8.8, Y1.2
IN_AM: U1.2, U3.14
IN_AP: U1.3, U3.15
IN_BM: U2.2, U3.12
IN_BP: U2.3, U3.13
IN_PWM_A: R1.1, U3.22
IN_PWM_B: R6.1, U3.21
MT6816_AUX_CS: P4.1, U3.17
MT6816_CS: U3.38, U8.1
NetC1_2: C1.2, R1.2, R2.1
NetC4_2: C4.2, R6.2, R7.1
NetC9_2: C9.2, R10.1, U3.7
NetC15_1: C15.1, C17.1, D3.2, L1.1, U6.6
NetC15_2: C15.2, C17.2, U6.1
NetC16_2: C16.2, R13.1, R14.2, U6.3
NetC20_2: C20.2, D4.2, R15.1, U6.5
NetC23_2: C23.2, U7.4
NetJ1_1: J1.1, R12.2
NetP1_4: P1.4, R11.2, U4.1, U4.2
NetR3_1: R3.1, U1.7
NetR8_1: R8.1, U2.7
NetR9_1: R9.1, U3.44
NetR15_2: R15.2, U6.4
NetU3_5: U3.5, Y1.3
NetU3_6: U3.6, Y1.1
POWER_U: C26.2, R16.2, R17.1, U3.10
SPI1_MISO: P4.2, U3.40, U8.6
SPI1_MOSI: P4.3, U3.41, U8.5
SPI1_SCK: P4.4, U3.39, U8.7
SWCLK: P5.2, U3.37
SWDIO: P5.3, U3.34
TEMP: C3.2, R4.1, R5.2, U3.11
UART1_RX: P1.1, U3.43
UART1_TX: P1.2, U3.42
VCC: C11.2, C12.2, C13.2, C14.2, D1.2, D2.2, D4.1, R16.1, U1.5, U2.5
VCC_3V3: C6.2, C7.2, C8.2, C10.2, C21.2, C22.2, C24.2, C25.2, P4.6, R4.2, R10.2, R11.1, T2.0, U3.1, U3.9, U3.24, U3.36, U3.48, U5.3, U7.5, U8.2, U8.4
VCC_5V: C16.1, C18.2, C19.2, L1.2, R13.2, T1.0, U7.1, U7.3
VCC_IN: D1.1, P2.1, P2.2, P2.SH1, P3.1, P3.2, P3.SH1
VREF_A: C2.2, R2.2, U1.4
VREF_B: C5.2, R7.2, U2.4
