xuzhihao-248/roboticArm/my/selfHardWarePCB/Controller/Controller.kicad_pcb

## KiCad design my/selfHardWarePCB/Controller/Controller.kicad_pcb (2026-06-10)

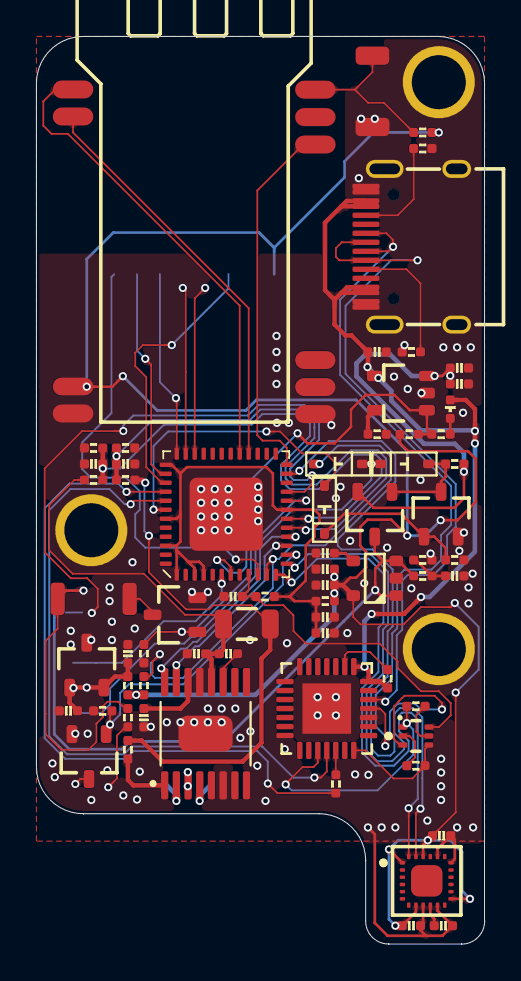
[picture p75: board Controller.kicad_pcb from above]

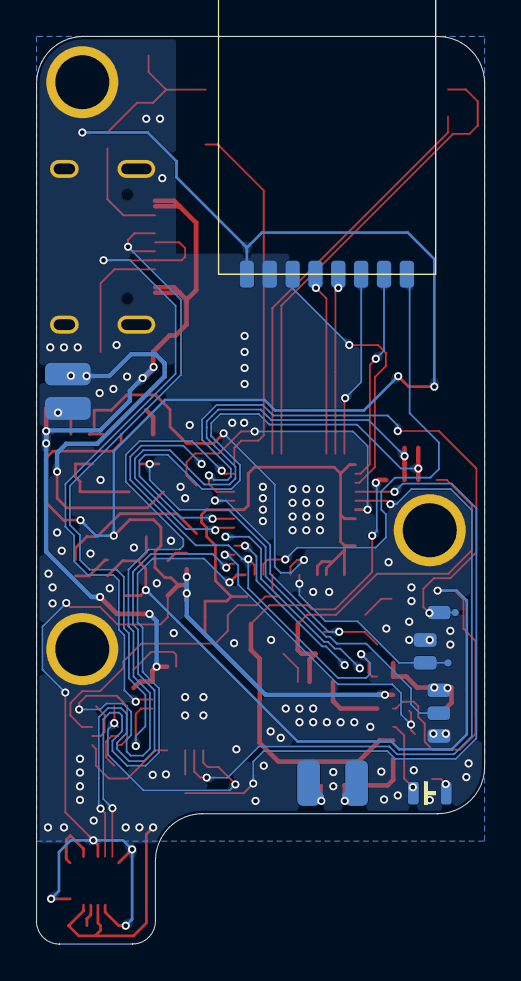
[picture p76: board Controller.kicad_pcb from below]

Board: 2 copper layers, 24.9 x 50.4 mm, 71 parts (4 on the bottom side), 60 nets.

Parts:
C1, C5, C13, C15, C17, C19: 0.1uF; CAP_0402
C2, C6, C7, C8, C9, C11, C12, C14, C18: 10uF; CAP_0402
C3: 2.2uF; CAP_0402
C4, C10, C16: 10nF; CAP_0402
C20: 1uF; CAP_0402
D1, D2, D3: 二极管-5819W; SOD-323
D4: color?; LED_0402_RED
D5: color?; LED_0805_RED
K1: TACT 2P; ButtonTACT_3x4x2_180
Q1: AO3401A; SOT23-3
Q2, Q4, Q5: AO3400A; SOT23-3
Q3: BC847BVC-7; SOT563-6
R1, R8, R9, R17, R22, R23, R25, R26, R27: 10K; RES_0402
R2, R4: 100K; RES_0402
R3, R5, R6, R13: 20K; RES_0402
R7: 200R; RES_0402
R10, R24: 47K; RES_0402
R11: 120R; RES_0402
R12: 1R; 1206-RES
R14: 2K; RES_0402
R15, R18: 12K; RES_0402
R16: 1K; RES_0402
R19, R20: 5.1K; RES_0402
R21: 0R; RES_0402
T1, T2: 测试点; TEST_PT
U1: CP2102; QFN-28
U2: LP2992 3V3; SOT23-5
U3: DRV8833PW; TSSOP-16
U4: TL431IDBZT; SOT23-3
U5: MCP73831T; SOT23-5
U6: MPU9250; QFN-24-3x3
U7: DET402
U8: HC-06; 蓝牙模块HC-06
U9: NRF24L01; NRF24L01-MODULE
U10: ESP32_SIP; QFN-48_7X7
USB1: Type-C; Type-C-TOP

Connections:
3V3A: C18.2, C19.2, R21.2, R25.1, U10.1, U10.3, U10.4, U10.19, U10.37, U10.43, U10.46
BAT_DET_1: C5.2, R2.1, R4.2
BOOT_1: Q3.3, U10.23
BT_SET_1: K1.1, R24.2, U8.34
BUZZ_1: Q4.1, R26.2, U10.20
CHG_DET_1: R16.2, R17.1, U5.1, U10.7
CP_Rx_1: U1.25, U10.41
CP_Tx_1: R7.1, U10.40
DTR_1: Q3.4, R15.1, U1.28
EC_KEY_1: D1.2, D2.2
EC_KEY_DET_1: D2.1, R22.2, U10.11
ESP_EN_1: C20.1, Q3.6, R25.2, U10.9
GND: C1.1, C2.1, C3.1, C4.1, C5.1, C6.1, C7.1, C8.1, C9.1, C11.1, C12.1, C13.1, C14.1, C15.2, C16.2, C17.1, C18.1, C19.1, C20.2, K1.2, Q2.2, Q4.2, Q5.2, R4.1, R8.1, R9.1, R13.1, R14.2, R19.1, R20.2, R26.1, R27.1, U1.3, U1.29, U2.2, U3.3, U3.6, U3.13, U3.PAD, U4.3, U5.2, U6.9, U6.11, U6.18, U6.20, U8.13, U8.22, U9.2, U10.49, USB1.1, USB1.2, USB1.3, USB1.4, USB1.A1, USB1.A12, USB1.B1, USB1.B12
GPIO4_1: U8.32, U10.24
GPIO5_1: U9.4, U10.34
GPIO9_1: U8.2, U10.28
GPIO10_1: U8.1, U10.29
GPIO12_1: C7.2, R6.1, R9.2, U10.18
GPIO14_1: C6.2, R5.1, R8.2, U10.17
GPIO15_1: T2.0, U10.21
GPIO18_1: U9.5, U10.35
GPIO19_1: U9.7, U10.38
GPIO21_1: D3.1, U10.42
GPIO22_1: U9.3, U10.39
GPIO23_1: U9.6, U10.36
GPIO25_1: Q5.1, R27.2, U10.14
GPIO26_1: U3.15, U10.15
GPIO27_1: U3.16, U10.16
GPIO32_1: U6.24, U10.12
GPIO33_1: U6.23, U10.13
GPIO34_1: U9.8, U10.10
GPIO37_1: T1.0, U10.6
NetC3_2: C3.2, U3.14
NetC4_2: C4.2, U2.4
NetC10_2: C10.2, U3.11
NetC17_2: C17.2, U6.10
NetD1_1: D1.1, Q1.1, Q2.3, R3.2
NetD3_2: D3.2, Q2.1, R13.2
NetD4_2: D4.2, R16.1
NetD5_1: D5.1, R23.1
NetD5_2: D5.2, Q5.3
NetQ3_2: Q3.2, R15.2
NetQ3_5: Q3.5, R18.2
NetQ4_3: Q4.3, U7.2
NetR1_2: R1.2, U1.9
NetR7_2: R7.2, U1.26
NetR10_1: R10.1, U3.1
NetR14_1: R14.1, U5.5
NetR19_2: R19.2, USB1.B5
NetR20_1: R20.1, USB1.A5
RTS_1: Q3.1, R18.1, U1.24
SENSE_1_N: C10.1, C11.2, R6.2, R12.1, U3.12
USB-PWR-DM_1: U1.5, USB1.A7, USB1.B7
USB-PWR-DP_1: U1.4, USB1.A6, USB1.B6
VBAT: Q1.3, R2.2, R23.2, U2.1, U2.3, U7.1
VBAT_IN: C12.2, C13.2, Q1.2, R3.1, U5.3
VCC_3V3: C1.2, C2.2, C15.1, C16.1, R11.1, R17.2, R21.1, R22.1, R24.1, U2.5, U6.1, U6.8, U6.13, U6.22, U8.12, U9.1
VCC_5V: R5.2, R10.2, R12.2
VREF_2V5: C8.2, C9.2, R11.2, U4.1, U4.2
VUSB: C14.2, D4.1, R1.1, U1.7, U1.8, U5.4, USB1.A4, USB1.A9, USB1.B4, USB1.B9
