xuzhihao-248/roboticArm/my/selfHardWarePCB/MotorDriver/20motorDriver/Motor-20.kicad_pcb

## KiCad design my/selfHardWarePCB/MotorDriver/20motorDriver/Motor-20.kicad_pcb (2026-06-09)

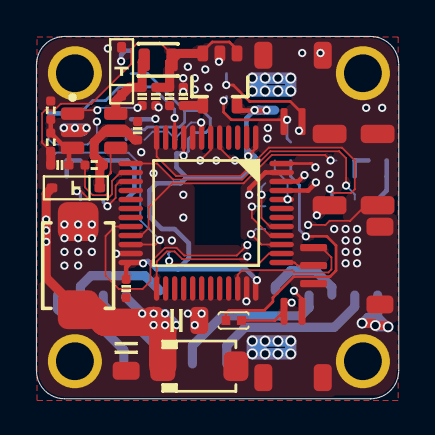
[picture p77: board Motor-20.kicad_pcb from above]

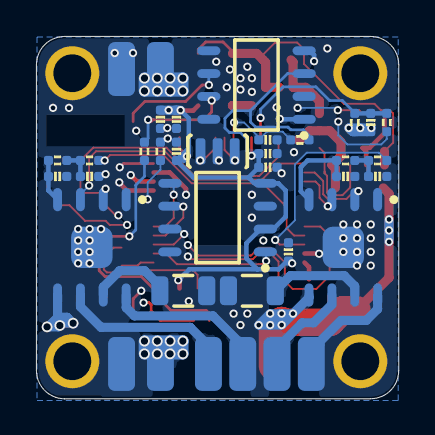
[picture p78: board Motor-20.kicad_pcb from below]

Board: 4 copper layers, 20.1 x 20.1 mm, 54 parts (28 on the bottom side), 40 nets.

Parts:
C1, C2, C3, C4, C5, C6, C7, C8, C11, C15, C16, C20, C21: 0.1uF; CAP_0402
C9, C10: 100uF; 1206-CAP
C12, C17, C18, C19: 10uF; CAP_0402
C13: 10nF; CAP_0402
C14: 100pF; CAP_0402
D1: SS54; DO-214AC
D2: SMBJ28CA; SMBJ-CA_MFG
D3, D4: 二极管-5819W; SOD-323
J1: 跳线; 0402-0R
K1, K2: TACT 2P; ButtonTACT_3x4x2_180
L1: 6.8uH; IND-201612
P1, P2: SH1.0-2P
P3: SH1.0-3P
R1, R2, R4, R5, R14: 1K; RES_0402
R3, R6: 0.1R; 1206-RES
R7, R8, R10, R13: 10K; RES_0402
R9: 120R; RES_0402
R11: 1.8K; RES_0402
R12: 1M; RES_0402
U1, U2: TB67H450FNG; SO-8-PAD
U3: STM32F103CBT6; LQFP-48
U4: SN65HVD232D; SO-8
U5: LP2992 3V3; SOT23-5
U6: ME3116; SOT23-6
U7: MT6816; SO-8
Y1: 12MHz; 晶振-3P

Connections:
BUTTON_DOWN: K2.2, U3.20
BUTTON_UP: K1.2, U3.25
CAN_H: P1.2, P2.2, R9.1, U4.7
CAN_L: J1.2, P1.1, P2.1, U4.6
CAN_RX: U3.45, U4.4
CAN_TX: U3.46, U4.1
GND: C1.1, C2.1, C3.1, C4.1, C5.1, C6.1, C7.1, C8.1, C9.1, C10.1, C11.1, C12.1, C13.1, C16.1, C17.1, C18.1, C19.1, C20.1, C21.1, D2.1, D3.1, K1.1, K2.1, P1.SH1, P1.SH2, P2.SH1, P2.SH2, P3.1, P3.SH1, P3.SH2, R3.2, R6.2, R7.2, R11.1, R14.2, U1.1, U1.9, U2.1, U2.9, U3.8, U3.23, U3.35, U3.47, U4.2, U5.2, U6.2, U7.8, Y1.2
IN_AM: U1.2, U3.14
IN_AP: U1.3, U3.15
IN_BM: U2.2, U3.12
IN_BP: U2.3, U3.13
IN_PWM_A: R1.1, U3.22
IN_PWM_B: R4.1, U3.21
MT6816_CS: U3.38, U7.1
NetC1_2: C1.2, R1.2, R2.1
NetC3_2: C3.2, R4.2, R5.1
NetC5_2: C5.2, R8.1, U3.7
NetC13_2: C13.2, U5.4
NetC14_2: C14.2, R10.1, R11.2, U6.3
NetC15_1: C15.1, D3.2, L1.1, U6.6
NetC15_2: C15.2, U6.1
NetC18_2: C18.2, D4.2, R12.1, U6.5
NetJ1_1: J1.1, R9.2
NetR3_1: R3.1, U1.7
NetR6_1: R6.1, U2.7
NetR7_1: R7.1, U3.44
NetR12_2: R12.2, U6.4
NetU3_5: U3.5, Y1.3
NetU3_6: U3.6, Y1.1
POWER_U: C21.2, R13.2, R14.1, U3.10
SPI1_MISO: U3.40, U7.6
SPI1_MOSI: U3.41, U7.5
SPI1_SCK: U3.39, U7.7
SWCLK: P3.2, U3.37
SWDIO: P3.3, U3.34
VCC: C9.2, C10.2, D1.2, D2.2, D4.1, R13.1, U1.5, U2.5
VCC_3V3: C6.2, C7.2, C8.2, C11.2, C12.2, C19.2, C20.2, R8.2, U3.1, U3.9, U3.24, U3.36, U3.48, U4.3, U5.5, U7.2, U7.4
VCC_5V: C14.1, C16.2, C17.2, L1.2, R10.2, U5.1, U5.3
VREF_A: C2.2, R2.2, U1.4
VREF_B: C4.2, R5.2, U2.4
