xuzhihao-248/roboticArm/raw/motor42Drvier/JH_FOC_42V3开源代码/JH_FOC_42V3驱动器开源学习代码/F103_CAN_USB.ioc

Mcu.UserName=STM32F103C8Tx
PA0-WKUP.Signal=ADCx_IN0
PA1.Signal=GPIO_Input
PA11.Signal=USB_DM
PA12.Signal=USB_DP
PA13.Signal=SYS_JTMS-SWDIO
PA14.Signal=SYS_JTCK-SWCLK
PA15.Signal=S_TIM2_CH1_ETR
PA2.GPIO_Label=RLimit
PA2.Signal=GPIO_Input
PA3.GPIO_Label=Llimit
PA3.Signal=GPIO_Input
PA4.GPIO_Label=SPI_CS
PA4.Signal=GPIO_Output
PA5.Signal=SPI1_SCK
PA6.Signal=SPI1_MISO
PA7.Signal=SPI1_MOSI
PB0.Signal=ADCx_IN8
PB1.Signal=ADCx_IN9
PB10.Signal=S_TIM2_CH3
PB11.Signal=S_TIM2_CH4
PB12.GPIO_Label=LED
PB12.Signal=GPIO_Output
PB3.Signal=S_TIM2_CH2
PB8.Signal=CAN_RX
PB9.Signal=CAN_TX
PD0-OSC_IN.Signal=RCC_OSC_IN
PD1-OSC_OUT.Signal=RCC_OSC_OUT
