xuzhihao-248/roboticArm/raw/motor42Drvier/JH_FOC_42V3开源代码/JH_FOC_42V3驱动器开源学习代码/Core/Inc/main.h

#define RLimit_Pin GPIO_PIN_2
#define RLimit_GPIO_Port GPIOA
#define Llimit_Pin GPIO_PIN_3
#define Llimit_GPIO_Port GPIOA
#define SPI_CS_Pin GPIO_PIN_4
#define SPI_CS_GPIO_Port GPIOA
#define LED_Pin GPIO_PIN_12
#define LED_GPIO_Port GPIOB
