xuzhihao-248/roboticArm/raw/motor42Drvier/JH_FOC_42V3开源代码/JH_FOC_42V3驱动器开源学习代码/Core/Inc/can.h

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
/* Define to prevent recursive inclusion -------------------------------------*/
#ifndef __CAN_H__
#define __CAN_H__

#ifdef __cplusplus
extern "C" {
#endif

/* Includes ------------------------------------------------------------------*/
#include "main.h"

/* USER CODE BEGIN Includes */
	typedef struct
	{
		uint32_t mailbox;
		CAN_TxHeaderTypeDef hdr;
		uint8_t payload[8];
	}CAN_TxPacketTypeDef;

	typedef struct
	{
		CAN_RxHeaderTypeDef hdr;
		uint8_t payload[8];
		uint8_t can_rx_flag;//是否接收到消息标记
	}CAN_RxPacketTypeDef;
/* USER CODE END Includes */

extern CAN_HandleTypeDef hcan;

/* USER CODE BEGIN Private defines */
extern CAN_TxPacketTypeDef my_can_tx;
extern CAN_RxPacketTypeDef my_can_rx;
	extern uint8_t can_Prescaler;
/* USER CODE END Private defines */

void MX_CAN_Init(void);

/* USER CODE BEGIN Prototypes */
void CAN_Init(void);
uint8_t CAN_Transmit(CAN_TxPacketTypeDef* packet);

/* USER CODE END Prototypes */

#ifdef __cplusplus
}
#endif

#endif /* __CAN_H__ */
