xuzhihao-248/roboticArm/(commit log)

2026-05-23 初始化，在doc文件中创建指导文档Github协作指南.md
2026-05-23 修改了文档
2026-05-23 加了一些内容在里面
2026-05-23 添加了linux命令行的操作指南
2026-05-23 添加文档recoder.md，方便记录工作流程
2026-05-23 整理了一些资料
    [Case v17.step, Controller.PcbDoc, Controller.PrjPCB, Dangle.PcbDoc, Dangle.PrjPCB, Drive.SchDoc, HandModule.PcbDoc, HandModule.PrjPCB]
2026-05-23 整理文档
2026-05-23 修改了文件
    [Case v17.step, Controller.PcbDoc, Controller.PrjPCB, Dangle.PcbDoc, Dangle.PrjPCB, Drive.SchDoc, HandModule.PcbDoc, HandModule.PrjPCB]
2026-05-23 修改了一些文档
2026-05-24 加入了程序和固件
    [configurations.h, serial_config.txt, stlink.cfg]
2026-06-06 在rviz中运行了机械臂的模型
    [base_link.STL, link1.STL, link2.STL, link3.STL, link4.STL, link5.STL, myRobot.SLDASM, my_Robot.csv]
2026-06-06 设置了MoveIt并且成功进行了轨迹规划，遇到的问题和解决方案记载在文档recoder
2026-06-07 git使用测试
2026-06-07 测试完成，恢复原先状态
2026-06-07 规范了git流程
2026-06-07 添加了几个文档，理解原版项目中的固件、软件、电路板
2026-06-07 导出了BOM表
    [Drive.SchDoc, Interface.SchDoc, Interface.kicad_sch, MCU.SchDoc, MCU.kicad_sch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]
2026-06-07 步进42驱动引脚说明
2026-06-07 增加了bom表
    [Motor-42(bom).xlsx]
2026-06-08 测量了电机和减速器的关键尺寸
    [Drive.SchDoc, Interface.SchDoc, Interface.kicad_sch, MCU.SchDoc, MCU.kicad_sch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]
2026-06-08 文档整理
2026-06-08 转移文件至my文件夹下，已保留原始问价raw
    [Motor-42(bom).xlsx, Motor-42.PcbDoc, Port.SchDoc]
2026-06-09 确认了BOM表
    [Drive.SchDoc, Interface.SchDoc, Interface.kicad_sch, MCU.SchDoc, MCU.kicad_sch, Motor-20-Bom.xlsx, Motor-20.csv, Motor-20.kicad_pcb]
2026-06-10 记录了Unity开发上位机的过程
    [Controller.kicad_pcb, Controller.kicad_sch, 采购订单.xlsx]
2026-06-12 unity上位机的开发
    [采购订单.xlsx]
2026-06-15 unity开发上位机
    [2 (3) (1) (1).SLDASM, 3D打印盖.SLDPRT, Joint6.SLDASM, P3 (3) (1) (1).SLDASM, P5 (1) (1) (1) (1).SLDASM, PK513PA-H50S v1.SLDPRT, SH03W_KORP (3) (1) (1).SLDPRT, SHXX_PIN_(1) (3) (1) (1).SLDPRT]
2026-06-16 Unity上位机的开发，详情在Recoder中
2026-06-22 焊好了第一块板子但是stm32不能识别，需要电源验证
    [采购订单.xlsx]
2026-07-18 feat: JH_FOC_42V3 CAN CLI工具 + CAN协议文档 + 驱动板参考资料
    - 新增 my/tools/: 三层模块化CAN控制工具 (protocol/driver/cli)
    - jh_foc_protocol.py: CAN协议常量、命令构建、响应解析
    - jh_foc_driver.py: 单/多电机控制 + CAN扫描连接
    - motor_cli.py: cmd.Cmd交互终端 + PTP/Swing/Torque测试套件
    - 更新 doc/recorder.md: CAN协议速查表 + CLI命令速查 + 测试报告
    - 新增 raw/motor42Drvier/: JH_FOC_42V3说明书 + 开源代码
    - 新增 raw/USB转CAN/: candleLight/pcan固件参考资料
    - 更新 .gitignore: 排除 .venv/ __pycache__ 临时文件
    - 更新 KiCad PCB 文件
    [Motor-42.kicad_pcb]
